EDWARDPJ26/microohmetro-uis/informe/Informe_final_micro-ohmimetro_v2.pdf

### UNIVERSIDAD INDUSTRIAL DE SANTANDER

Escuela de Ingenierías Eléctrica, Electrónica y de Telecomunicaciones

## DISEÑO DE UN MICRO-OHMÍMETRO DE PRECISIÓN

## 1 mΩ – 1 Ω, portátil, con medición Kelvin de 4 hilos

Informe final consolidado – versión 2 (con las correcciones del docente)

Edward Andrés Pacheco Jurado – 2222236 – A1A

Joseph Thomas Albarracín Contreras – 2220415 – A1B

Diseño de Sistemas Electrónicos Docente: Jaime Barrero

Bucaramanga, Santander – 2026

Repositorio de respaldo (esquemáticos, PCB, Gerbers, simulaciones, datos, firmware, imágenes en alta resolución y datasheets): github.com/EDWARDPJ26/microohmetro-uis (versión etique-tada v1.0).

Micro-ohmímetro de precisión – versión 2 | UIS – E3T

### Índice

Resumen | 1
1. Requerimientos y correcciones atendidas | 1
2. Arquitectura general | 2
3. Fuente de corriente pulsada de dos niveles | 3
4. Medición Kelvin y adquisición con el AD7124-4 | 3
5. Energía: USB-C PD, cargador, polaridad y regulación | 4
6. Microcontrolador y firmware | 4
7. Simulaciones (PSpice 22.1) | 4
8. Presupuesto de error | 6
9. Diseño de PCB | 6
10.Materiales, BOM y datasheets | 9
11.Aplicación móvil | 9
12.Conclusiones | 10
13.Trabajo futuro | 10
A. Esquemático completo (hojas de detalle) | 11
B. Repositorio de respaldo | 15

i

### Índice de figuras

1. Esquemático, hoja raíz: diagrama de bloques y flujo de señales (rojo: potencia, verde:
| medición, morado: control) | | 2
2. | Hoja 4: fuente de corriente pulsada (cadena cableada pin a pin) | | 3
3. | Cadena de medición | | 4
4. S2: pulso de dos niveles (IL → IH a 12 ms, apagado a 20 ms). Sin sobrepico; asenta-
| miento de 3,3 ms al 0,01 % | | 5
5. | S4: Montecarlo (300 corridas). Izquierda: σ = 0,057 %. Derecha: σ = 88 % en 10 mΩ. . | 5
6. | Vistas 3D de la PCB (render de KiCad 10) | | 7
7. | Plano mecánico acotado: 64 mm × 116 mm | | 8
8. | Pantallas de medición y gráfica de la aplicación | | 10
9. | Esquemático, página 2: Entrada USB-C y Power Delivery | | 11
10. Esquemático, página 3: Cargador y batería | | 12
11. Esquemático, página 4: Regulación 3,3 V | | 13
12. Esquemático, página 8: Microcontrolador ESP32-C3 | | 14
13. Esquemático, página 9: Mecánicos y puntos de prueba | | 15

### Índice de tablas

1. | Correcciones del docente y cómo se atendieron | | 1
2. | Especificaciones del instrumento | | 2
3. Configuración de canales del AD7124-4 (referencia interna de 2,5 V, post-filtro de 25
| SPS) | | 3
4. | Presupuesto energético sobre SYS | | 4
5. | Resultados DC (S1): idénticos con SYS = 3,5 V y 4,35 V | | 5
6. | S3: efecto del offset del OPA388 y de la FEM termoeléctrica (RDUT = 1 mΩ) | | 5
7. | S4/S5: Montecarlo y sensibilidad (Worst-Case) | | 6
8. | Presupuesto de error estimado (RDUT = 1 mΩ, una medición) | | 6
9. | Especificaciones físicas de la PCB | | 8
10. Materiales de resistencias y capacitores | | 9
11. Componentes principales y enlaces a datasheets | | 9

ii

### Resumen

Se presenta el diseño completo de un micro-ohmímetro portátil para el rango 1 mΩ–1 Ω. La versión 2 incorpora todas las correcciones del docente: corriente de prueba pulsada de 1,04 A, referencia de tensión integrada (sin divisores), medición Kelvin con bornes banana de 4 mm, uso del PGA, buffers y filtros del AD7124-4, medición ratiométrica de dos niveles que cancela offsets y FEM termoeléctricas, cargador conmutado rápido con USB-C Power Delivery, protección contra polaridad inversa, microcontrolador actualizado ESP32-C3 con USB nativo y OTA, batería LiPo integrada en la PCB y análisis de Montecarlo y peor caso. Las simulaciones en PSpice con los modelos oficiales de TI muestran un error sistemático de −0,0054 % (calibrable), inmunidad total a una FEM de ±10 µV y una dispersión por tolerancias igual a la del shunt: σ = 0,057 % con un shunt del 0,1 %. El diseño anterior, con amplificador diferencial discreto, presentaba σ = 88 % en 10 mΩ.

### 1. Requerimientos y correcciones atendidas

Tabla 1: Correcciones del docente y cómo se atendieron.

Corrección | Solución en la versión 2
Protección de polaridad de la batería | 2×AO3401A en paralelo (P-MOS, ≈43 mΩ), sección 5.
Bornes banana Kelvin y conector de batería seguro | 4 bornes de 4 mm (I+, S+, S−, I−); JST XH SMD de 3 pines con NTC.
Vref estable sin divisores | REF3325 (2,5 V, 0,15 %, 30 ppm/ ◦C).
Corriente de 1–2 A, pulsada | 1,042 A / 0,502 A, pulsos de 120 ms cada 1 s.
Offset del OPA391 | OPA388 zero-drift + medición ratiométrica de 2 niveles; simulado con ±VOS.
USB único para carga y progra- mación | USB-C: VBUS al cargador, D+/D− al USB nativo del ESP32-C3.
ESP32 NRND | ESP32-C3-WROOM-02 (RISC-V, BLE 5, USB-Serial/JTAG).
Carga más rápida | BQ25895 conmutado, 2 A (1C), ≈1,5 h.
USB-C PD 240 W y materiales | STUSB4500 (sink, 9 V/2 A, compatible con cargadores EPR); ta- bla 10.
OTA, PGA y filtros del ADC | Particiones OTA dobles; PGA 128/16/2, buffers y post-filtro de 25 SPS.
Montecarlo de tolerancias | 300 corridas + Worst-Case en PSpice, sección 7.
Footprints y 3D; batería en la PCB; placa compacta | Footprints oficiales de KiCad 10; LiPo en la cara inferior, sección 9.
Informe único, imágenes y GitHub | Este documento; figuras vectoriales; repositorio enlazado.

Tabla 2: Especificaciones del instrumento.

Rango | 1 mΩ – 1 Ω (3 rangos automáticos del PGA)
Corriente de prueba | 1,042 A y 0,502 A, pulsada (120 ms / 1 s)
Resolución (1 mΩ, una lectura) | ≈0,011 % (ruido 0,063 µV rms, G = 128)
Error por tolerancias (sin calibrar) | ±0,1 % con shunt de 0,1 %
Alimentación | LiPo 1S 2000 mAh; USB-C PD (5/9 V)
Autonomía (estimada) | ≈10 h midiendo; ≈40 h en reposo
Comunicación | BLE 5 (aplicación Android) y USB
PCB | 4 capas, 64 mm × 116 mm, batería en la cara inferior

### 2. Arquitectura general

La figura 1 es la hoja raíz del esquemático jerárquico (KiCad 10). Cada bloque es una hoja de detalle (anexo A). La medición se basa en:

RDUT = RS

VDUT,H − VDUT,L

VRS,H − VRS,L

(1)

donde H y L son los dos niveles de corriente y VRS es la caída en el shunt RS = 0,12 Ω. La ecuación (1) no depende del valor exacto de la corriente, de la referencia ni de la ganancia del INA181, y la diferencia
entre niveles cancela offsets del ADC y FEM termoeléctricas de los contactos. 1 | 2 | 3 | 4 | 5 | 6 | 7 | 8
1 | 2 | 3 | 4 | 5 | 6 | 7 | 8

AB

Archivo: 1_usb_pd.kicad_sch SYS (alimenta OPA388 C | Archivo: 5_kelvin_shunt.kicad_sch 1. Entrada USB-C y Power Delivery Archivo: 2_cargador.kicad_sch y P-MOS) I_OFF / I_LOW (pulso de 2 niveles) 5. Medicion Kelvin y shunt | Archivo: 6_adc.kicad_sch Archivo: 3_regulacion.kicad_sch 6. ADC AD7124-4 | +3V3 | 7. Microcontrolador ESP32-C3 SPI ⁻> AVDD (analogico del ADC). Archivo: 7_mcu.kicad_sch 8. Mecanicos y puntos de prueba / AVDD
U401 REF3325 -> R401 -> VSET -> R403 -> U402 OPA388 -> R404 -> Q403 P-MOS -> I_PLUS. I = VSET / (20 x RS) = 1,042 A / 0,502 A. | I_PLUS | INA181 cierra el lazo. | Pagina 6 | S+/S-, RS+/RS- | S+/S- -> 1k + 1n + 10n dif -> AIN0/AIN1 (PGA 128/16/2). RS+/RS- -> 100 + 1n -> AIN2/AIN3 (G=16). SPI al ESP32. Pagina 7

D

E

F

AB

C

D

E

Size: A3 | Rev: 2.0
KiCad E.D.A. 10.0.6 | Id: 1/9 | F Date: 2026-11-07

Title: Micro-ohmimetro v2 - Diagrama general

File: microohmetro_v2.kicad_sch

Sheet: /

Universidad Industrial de Santander - E3T

Micro-ohmimetro de precision 1 mOhm - 1 Ohm

E. A. Pacheco J. (2222236) - J. T. Albarracin C. (2220415)

Diseno de Sistemas Electronicos - Prof. Jaime Barrero

Archivo: 8_mecanicos.kicad_sch 4. Fuente de corriente pulsada

Archivo: 4_fuente_corriente.kicad_sch

| 2. Cargador y bateria | 3. Regulacion 3,3 V
VBUS_C -> TVS -> Q101 (abre solo con contrato PD de 9 V) -> VBUS_IN. CC1/CC2 al STUSB4500; D+/D- con ESD al ESP32. Pagina 2 | VBUS_IN | | SYS | SYS -> AP2112K-3.3 -> +3V3 (digital) -> FB401 | USB nativo (programacion y consola), SPI al ADC, I2C al cargador y al PD, control del pulso I_OFF / I_LOW, LED. Pagina 8

INA_OUT

VBUS_IN -> BQ25895 (buck 1,5 MHz) -> L201 ->
SYS. BAT -> Q201||Q202 (polaridad) -> LiPo. TS

I_PLUS -> DUT -> I_MINUS -> RS (0,12 Ohm, 4T) -> R_LIFT -> GND. S+/S- y RS+/RS- van al ADC;

Pagina 5

Pagina 4

I2C + BQ_INT

Agujeros M3, puntos de prueba y bandera de GND.

Pagina 9

con NTC.

Micro-ohmimetro de precision 1 mOhm - 1 Ohm | Diagrama de bloques y flujo de senales (v2)
Rojo: potencia | Verde: senal de medicion | Morado: control digital. | Cada bloque es una hoja (doble clic para abrirla).
| | | USB D+/D- (programacion y consola)

Pagina 3

R_DUT = RS * (V_DUT,H - V_DUT,L) / (V_RS,H - V_RS,L) | (medicion ratiometrica de 2 niveles)
I_H = V_REF / (G_INA * RS) = 2,5 / (20 * 0,12) = 1,042 A | I_L = 0,502 A | Pulso: 120 ms cada 1 s Referencias numeradas por hoja: R4xx = pagina 5 (fuente), C6xx = pagina 7 (ADC), etc.

Figura 1: Esquemático, hoja raíz: diagrama de bloques y flujo de señales (rojo: potencia, verde: medición, morado: control).
Fuente: elaboración propia en KiCad 10; archivo hardware/kicad/microohmetro_v2.kicad_sch. (https://github.com/EDWARDPJ26/microohmetro-uis/blob/v1.0/hardware/kicad/microohmetro_v2.kicad_sch)

### 3. Fuente de corriente pulsada de dos niveles

La REF3325 fija VSET a través de R401 (10 kΩ) y C402 (22 nF, arranque suave). El OPA388 compara VSET con la salida del INA181A1 (G = 20 V/V) y controla el P-MOS NTD25P03L (DPAK):

I =

VSET

GINA RS

=

2,5 V
20 · 0,12 Ω = 1,042 A, IL =

1,205 V
2, 4
= 0,502 A. | (2)

Q402 conecta 9,31 kΩ para el nivel bajo y Q401 anula VSET (corriente apagada por defecto al arrancar). La referencia sigue siendo la REF3325; el valor exacto de IL no influye porque VRS se mide en ambos niveles. La disipación pico del P-MOS es 3,5W, con 0,43W de promedio al 12 % de ciclo útil (≈22 ◦C). El margen de tensión en el peor caso (1 Ω, batería en 3,5 V) es 1,52 V.

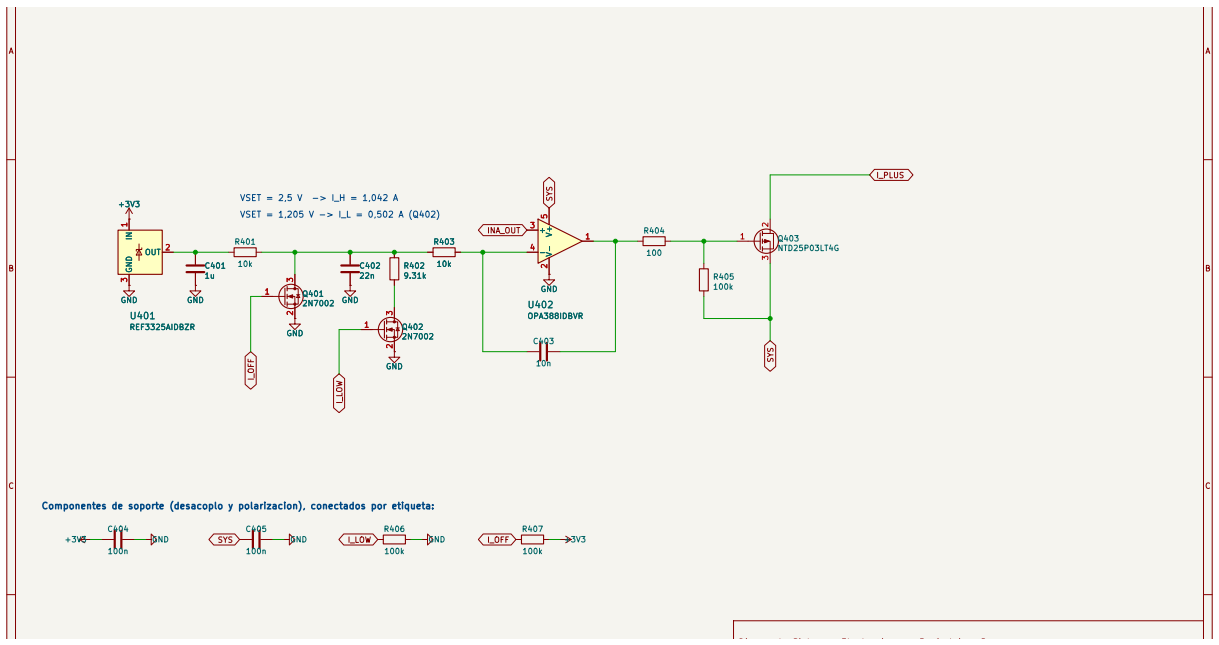
[picture p11: figure]
OPA388IDBVR; GND; 100k GND; 2 3 Q403 NTD25P03LT4G +3V3 C404; GND IN; 1 OUT 2 GND; REF3325AIDBZR; 10k +3V3 GND; 9.31k GND I_LOW I_LOW; I_PLUS; I_OFF; SYS I_OFF SYS; INA_OUT; SYS; VSET = 1,205 V -> I_L = 0,502 A (Q402); OPA388IDBVR V-; 4 GND; GNDQ402 2N7002; 9.31k GND Q401; 2 3 GND U401; REF3325AIDBZR IN; 3 GND; C401 1u GND

Diseno de Sistemas Electronicos - Prof. Jaime Barrero V-

Componentes de soporte (desacoplo y polarizacion), conectados por etiqueta: VSET = 2,5 V -> I_H = 1,042 A

Figura 2: Hoja 4: fuente de corriente pulsada (cadena cableada pin a pin).

### 4. Medición Kelvin y adquisición con el AD7124-4

I+ e I− conducen la corriente; S+ y S− solo miden tensión. El shunt de 4 terminales (WSK2512) entrega VRS al INA181 y al ADC. RLIF T = 0,68 Ω eleva el modo común por encima del mínimo del PGA (VCM ≥ 0,1 V + 0,5 V/G; nota 8 del datasheet). Las entradas llevan 1 kΩ + 1 nF C0G por línea, 10 nF C0G diferencial y clamp BAT54S.

Tabla 3: Configuración de canales del AD7124-4 (referencia interna de 2,5 V, post-filtro de 25 SPS).

Canal | Entradas | PGA | Rango | Uso
CH0 | AIN0/AIN1 (S+/S−) | 128 | ±19,5 mV | R ≤ 15 mΩ
CH1 | AIN0/AIN1 | 16 | ±156 mV | R ≤ 120 mΩ
CH2 | AIN0/AIN1 | 2 | ±1,25 V | R ≤ 1 Ω
CH3 | AIN2/AIN3 (RS) | 16 | ±156 mV | VRS = 60/125 mV

AB

C

Diseno de Sistemas Electronicos - Prof. Jaime Barrero

C501

100n | +3V3 +3V3 | GND

1

2

3

4 R501

0.12 1% 4T 1

J503 S_MINUS (azul) 1

# J501 I_PLUS (rojo) GND

R502
0.68

1

J504 I_MINUS (negro) 1

J502 S_PLUS (amarillo) | 1 GND 2 +

3 -
4 | REF 5 V+

6 U501

INA181A1IDBVR

GND GND

S_PLUS | RS_SP S_MINUS

INA_OUT RS_SN

I_PLUS

Kelvin)

R_LIFT eleva el modo comun >= 0,40 V (requisito del PGA con G > 1).

Componentes de soporte (desacoplo y polarizacion), conectados por etiqueta:

(pinzas

I+ e I- llevan la corriente; S+ y S- solo miden tension (sin corriente).

DUT

externo

U501
INA181A1IDBVR

1 GND 2 +

3 -
4 | REF 5 V+

6 GND GND +3V3 R502

0.68 GND

(a) Hoja 5: bornes Kelvin, shunt e INA181.

AB

C

AB

C

Diseno de Sistemas Electronicos - Prof. Jaime Barrero

C611
100n GND

C603
10n | +3V3 GND

C604

1nC602
1n R603
100 | GND | +3V3 GND
A1 | K
2 COM3 D601

# BAT54S GND +3V3 GND

C605
1n
A1 | K
2 COM3 D602

BAT54S GND

GND

R601
1k C609
1u | C610
1u +3V3 | R605
10k | +3V3 | GND

C606
100n R604
100 | GND

C608
100n GND
GND

GND

GND

REGCAPD 1 IOVDD

2 DGND

3

AIN0/IOUT/VBIAS 4
AIN1/IOUT/VBIAS 5 | DNC 6 DNC 7
AIN2/IOUT/VBIAS/P1 8
AIN3/IOUT/VBIAS/P2 9 | DNC 10 DNC 11 REFIN1(+) 12 REFIN1(-) 13 | DNC 14 DNC 15
AIN4/IOUT/VBIAS 16
AIN5/IOUT/VBIAS 17 | DNC 18 DNC 19
AIN6/IOUT/VBIAS/REFIN2(+) 20
AIN7/IOUT/VBIAS/REFIN2(-) 21 | REFOUT 22 AVSS 23 | REGCAPA 24 PSW 25 AVDD 26

## SYNC 27 DOUT/RDY 28 DIN 29 SCLK 30 CLK 31 CS 32 EP 33

U601

AD7124-4BBCPZ-RL7 C601
1n GND

GND GND

R602

1k | C607

100n RS_SP

SPI_CS

SPI_MISO

RS_SN

SPI_SCLK

S_MINUS

S_PLUS

AVDD

SPI_MOSI AVDD

AVDD

SPI_CS

AVDD

Componentes de soporte (desacoplo y polarizacion), conectados por etiqueta:

GND

C605
1n | GND U601
AD7124-4BBCPZ-RL7 | REGCAPD 1 IOVDD

2 DGND

3

AIN0/IOUT/VBIAS 4
AIN1/IOUT/VBIAS 5 | DNC 6 DNC 7
AIN2/IOUT/VBIAS/P1 8
AIN3/IOUT/VBIAS/P2 9 | DNC 10 DNC 11 REFIN1(+) 12 REFIN1(-) 13 | DNC 14 DNC 15
AIN4/IOUT/VBIAS 16
AIN5/IOUT/VBIAS 17 | DNC 18 DNC 19
AIN6/IOUT/VBIAS/REFIN2(+) 20
AIN7/IOUT/VBIAS/REFIN2(-) 21 | REFOUT 22 AVSS 23 | REGCAPA 24 PSW 25 AVDD 26
SYNC 27 DOUT/RDY 28 DIN 29 SCLK 30 CLK 31 CS 32 EP 33 GND | GND +3V3 | C607
100n | C606 100n GND

C608
100n GND
GND

C601
1n GND

C604

1nC602
1n GND

GND

(b) Hoja 6: AD7124-4 con filtros y protección.

Figura 3: Cadena de medición.

Secuencia por medición (≈240 ms): nivel IL (5 ms de asentamiento + conversión de VDUT y VRS), nivel IH (igual), corriente apagada. El firmware elige automáticamente el PGA y aplica la ecuación (1).

### 5. Energía: USB-C PD, cargador, polaridad y regulación

USB-C + STUSB4500: negocia 9 V/2 A (PDO2) o 5 V/3 A; Q101 conecta VBUS solo con un contrato válido; TVS SMBJ12A. Compatible con cargadores de 240W (EPR), que también ofrecen los perfiles estándar.
BQ25895 (buck de 1,5 MHz): ICHG = 2048 mA por I²C, IIN,max = 355/RILIM = 2,0 A, temporizador desactivado, NTC en TS (RT1 = 5,23 kΩ, RT2 = 30,1 kΩ). Carga completa en ≈1,5 h.
Polaridad inversa: 2×AO3401A en paralelo entre el conector y BAT.
AP2112K-3.3 desde SYS; AVDD del ADC filtrado con ferrita.

Tabla 4: Presupuesto energético sobre SYS.

Bloque | Corriente media | Base
Pulso de 1,042 A al 12 % | 125 mA | Diseño
ESP32-C3 con BLE | 30–45 mA | Estimado (a medir)
AD7124-4 + OPA388 + INA181 + REF | ≈3 mA | Datasheets
Total midiendo | ≈160–175 mA | ≈10 h con 2000 mAh

### 6. Microcontrolador y firmware

ESP32-C3-WROOM-02-N4: USB nativo (programación y consola sin conversor), SPI al ADC (GPIO5/6/7/10), I

2C al BQ25895 y al STUSB4500 (GPIO4/8), control del pulso (I_OFF en GPIO0, I_LOW en GPIO3), LED, RESET y BOOT. Firmware: máquina de estados de medición de dos niveles, rango automático del PGA, calibración interna del ADC por ganancia más calibración de sistema con una resistencia patrón, BLE hacia la aplicación y OTA (dos particiones de app, rollback si el ADC no responde).

### 7. Simulaciones (PSpice 22.1)

Se usaron los modelos oficiales de TI del OPA388 (OPA4388) y del INA181A1. Los cables de fuerza se simularon con 20 mΩ y los de sensado con 100 mΩ. Archivos: simulaciones/. (https://github.com/EDWARDPJ26/microohmetro-uis/blob/v1.0/simulaciones/)

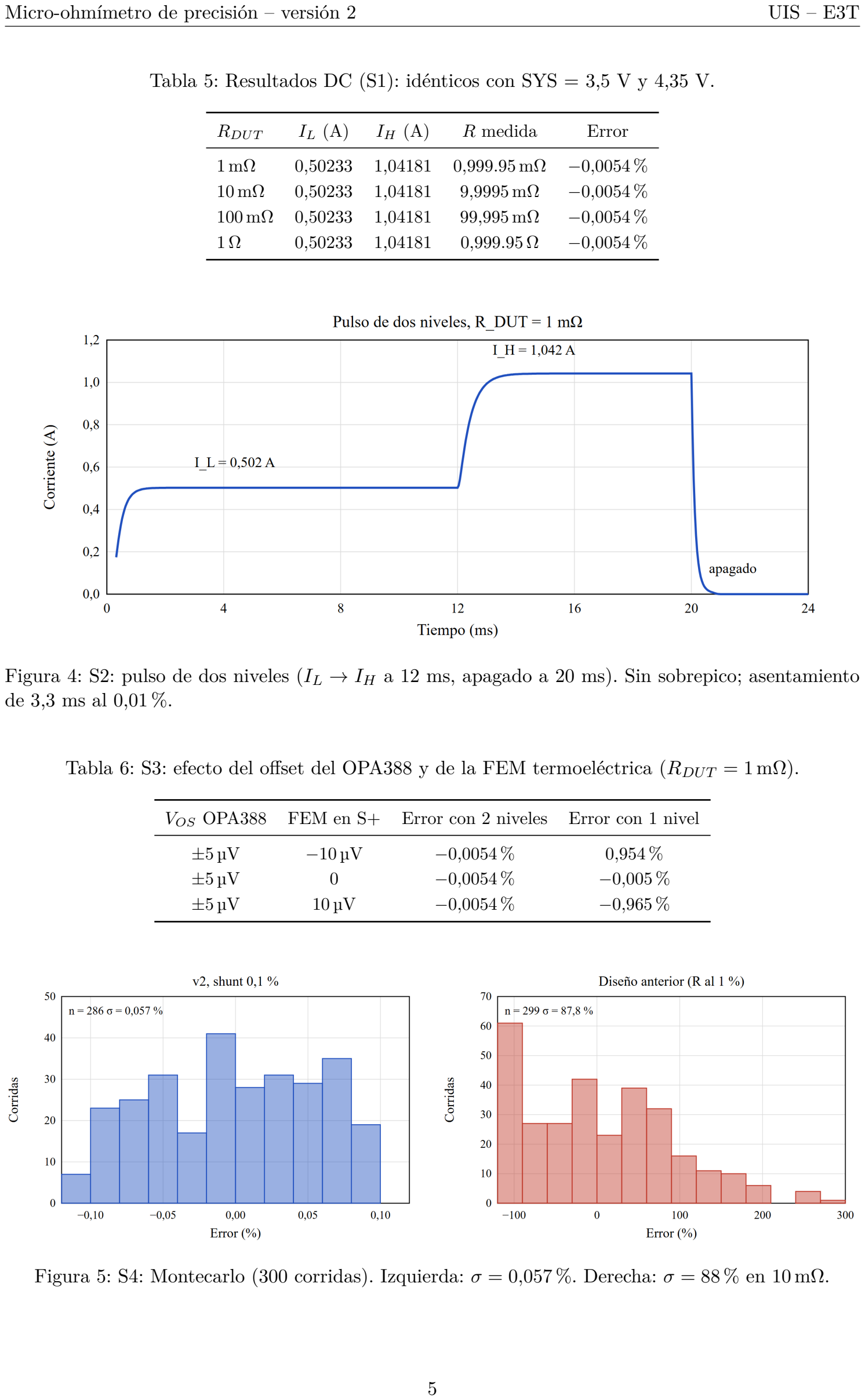
[picture p12: page 8]

Tabla 5: Resultados DC (S1): idénticos con SYS = 3,5 V y 4,35 V.

RDUT | IL (A) | IH (A) | R medida | Error
1 mΩ | 0,50233 | 1,04181 | 0,999.95 mΩ | −0,0054 %
10 mΩ | 0,50233 | 1,04181 | 9,9995 mΩ | −0,0054 %
100 mΩ | 0,50233 | 1,04181 | 99,995 mΩ | −0,0054 %
1 Ω | 0,50233 | 1,04181 | 0,999.95 Ω | −0,0054 %

Figura 4: S2: pulso de dos niveles (IL → IH a 12 ms, apagado a 20 ms). Sin sobrepico; asentamiento de 3,3 ms al 0,01 %.

Tabla 6: S3: efecto del offset del OPA388 y de la FEM termoeléctrica (RDUT = 1 mΩ).

VOS OPA388 | FEM en S+ | Error con 2 niveles | Error con 1 nivel
±5 µV | −10 µV | −0,0054 % | 0,954 %
±5 µV | 0 | −0,0054 % | −0,005 %
±5 µV | 10 µV | −0,0054 % | −0,965 %

Figura 5: S4: Montecarlo (300 corridas). Izquierda: σ = 0,057 %. Derecha: σ = 88 % en 10 mΩ.

Tabla 7: S4/S5: Montecarlo y sensibilidad (Worst-Case).

Caso | Media | σ | Rango
v2, RS 1 %, 1 mΩ | 0,025 % | 0,57 % | ±0,99 %
v2, RS 1 %, 1 Ω | 0,022 % | 0,56 % | ±0,99 %
v2, RS 0,1 %, 1 mΩ | −0,001 % | 0,057 % | ±0,11 %
Diseño anterior, 10 mΩ | 5,7 % | 88 % | −100 . . . +284 %

Sensibilidad: RS −0, 99 %/ %; R_FP +0, 047; R_FN −0, 035; resto ≤ 0, 012. Peor caso total: +1, 02 %.

### 8. Presupuesto de error

Tabla 8: Presupuesto de error estimado (RDUT = 1 mΩ, una medición).

Fuente | Contribución | Tratamiento
Tolerancia de RS (0,1 %) | 0,10 % | Calibración con patrón → 0,01 %
TCR de RS (50 ppm/°C, ∆T = 10 ◦C) | 0,05 % | Pulsado (bajo autocalentamiento)
Ruido del ADC (G = 128) | 0,011 % | Promedio ×16 → 0,003 %
Bias del INA181 (sistemático) | 0,0054 % | Calibración
Offset ADC/OPA y FEM | ≈0 | Cancelado (2 niveles)
RSS sin calibrar / calibrado | 0,11 % / 0,05 %

### 9. Diseño de PCB

PCB de 4 capas (F.Cu señal, In1 GND sólido, In2 señal/GND, B.Cu señal/GND) de 64 mm × 116 mm, espesor de 1,6 mm. Zonas: superior (bornes, fuente, Kelvin y ADC, sin batería debajo), central (USB-C, PD, cargador, LDO y ESP32 con la antena en el borde derecho) y franja inferior (JST y agujeros M3). La LiPo de 2000 mAh (8×50×60 mm) va en la cara inferior. Ruteo: Freerouting más ajustes por script. Pistas: 1 mm en potencia/1 A, 0,4 mm en alimentación, 0,2 mm en señal; vías de cosido GND hacia In1.

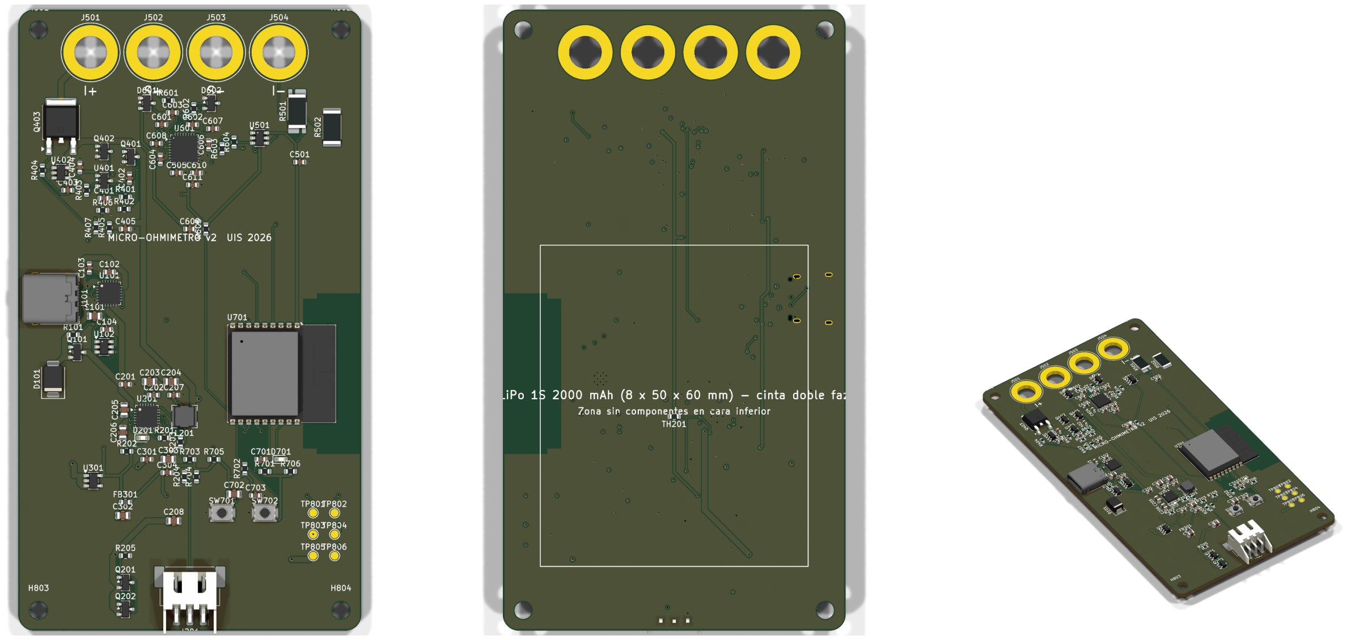
[picture p13: figure]

(a) Superior | (b) Inferior (silueta de la LiPo) | (c) Isométrica

Figura 6: Vistas 3D de la PCB (render de KiCad 10).
Fuente: hardware/kicad/microohmetro_v2.kicad_pcb; (https://github.com/EDWARDPJ26/microohmetro-uis/blob/v1.0/hardware/kicad/microohmetro_v2.kicad_pcb) modelo STEP en
| hardware/fabricacion/microohmetro_v2.step. (https://github.com/EDWARDPJ26/microohmetro-uis/blob/v1.0/hardware/fabricacion/microohmetro_v2.step)


Figura 7: Plano mecánico acotado: 64 mm × 116 mm.

Tabla 9: Especificaciones físicas de la PCB.

Dimensiones | 64 mm × 116 mm (esquinas R = 3 mm), 4 agujeros M3
Capas / espesor / cobre | 4 / 1,6 mm / 1 oz
Pista / holgura mínima | 0,15 mm / 0,15 mm
Vía estándar / mínima | 0,6/0,3 mm; vías térmicas de 0,2 mm
Acabado sugerido | ENIG (pads finos LFCSP/QFN)
Montaje | SMD (excepto bornes banana), cara superior

Estado: el DRC no reporta cortocircuitos ni violaciones de holgura;

### 10. Materiales, BOM y datasheets

Tabla 10: Materiales de resistencias y capacitores.

RS (0,12 Ω) | Shunt de 4 terminales en metal strip 2512, 1 W, TCR ≤ 50 ppm/°C, 0,1 % recomendado
Ganancia/referencia/filtro | Thin film 0,1 %, ≤ 25 ppm/°C
Resto de resistencias | Thick film 0603, 1 %
Ruta de señal | MLCC C0G/NP0 (sin efecto piezoeléctrico ni de DC bias)
Desacoplo y bulk | MLCC X7R con tensión nominal ≥ 2× la de trabajo

Tabla 11: Componentes principales y enlaces a datasheets.

Ref. | Componente | Datasheet
U601 | AD7124-4BBCPZ-RL7 | analog.com (https://www.analog.com/media/en/technical-documentation/data-sheets/ad7124-4.pdf)
U401 | REF3325AIDBZR | ti.com (https://www.ti.com/lit/ds/symlink/ref3325.pdf)
U402 | OPA388IDBVR | ti.com (https://www.ti.com/lit/ds/symlink/opa388.pdf)
U501 | INA181A1IDBVR | ti.com (https://www.ti.com/lit/ds/symlink/ina181.pdf)
Q403 | NTD25P03LT4G | onsemi.com (https://www.onsemi.com/pdf/datasheet/ntd25p03l-d.pdf)
R501 | WSK2512 (0,12 Ω) | vishay.com (https://www.vishay.com/docs/30108/wsk2512.pdf)
U201 | BQ25895RTWR | ti.com (https://www.ti.com/lit/ds/symlink/bq25895.pdf)
U101 | STUSB4500QTR | st.com (https://www.st.com/resource/en/datasheet/stusb4500.pdf)
U301 | AP2112K-3.3 | diodes.com (https://www.diodes.com/assets/Datasheets/AP2112.pdf)
U701 | ESP32-C3-WROOM-02-N4 | espressif.com (https://www.espressif.com/sites/default/files/documentation/esp32-c3-wroom-02_datasheet_en.pdf)
U102 | USBLC6-2SC6 | st.com (https://www.st.com/resource/en/datasheet/usblc6-2.pdf)
Q101, Q201/202 | AO3401A | aosmd.com (https://www.aosmd.com/res/datasheets/AO3401A.pdf)

La BOM completa (103 componentes, con MPN, footprint y especificación) está en docs/bom_kicad.csv. (https://github.com/EDWARDPJ26/microohmetro-uis/blob/v1.0/docs/bom_kicad.csv)

### 11. Aplicación móvil

La aplicación Android (Flutter) se conecta por BLE, muestra la resistencia en mΩ, el estado de la batería y de la carga, la gráfica temporal y el historial, e incluye un simulador. En la versión 2 los rangos de la aplicación corresponden a los tres rangos automáticos del PGA.


Figura 8: Pantallas de medición y gráfica de la aplicación.

### 12. Conclusiones

1. La corriente pulsada de 1,04 A multiplica por 10 la señal (1 mV en 1 mΩ) y mantiene la disipación media del P-MOS en 0,43W.
2. La medición ratiométrica de dos niveles elimina la dependencia de la referencia, de la ganancia del INA y del valor de la corriente, y cancela offsets y FEM termoeléctricas (S3: ±0,96 % → 0 %).
3. Usar el PGA del AD7124 en lugar del amplificador diferencial discreto reduce la dispersión de 88 % a 0,057 % (σ, Montecarlo).
4. El único componente crítico por tolerancia es el shunt: se recomienda uno de 0,1 % o una calibración única contra un patrón.
5. El sistema de energía (PD 9 V, carga de 2 A, polaridad inversa) permite cargar en ≈1,5 h y medir ≈10 h.

### 13. Trabajo futuro

Completar las conexiones pendientes de la PCB y el DRC; fabricar y caracterizar con resistencias patrón (1 mΩ–1 Ω); medir el consumo real del ESP32-C3; validar la estabilidad térmica del shunt y del P-MOS; cerrar el protocolo BLE con la aplicación.

A. | Esquemático completo (hojas de detalle) 1 | 2 | 3 | 4 | 5 | 6
100k | GND

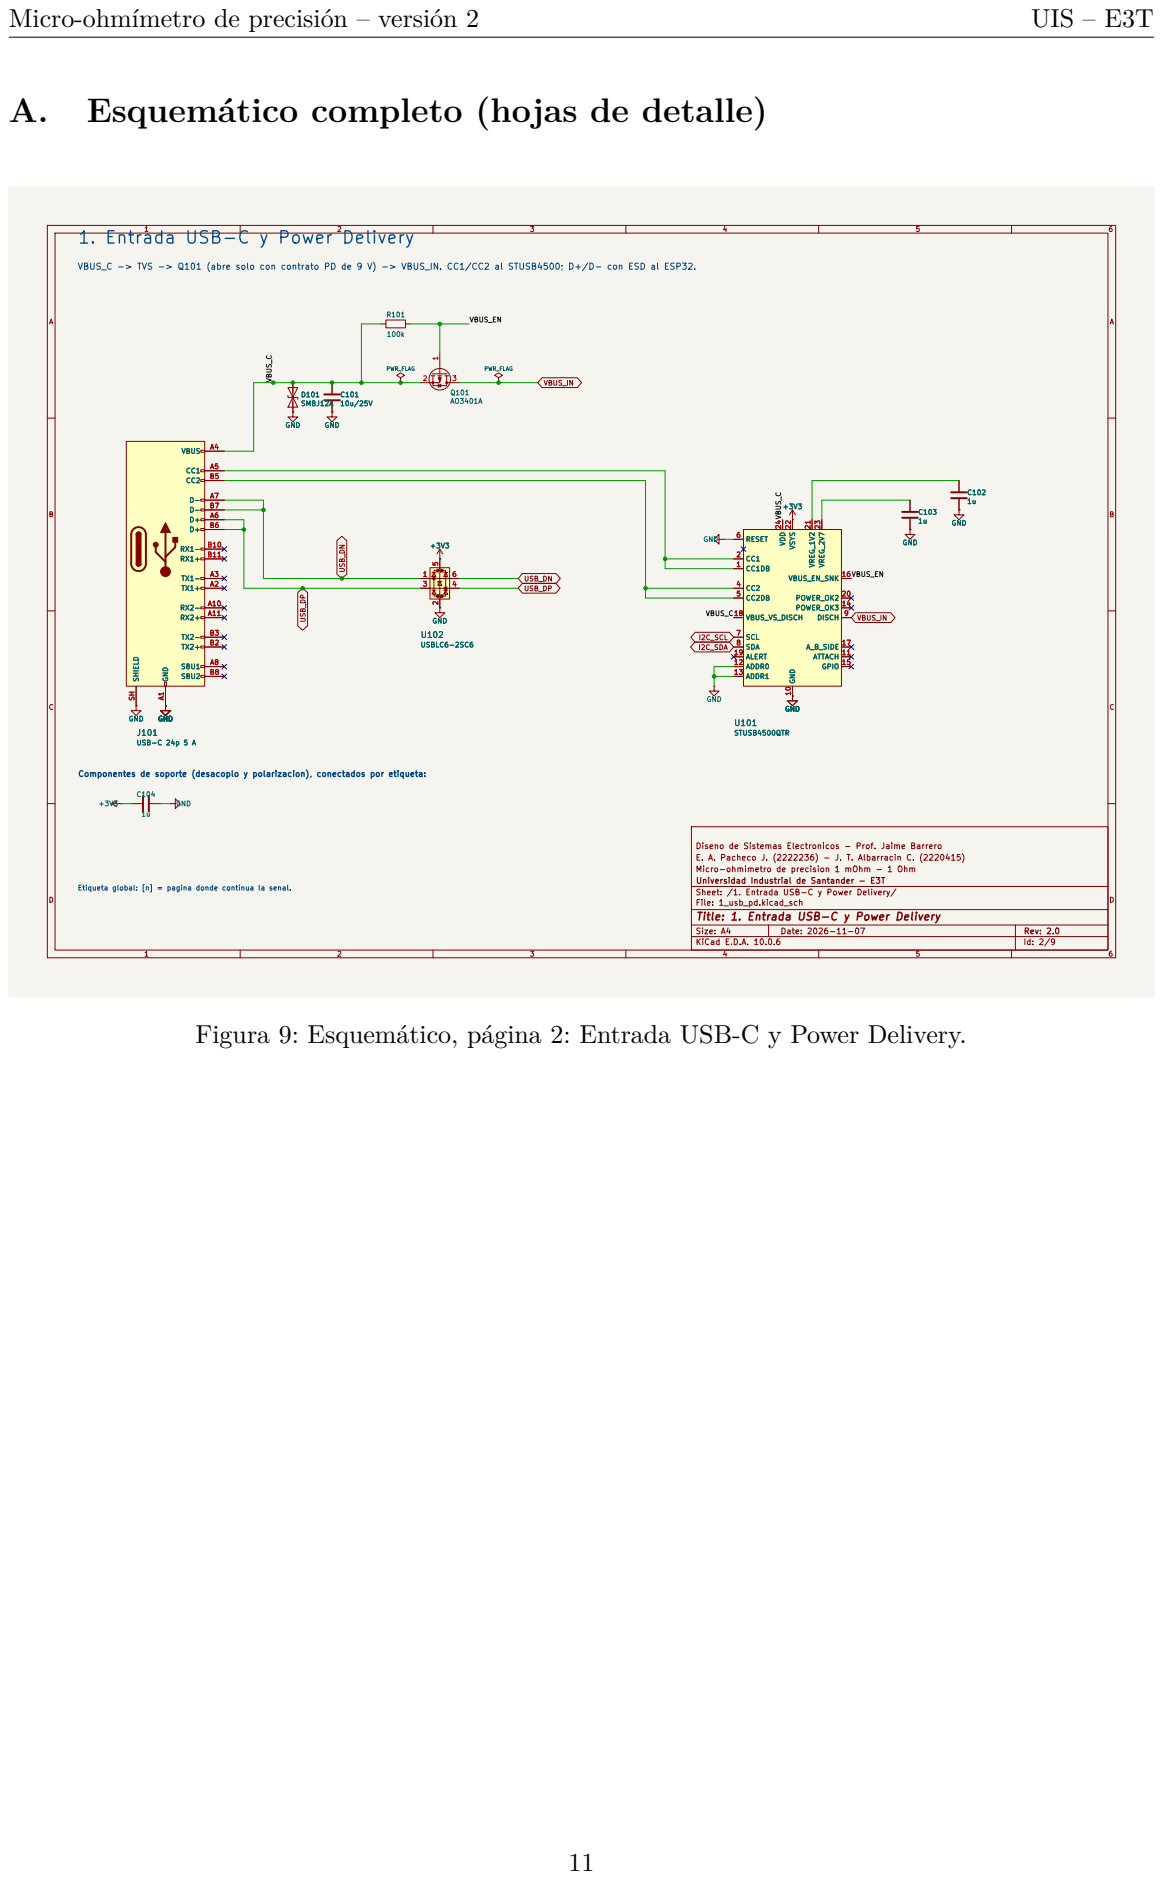
[picture p14: page 14]

1. Entrada USB-C y Power Delivery

VBUS_EN VBUS_C -> TVS -> Q101 (abre solo con contrato PD de 9 V) -> VBUS_IN. CC1/CC2 al STUSB4500; D+/D- con ESD al ESP32.

Etiqueta global: [n] = pagina donde continua la senal. Componentes de soporte (desacoplo y polarizacion), conectados por etiqueta: GND

Diseno de Sistemas Electronicos - Prof. Jaime Barrero
E. A. Pacheco J. (2222236) - J. T. Albarracin C. (2220415)
Micro-ohmimetro de precision 1 mOhm - 1 Ohm
Universidad Industrial de Santander - E3T
Sheet: /1. Entrada USB-C y Power Delivery/
File: 1_usb_pd.kicad_sch
Title: 1. Entrada USB-C y Power Delivery
KiCad E.D.A. 10.0.6

Figura 9: Esquemático, página 2: Entrada USB-C y Power Delivery.

5.23k R202

# SW 19 BTST 21 REGN 22 PMID 23 DSEL 24 U201

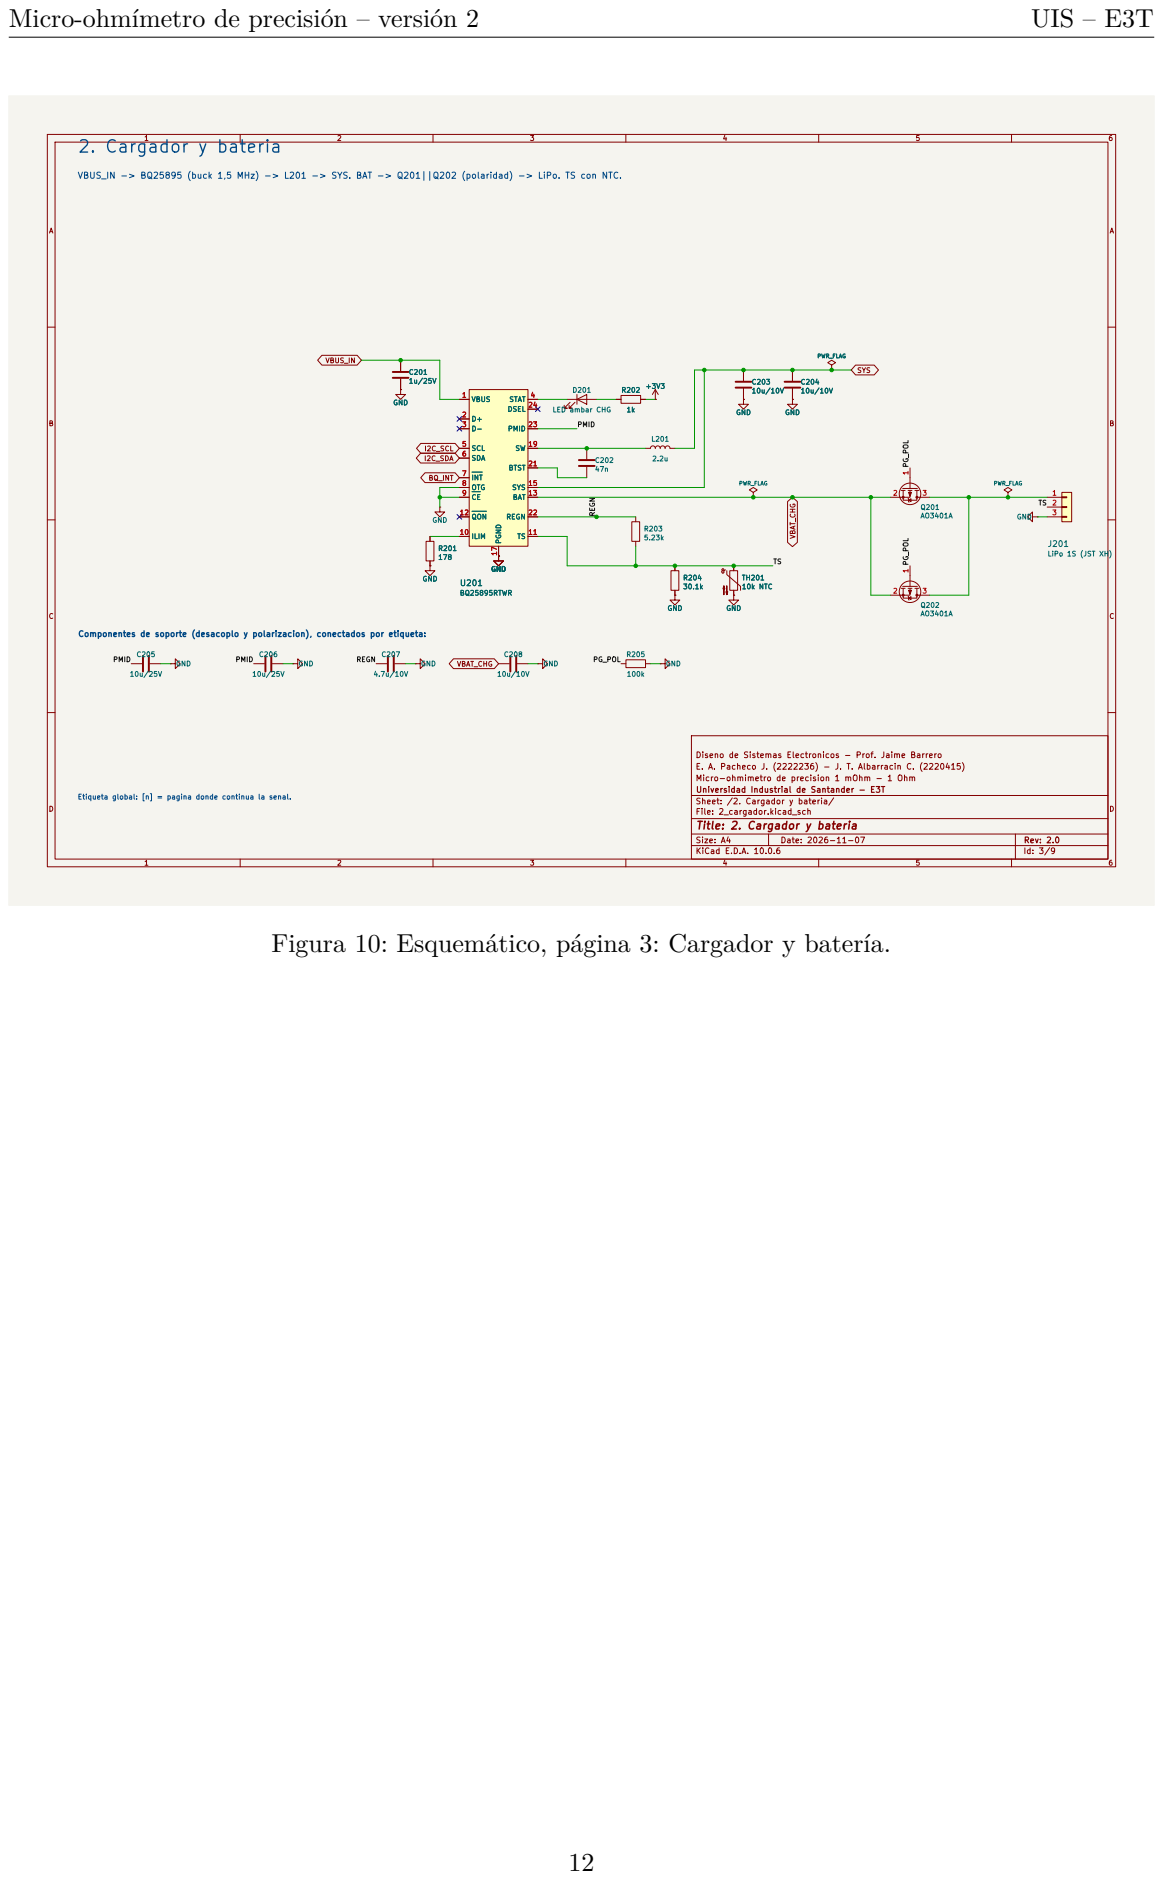
[picture p15: page 15]

Etiqueta global: [n] = pagina donde continua la senal. VBUS_IN -> BQ25895 (buck 1,5 MHz) -> L201 -> SYS. BAT -> Q201||Q202 (polaridad) -> LiPo. TS con NTC.

SW 19 BTST 21 REGN 22 PMID 23 DSEL 24 C201
1u/25V GND

LiPo 1S (JST XH) GND

Componentes de soporte (desacoplo y polarizacion), conectados por etiqueta: R201

Diseno de Sistemas Electronicos - Prof. Jaime Barrero
E. A. Pacheco J. (2222236) - J. T. Albarracin C. (2220415)
Micro-ohmimetro de precision 1 mOhm - 1 Ohm
Universidad Industrial de Santander - E3T
Sheet: /2. Cargador y bateria/
File: 2_cargador.kicad_sch
Title: 2. Cargador y bateria
KiCad E.D.A. 10.0.6

Figura 10: Esquemático, página 3: Cargador y batería.

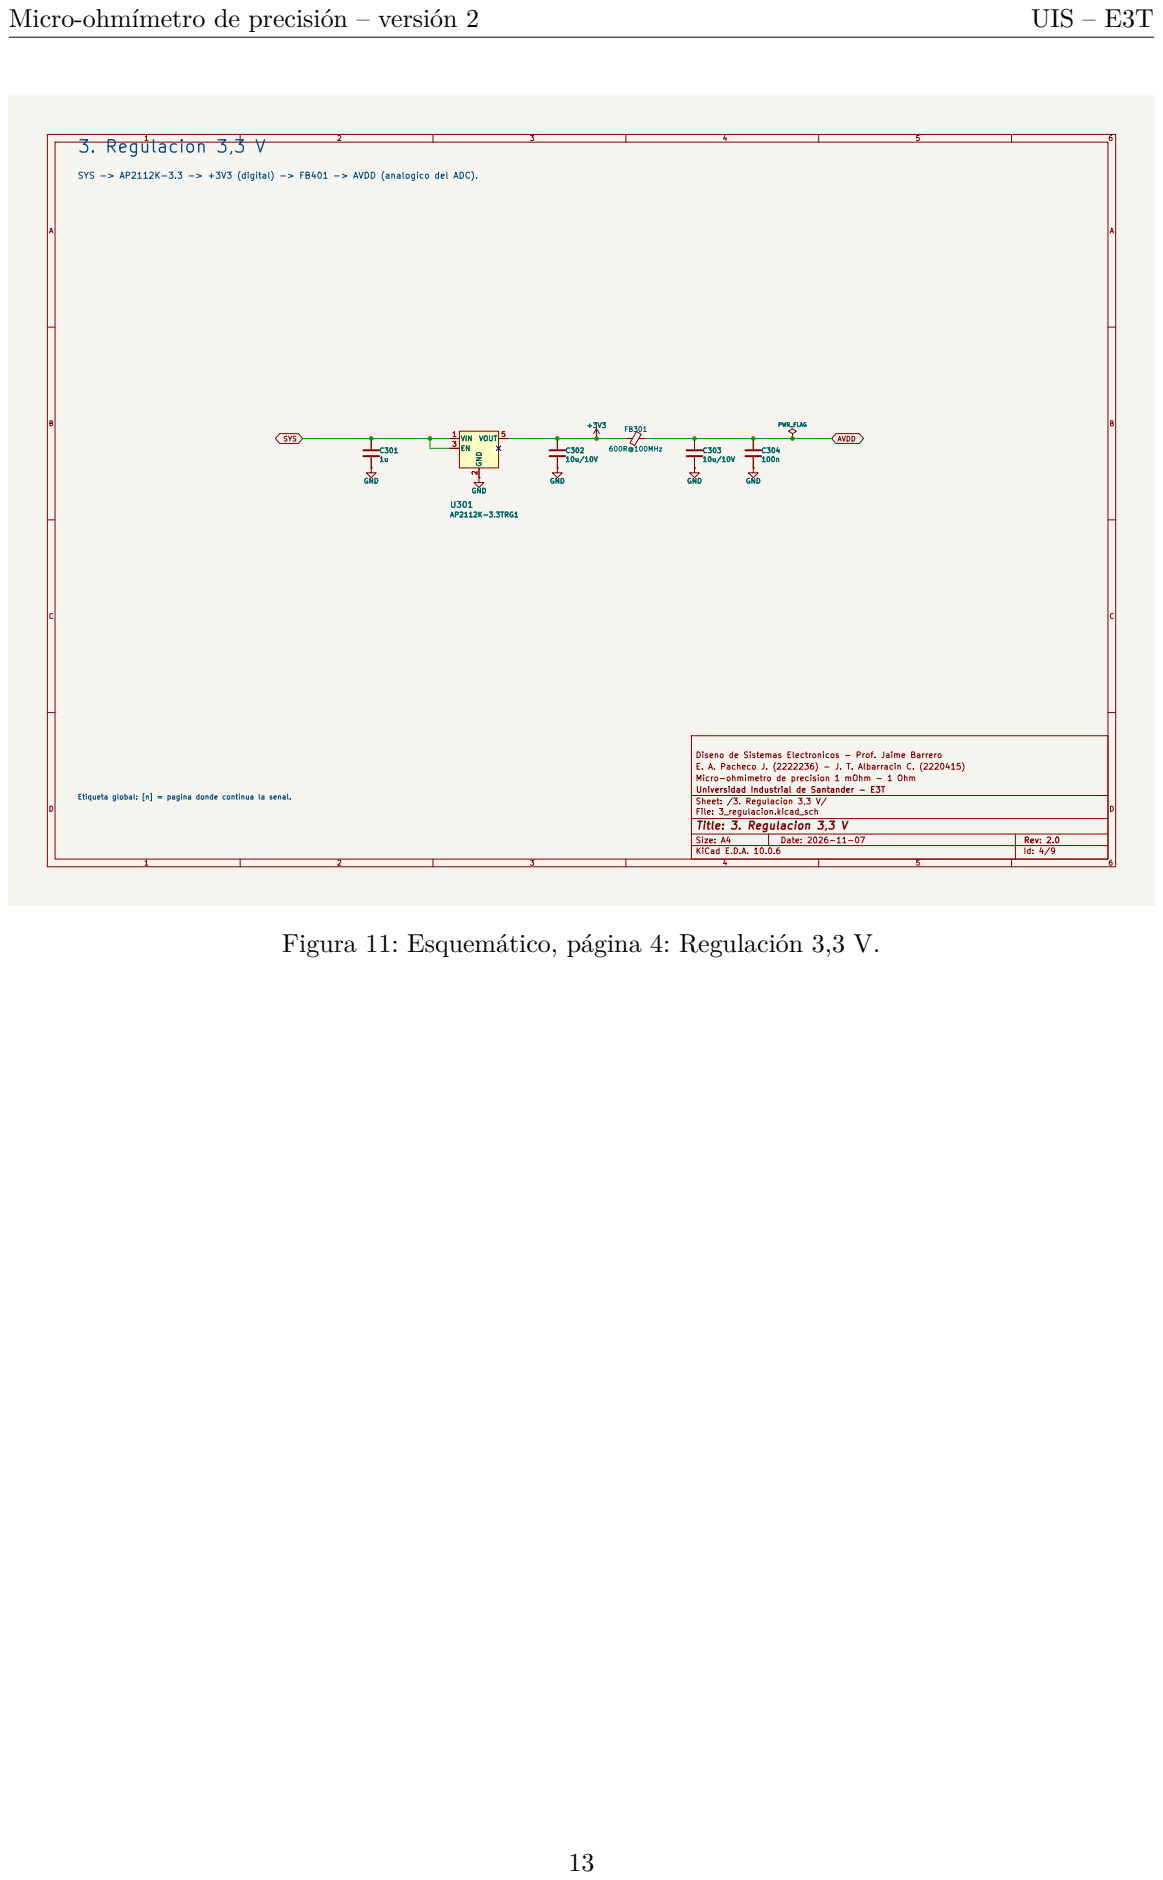
[picture p16: page 16]
Micro-ohmímetro de precisión – versión 2; UIS – E3T 1; D Date: 2026-11-07; Size: A4; Rev: 2.0; GND; 600R@100MHz +3V3 C301; 1u GND; PWR_FLAG C302; 10u/10V GND; VIN 1; VOUT 5 U301; AP2112K-3.3TRG1 GND; SYS; AVDD SYS -> AP2112K-3.3 -> +3V3 (digital) -> FB401 -> AVDD (analogico del ADC).; 3. Regulacion 3,3 V; Etiqueta global: [n] = pagina donde continua la senal.; GND +3V3 C301; 10u/10V GND U301; AP2112K-3.3TRG1; VOUT 5 GND

Diseno de Sistemas Electronicos - Prof. Jaime Barrero
E. A. Pacheco J. (2222236) - J. T. Albarracin C. (2220415)
Micro-ohmimetro de precision 1 mOhm - 1 Ohm
Universidad Industrial de Santander - E3T
Sheet: /3. Regulacion 3,3 V/
File: 3_regulacion.kicad_sch
Title: 3. Regulacion 3,3 V
KiCad E.D.A. 10.0.6

Figura 11: Esquemático, página 4: Regulación 3,3 V.

1u R703

# IO3 15 IO2 16 IO1 17 IO0 18 GND

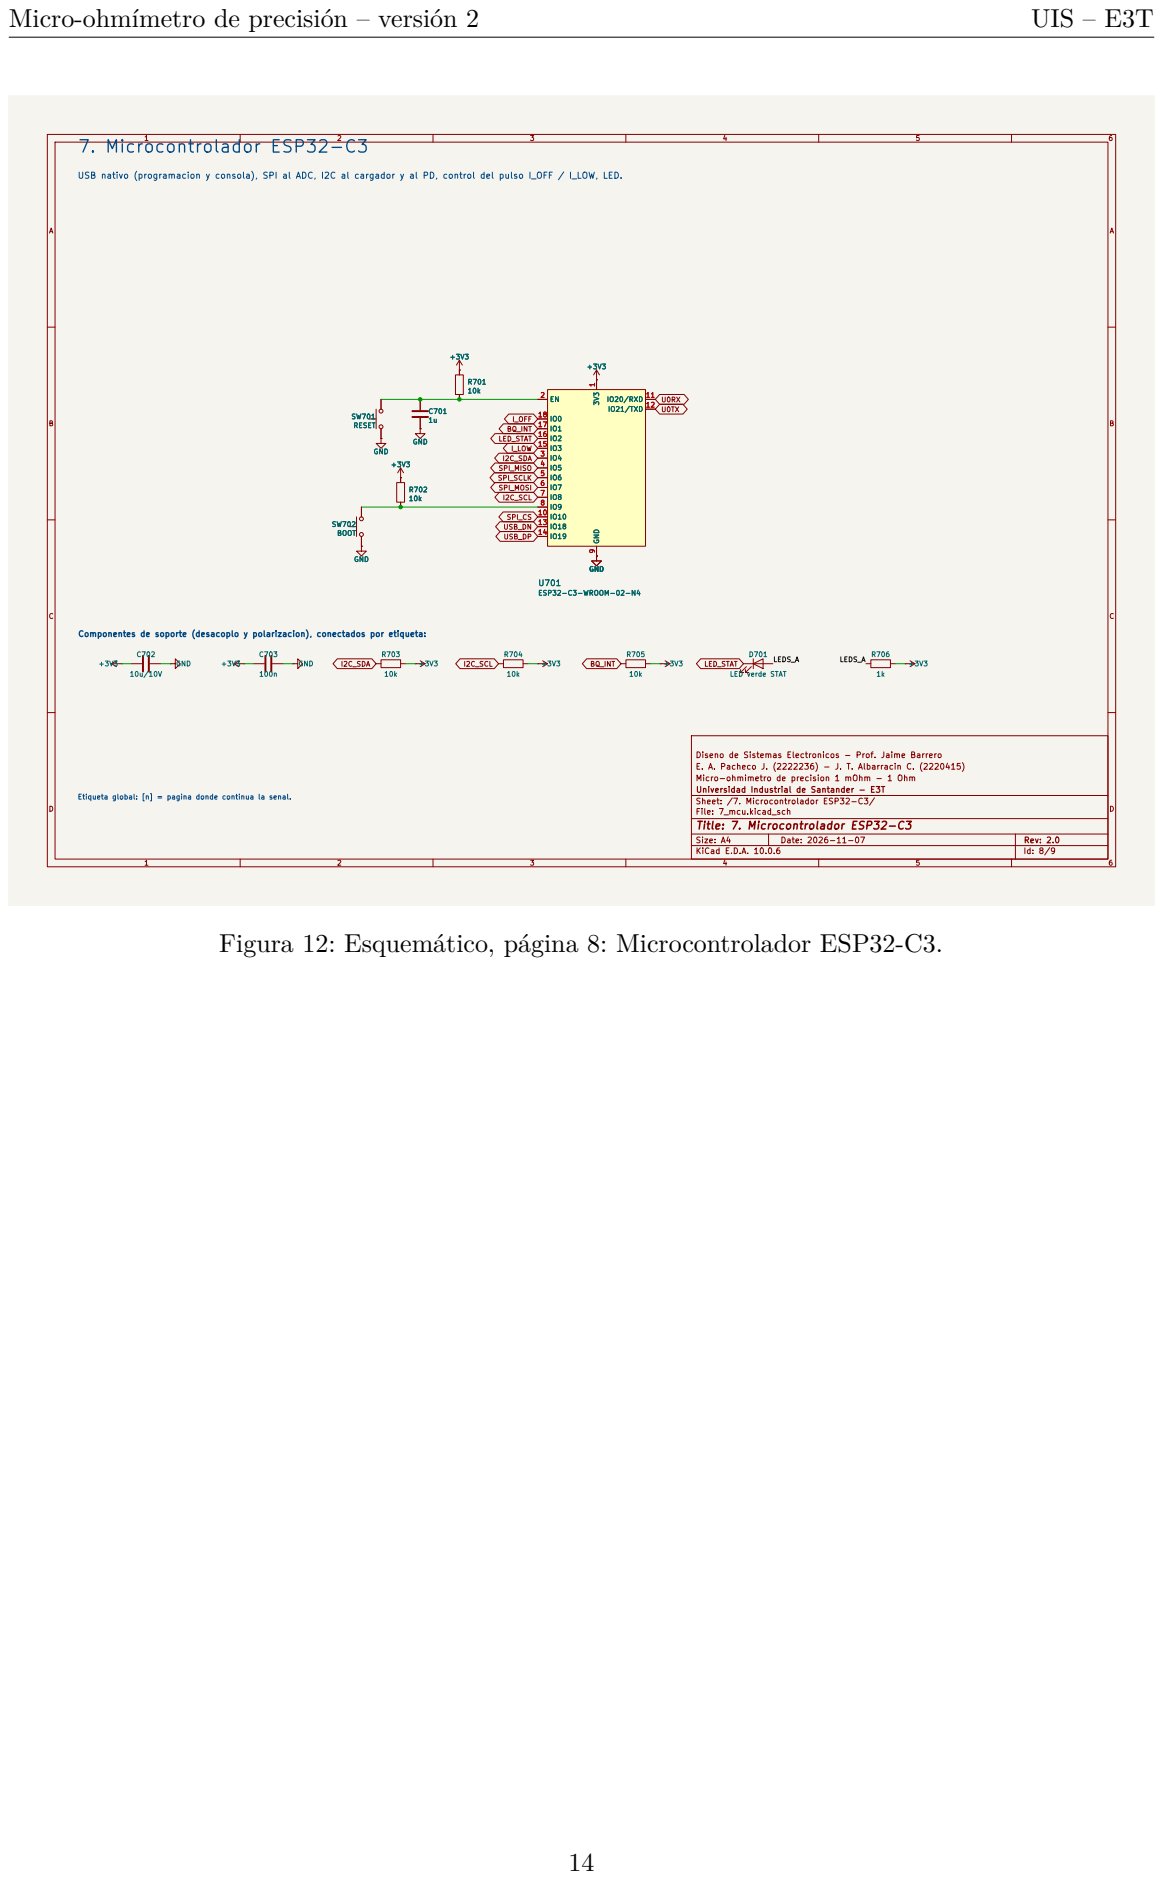
[picture p17: page 17]

Componentes de soporte (desacoplo y polarizacion), conectados por etiqueta:

Diseno de Sistemas Electronicos - Prof. Jaime Barrero
E. A. Pacheco J. (2222236) - J. T. Albarracin C. (2220415)
Micro-ohmimetro de precision 1 mOhm - 1 Ohm
Universidad Industrial de Santander - E3T
Sheet: /7. Microcontrolador ESP32-C3/
File: 7_mcu.kicad_sch
Title: 7. Microcontrolador ESP32-C3
KiCad E.D.A. 10.0.6

Figura 12: Esquemático, página 8: Microcontrolador ESP32-C3.

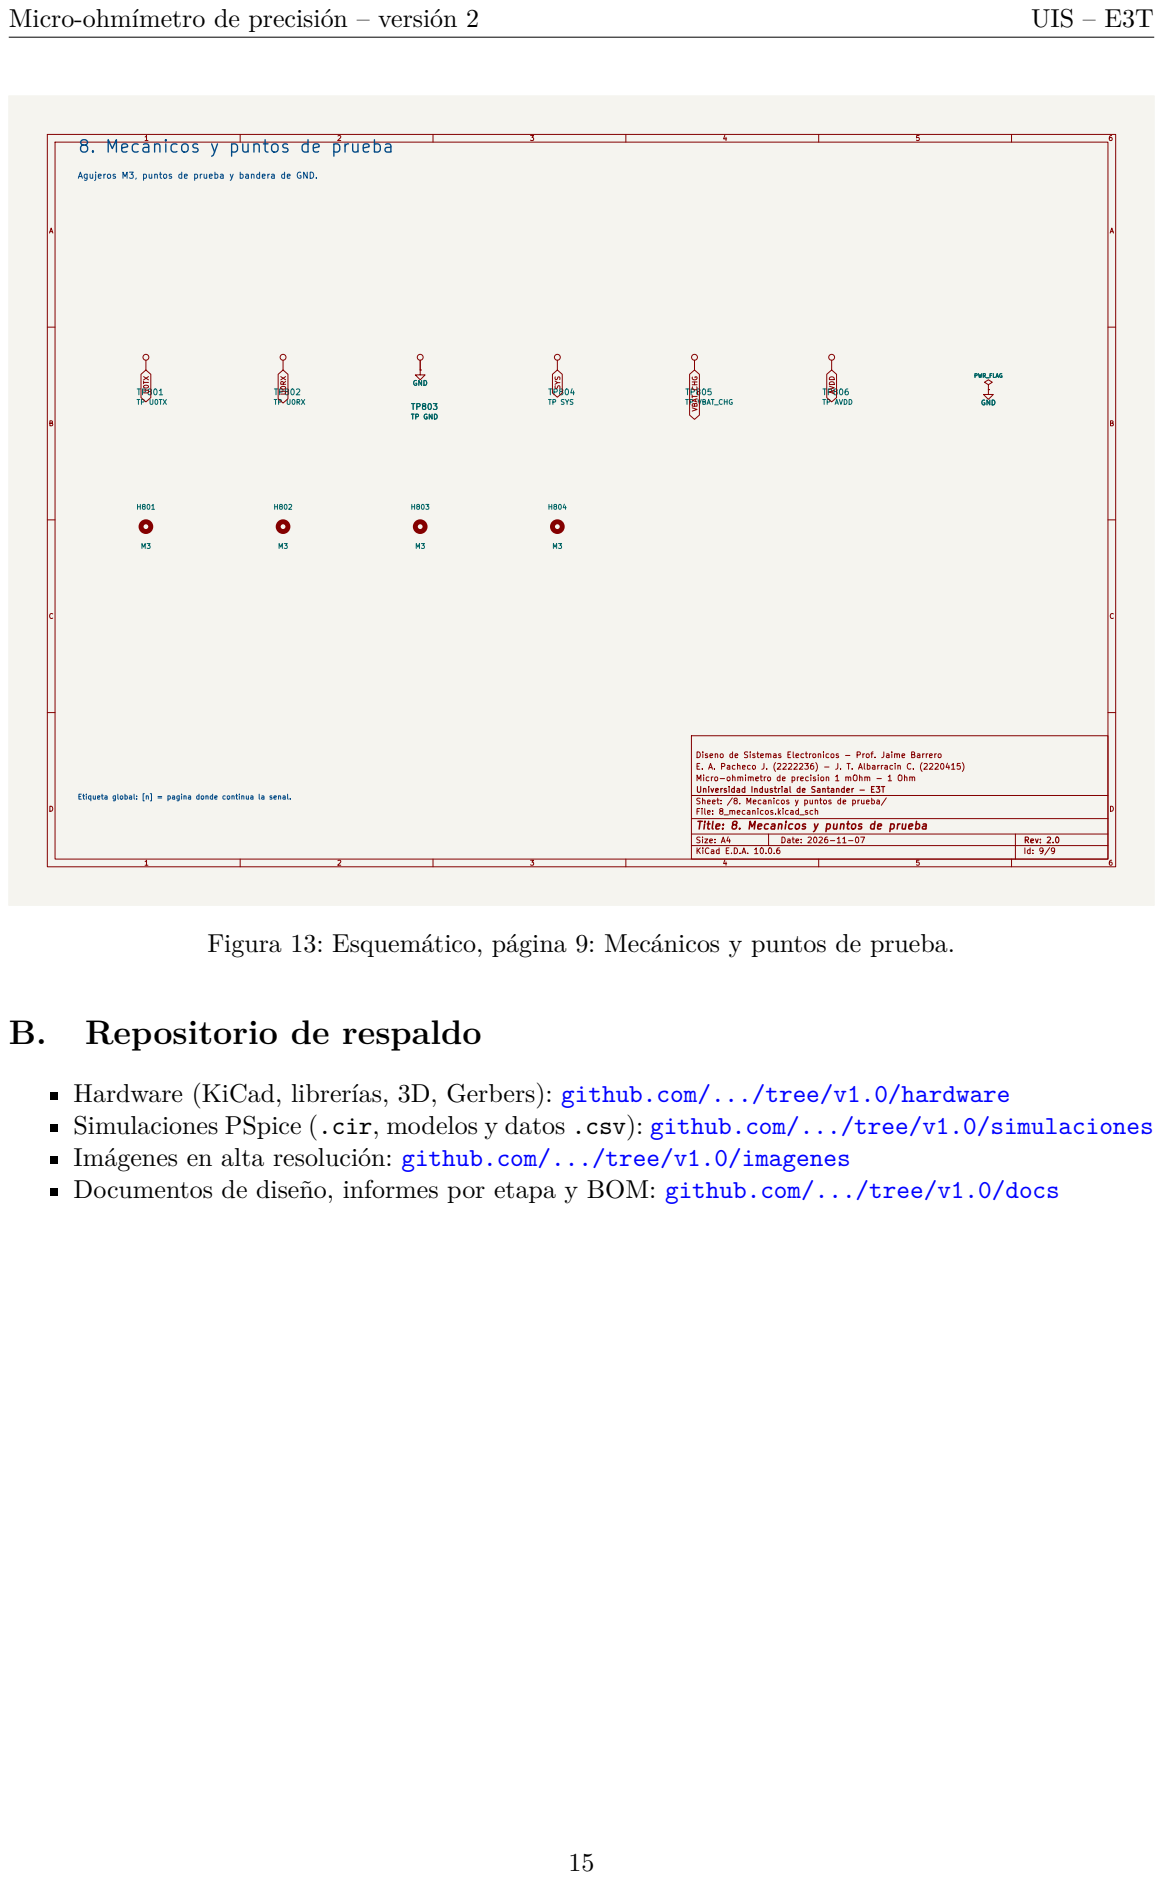
[picture p18: page 18]
Micro-ohmímetro de precisión – versión 2; UIS – E3T 1; D Date: 2026-11-07; Size: A4; Rev: 2.0; TP803 TP GND; GND; TP SYS H803 M3; TP805 TP VBAT_CHG; TP806 TP AVDD; PWR_FLAG H801 M3; SYS; VBAT_CHG U0TX; AVDD; Etiqueta global: [n] = pagina donde continua la senal.; TP GND; PWR_FLAG

8. Mecanicos y puntos de prueba

Agujeros M3, puntos de prueba y bandera de GND.

Diseno de Sistemas Electronicos - Prof. Jaime Barrero
E. A. Pacheco J. (2222236) - J. T. Albarracin C. (2220415)
Micro-ohmimetro de precision 1 mOhm - 1 Ohm
Universidad Industrial de Santander - E3T
Sheet: /8. Mecanicos y puntos de prueba/
File: 8_mecanicos.kicad_sch
Title: 8. Mecanicos y puntos de prueba
KiCad E.D.A. 10.0.6

Figura 13: Esquemático, página 9: Mecánicos y puntos de prueba.

B. Repositorio de respaldo

Hardware (KiCad, librerías, 3D, Gerbers): github.com/.../tree/v1.0/hardware (https://github.com/EDWARDPJ26/microohmetro-uis/tree/v1.0/hardware)
Simulaciones PSpice (.cir, modelos y datos .csv): github.com/.../tree/v1.0/simulaciones (https://github.com/EDWARDPJ26/microohmetro-uis/tree/v1.0/simulaciones)
Imágenes en alta resolución: github.com/.../tree/v1.0/imagenes (https://github.com/EDWARDPJ26/microohmetro-uis/tree/v1.0/imagenes)
Documentos de diseño, informes por etapa y BOM: github.com/.../tree/v1.0/docs (https://github.com/EDWARDPJ26/microohmetro-uis/tree/v1.0/docs)
