EDWARDPJ26/microohmetro-uis/docs/informes_etapas/Etapa1_fuente_corriente.pdf

# Etapa 1 - Generación de corriente de excitación -Proyecto Diseño Micro-ohmetro

Edward Andrés Pacheco Jurado
2222236
A1A

Joseph Thomas Albarracin Contreras 2220415
A1B

Resumen—En este informe se presenta el diseño y la validación mediante simulación de la primera etapa de un micro-ohmímetro: la fuente de corriente de prueba. El objetivo es generar una corriente aproximadamente constante de 100 mA para la excitación de resistencias entre 1 mΩ y 1 Ω, utilizando una alimentación de 3,3 V. La implementación final emplea un amplificador operacional OPA391, un transistor MOSFET 2N7002, una resistencia de sensado de 1 Ω y una referencia de 100 mV. Se compararon las alternativas MCP6001, OPA391 y OPA392, considerando principalmente el voltaje de offset, el consumo y la compatibilidad con la alimentación. La fuente fue evaluada mediante análisis DC y un barrido paramétrico de la resistencia bajo prueba en OrCAD/PSpice. La implementación con OPA391 obtuvo una corriente de aproximadamente 99,978 mA, correspondiente a un error de 0,022 % respecto al valor nominal.
Index Terms—Micro-ohmímetro, fuente de corriente, OPA391, 2N7002, medición Kelvin, OrCAD PSpice.
I. GENERACIÓN DE LA CORRIENTE DE PRUEBA

I-A. Introducción

La medición de resistencias de muy bajo valor requiere generar una corriente de prueba conocida y suficientemente estable, de manera que la pequeña caída de tensión producida sobre la resistencia bajo prueba pueda ser posteriormente adquirida y procesada. En el presente proyecto, el rango de medición establecido comprende resistencias entre 1 mΩ y 1 Ω, por lo que la estabilidad de la corriente de excitación constituye un aspecto fundamental para la precisión global del instrumento.
La primera etapa del micro-ohmímetro tiene como objetivo implementar una fuente de corriente de prueba de aproximadamente 100 mA, alimentada con una tensión de 3.3 V. Esta corriente será utilizada posteriormente para generar una caída de tensión sobre la resistencia bajo prueba de acuerdo con
VDUT = IT EST RDUT . | (1)

Para una corriente de 100 mA, la tensión desarrollada sobre el elemento bajo prueba varía desde aproximadamente 100 µV para 1 mΩ hasta 100 mV para 1 Ω. Por esta razón, cualquier error presente en la corriente de prueba se propaga directamente hacia la medición de resistencia.
La etapa se desarrolló y validó mediante simulación en OrCAD/PSpice 22.1.0. El proceso incluyó la definición de los requerimientos, la selección de la arquitectura, la comparación de diferentes amplificadores operacionales, el análisis del

Cuadro I
REQUERIMIENTOS ELÉCTRICOS DE LA FUENTE DE CORRIENTE DE PRUEBA.
Parámetro | Especificación
Rango de RDUT | 1 mΩ–1 Ω
Corriente de prueba | ≈ 100 mA
Alimentación analógica | 3.3 V
Tensión de referencia | 100 mV
Resistencia de sensado | 1 Ω
Tipo de medición | Kelvin / cuatro hilos
Herramienta de simulación | OrCAD/PSpice 22.1.0

efecto del voltaje de offset y la validación mediante un barrido de la resistencia bajo prueba.

I-B. Requerimientos y criterios de diseño

I-B1. Requerimientos eléctricos: Los principales requerimientos establecidos para la fuente de corriente se resumen en la Tabla I.
La selección de una corriente de prueba cercana a 100 mA permite aumentar la magnitud de la señal producida por resistencias pequeñas sin recurrir a corrientes excesivamente elevadas que incrementarían el consumo y la disipación del sistema. Como referencia técnica, Analog Devices describe arquitecturas de medición de baja resistencia basadas en una corriente conocida y medición Kelvin, y señala corrientes de prueba del orden de 100–200 mA en instrumentos especializados [1].
I-B2. Criterios de diseño: Además del cumplimiento de la corriente nominal, la selección de los componentes se realizó considerando los siguientes criterios:
bajo error de la corriente de prueba;
bajo voltaje de offset del amplificador operacional; compatibilidad con alimentación de 3.3 V;
bajo consumo energético;
disponibilidad de modelo para simulación SPICE; posibilidad de implementación mediante componentes SMD;
comportamiento estable del lazo de realimentación; simplicidad del circuito y cantidad reducida de componentes;
disponibilidad comercial de los componentes.
De esta manera, la selección del amplificador operacional no se realizó únicamente considerando el costo o el consumo, sino buscando un compromiso entre precisión, comportamiento eléctrico y facilidad de implementación.

I-C. Fundamento y arquitectura de la fuente de corriente

I-C1. Arquitectura de medición: La arquitectura general del instrumento utiliza una fuente de corriente para excitar la resistencia bajo prueba y una medición independiente de la tensión desarrollada sobre ella. Para resistencias de bajo valor, la utilización de una conexión Kelvin o de cuatro terminales permite separar las conexiones encargadas de transportar la corriente de las utilizadas para medir la tensión, reduciendo la influencia de las resistencias de los conductores y contactos [1].
En términos funcionales, la primera etapa puede representarse como:
Fuente de corriente | → | RDUT | → | Medición diferencial | .
(2)
La corriente generada constituye, por tanto, la condición de excitación para las etapas posteriores del instrumento.
I-C2. Principio de funcionamiento: La fuente implementada corresponde a una configuración tipo sumidero controlada mediante realimentación. El amplificador operacional compara la tensión de referencia VREF con la tensión desarrollada sobre la resistencia de sensado RS y controla la compuerta del MOSFET para mantener ambas tensiones aproximadamente iguales.
En régimen estacionario:
VSENSE ≈ VREF . | (3)

La corriente de prueba queda entonces determinada principalmente por la resistencia de sensado:

IT EST ≈

VREF
RS
. | (4)

Utilizando:

VREF = 100 mV | (5)

y

RS = 1 Ω, | (6)

se obtiene:

IT EST ≈

100 mV
1 Ω | = 100 mA. | (7)

La corriente de prueba no depende directamente del valor de RDUT mientras el transistor y el amplificador operacional permanezcan dentro de sus márgenes de operación. Esta característica permite utilizar la variación de tensión sobre el DUT como variable proporcional a su resistencia.

Cuadro II
CAÍDA DE TENSIÓN TEÓRICA SOBRE RDUT PARA IT EST = 100 mA.
RDUT | VDUT
1 mΩ | 100 µV
10 mΩ | 1 mV
100 mΩ | 10 mV
500 mΩ | 50 mV
750 mΩ | 75 mV
1 Ω | 100 mV

I-C3. Magnitud de la señal generada: A partir de la ecuación 1, las tensiones esperadas sobre el elemento bajo prueba para una corriente ideal de 100 mA son las mostradas en la Tabla II.
Estos valores muestran que la fuente debe mantener una corriente suficientemente estable, especialmente en la parte inferior del rango, donde la tensión diferencial disponible se encuentra en el orden de los microvoltios.

I-D. Antecedente y definición de la arquitectura adoptada

I-D1. Arquitecturas empleadas en medición de baja resistencia: La arquitectura utilizada en esta etapa no se definió a partir de una modificación directa de un diseño académico previamente presentado. La utilización de una fuente de corriente controlada mediante realimentación, junto con una resistencia de sensado y una medición Kelvin, corresponde a una estrategia ampliamente utilizada en instrumentos de medición de baja resistencia [1].
Por tanto, la selección de una fuente de aproximadamente 100 mA responde inicialmente a los requerimientos propios del instrumento y a criterios técnicos asociados con la medición de bajas resistencias.
I-D2. Trabajo previo utilizado como baseline: Como referencia de desempeño se tomó un trabajo desarrollado previamente dentro del proyecto, en el cual se implementó una fuente de corriente utilizando un amplificador operacional MCP6001, un MOSFET 2N7002, una resistencia de sensado de 1 Ω y una referencia de 100 mV [2].
En dicho trabajo se obtuvo mediante simulación una corriente aproximada de 99.48 mA para el rango de 1 mΩ a 1 Ω, correspondiente a un error de aproximadamente 0.52 % respecto a la corriente nominal de 100 mA [2].
Este resultado constituye un punto de comparación cuantitativo para la nueva implementación. Sin embargo, el trabajo previo no se tomó como un circuito a modificar directamente, sino como un antecedente que permite evaluar el comportamiento de una arquitectura técnicamente establecida bajo condiciones similares.
I-D3. Diferencia metodológica frente al trabajo de referencia: El proceso seguido en el presente diseño partió de los requerimientos del instrumento y posteriormente evaluó las características necesarias para los componentes de la fuente de corriente. A partir de estos criterios se consideraron diferentes alternativas de amplificador operacional, entre ellas el MCP6001 utilizado en el antecedente, el OPA391 y el OPA392.

La utilización del trabajo anterior como baseline permite disponer de un resultado cuantitativo de referencia sin asumir que su implementación constituye la solución que debe ser replicada. De esta manera, la comparación posterior permite determinar si las decisiones de diseño adoptadas en la presente implementación producen una mejora verificable mediante simulación.

I-E. Selección del amplificador operacional

I-E1. Alternativas consideradas: Para el amplificador operacional encargado de controlar el MOSFET se consideraron tres alternativas principales:
MCP6001;
OPA391;
OPA392.
El MCP6001 se incluyó como referencia debido a su utilización en el trabajo previo, mientras que los dispositivos OPA391 y OPA392 fueron considerados debido a sus características de bajo offset y su compatibilidad con el rango de alimentación utilizado.
I-E2. Análisis del efecto del voltaje de offset: El voltaje de offset constituye un parámetro especialmente relevante en esta arquitectura debido a que la tensión de referencia es de solamente 100 mV.
En una primera aproximación, el efecto del offset puede representarse como una perturbación de la tensión que el lazo intenta establecer sobre la resistencia de sensado:
VSENSE ≈ VREF ± VOS. | (8)

Por tanto, la corriente puede expresarse aproximadamente como:

IT EST ≈

VREF ± VOS
RS
. | (9)

La contribución relativa del offset puede estimarse mediante:

εV OS ≈

|VOS|

VREF

× 100. | (10)

I-E3. Evaluación del MCP6001: Para el MCP6001, el voltaje de offset máximo especificado es de aproximadamente ±4.5 mV [3]. Aplicando la ecuación 10:

εV OS,MCP 6001 =

4.5 mV
100 mV

× 100 = 4.5 %. (11)

La variación equivalente de corriente sería:

∆IMCP 6001 =

4.5 mV
1 Ω | = 4.5 mA. | (12)

Este cálculo representa una estimación de la sensibilidad máxima de la arquitectura frente al offset y no debe interpretarse como el error total de la fuente.

Cuadro III
COMPARACIÓN DE AMPLIFICADORES OPERACIONALES PARA LA FUENTE DE CORRIENTE.
Parámetro | MCP6001 | OPA391 | OPA392
|VOS|m´ax | 4.5 mV | 45 µV | 10 µV
Error por offset | 4.5 % | 0.045 % | 0.01 %
∆IV OS | ±4.5 mA | ±45 µA | ±10 µA
IQ típica | ≈ 100 µA | ≈ 24 µA | ≈ 1.22 mA
GBW | ≈ 1 MHz | ≈ 1 MHz | ≈ 13 MHz

I-E4. Evaluación del OPA391: El OPA391 presenta un voltaje de offset máximo de aproximadamente ±45 µV [4]. En consecuencia:

εV OS,OP A391 =

45 µV
100 mV

× 100 = 0.045 %. (13)

La variación equivalente de corriente es:

∆IOP A391 =

45 µV
1 Ω = 45 µA. | (14)

El OPA391 presenta además un rango de alimentación compatible con 3.3 V, entrada y salida rail-to-rail, un consumo típico del orden de decenas de microamperios y aproximadamente 1 MHz de ancho de banda [4].
I-E5. Evaluación del OPA392: El OPA392 fue considerado como una alternativa de menor offset. Su voltaje de offset máximo es del orden de 10 µV [5]. Por tanto:

εV OS,OP A392 =

10 µV
100 mV

× 100 = 0.01 %. (15)

La variación equivalente de corriente sería:

∆IOP A392 =

10 µV
1 Ω = 10 µA. | (16)

Aunque el OPA392 presenta un menor offset, su corriente de reposo es considerablemente superior a la del OPA391. Por esta razón, el menor offset no constituye por sí solo un criterio suficiente para realizar la selección.
I-E6. Comparación de las alternativas:
I-E7. Selección del OPA391: A partir de la comparación realizada, se seleccionó el OPA391 como amplificador operacional de control de la fuente de corriente. Aunque el OPA392 presenta un menor voltaje de offset, el OPA391 proporciona un compromiso adecuado entre reducción de la sensibilidad al offset, bajo consumo, compatibilidad con la alimentación de 3.3 V y características dinámicas apropiadas para la aplicación [4], [5].
La selección del OPA391 se realizó considerando conjuntamente el offset, el consumo, la alimentación y las características dinámicas relevantes para esta etapa.

I-F. Diseño e implementación del circuito

I-F1. Configuración implementada: La fuente de corriente implementada en OrCAD/PSpice está compuesta por el amplificador operacional OPA391, el MOSFET 2N7002, una resistencia de sensado de 1 Ω, una referencia de 100 mV y los elementos auxiliares asociados al control y desacoplo.

Cuadro IV
COMPONENTES PRINCIPALES DE LA FUENTE DE CORRIENTE.
Referencia | Valor / modelo | Función
VDD | 3.3 V | Alimentación
VREF | 100 mV | Referencia del lazo
U1 | OPA391 | Control del lazo
U2 | 2N7002 | Elemento de regulación
RS | 1 Ω | Sensado de corriente
R1 | 100 Ω | Elemento auxiliar de control
C1 | 100 nF | Desacoplo
C2 | 1 µF | Desacoplo / filtrado
C3 | 100 pF | Elemento auxiliar del lazo
RDUT | Paramétrico | Resistencia bajo prueba

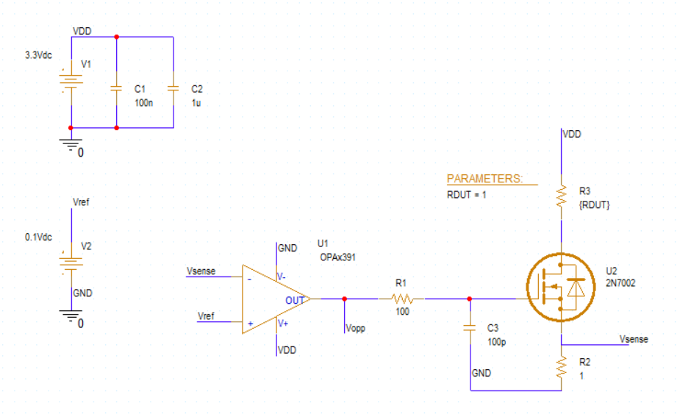
[picture p19: figure]

Figura 1. Esquemático implementado para la fuente de corriente de prueba utilizando OPA391 y 2N7002.

I-F2. Cálculo de la corriente de prueba: La corriente nominal se establece mediante la relación entre la referencia y la resistencia de sensado:

IT EST =

VREF
RS
. | (17)

Sustituyendo los valores seleccionados:

IT EST =

0.1 V
1 Ω = 0.1 A = 100 mA. | (18)

La resistencia de sensado disipa aproximadamente:

PRS = I

2
T EST RS | (19)

PRS = (0.1)²
(1) = 10 mW. | (20)

Este valor permite mantener una disipación reducida en la resistencia de sensado bajo las condiciones nominales de operación.
I-F3. Selección del MOSFET: El transistor utilizado como elemento de control es el 2N7002, un MOSFET de canal N disponible en encapsulado SOT-23. Su selección se relaciona con su disponibilidad, facilidad de implementación y disponibilidad comercial y compatibilidad con la implementación seleccionada [6].
La corriente de prueba no se determina a partir del voltaje de umbral del MOSFET. En esta arquitectura, la corriente es establecida por el lazo de realimentación, mientras que el MOSFET actúa como elemento de regulación.

I-G. Metodología de simulación

I-G1. Herramienta de simulación: El circuito fue implementado y analizado mediante OrCAD/PSpice 22.1.0. La simulación se realizó considerando una alimentación analógica de 3.3 V y una referencia fija de 100 mV.
I-G2. Punto de operación DC: Inicialmente se realizó un análisis de punto de operación DC con el objetivo de verificar el funcionamiento del lazo de realimentación y determinar los valores de corriente y tensión de sensado en régimen estacionario.
Las variables principales observadas fueron:
corriente a través de la resistencia de sensado;
tensión VSENSE;
salida del amplificador operacional;
tensión en el nodo de control del MOSFET.
I-G3. Barrido de la resistencia bajo prueba: Posteriormente se realizó un barrido paramétrico de RDUT para verificar que la corriente de prueba permaneciera aproximadamente constante frente a cambios significativos de la carga.
Los valores principales evaluados fueron:

RDUT = {1 mΩ, 10 mΩ, 100 mΩ, 500 mΩ, 750 mΩ, 1 Ω}. (21)
Durante el barrido se observaron principalmente I(RS) y V (VSENSE).
I-G4. Criterio de aceptación: La etapa se consideró eléctricamente válida cuando se verificaron simultáneamente las siguientes condiciones:
corriente cercana a 100 mA;
variación reducida de la corriente frente a RDUT ; tensión de sensado cercana a 100 mV;
ausencia de saturación del lazo dentro del rango evaluado.

I-H. Resultados de simulación

I-H1. Punto de operación: La simulación del circuito con OPA391 produjo una corriente de aproximadamente:

IT EST = 99.978 mA. | (22)

La tensión sobre la resistencia de sensado fue:

VSENSE = 99.978 mV. | (23)

Estos valores son consistentes con la relación esperada:

VSENSE ≈ IT EST RS. | (24)

I-H2. Barrido de RDUT : El barrido realizado entre 1 mΩ y 1 Ω mostró que la corriente permanece prácticamente constante frente a las variaciones de la resistencia bajo prueba. La corriente obtenida en los diferentes puntos del barrido presentó variaciones del orden de unos pocos microamperios, manteniéndose alrededor de 99.978 mA.

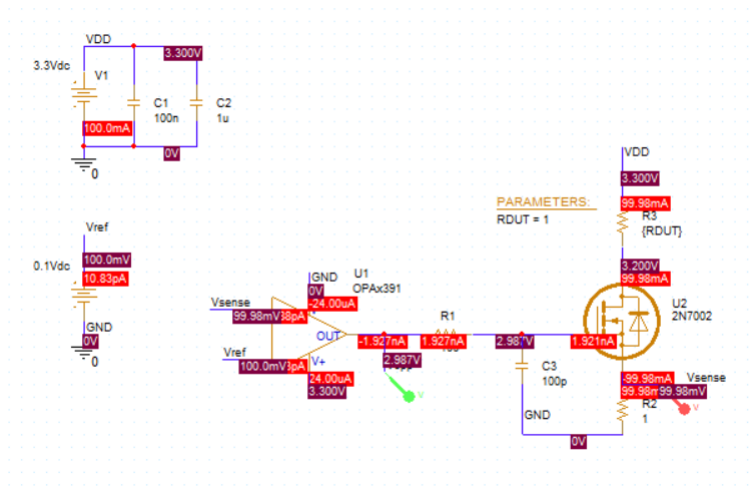
[picture p20: figure]

Figura 2. Punto de operación DC de la fuente de corriente.

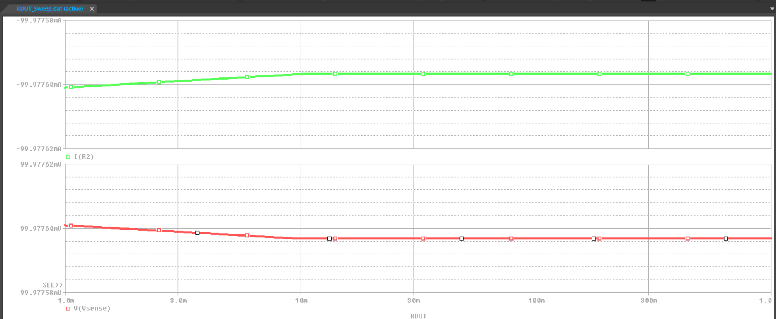
[picture p21: figure]

Figura 3. Barrido de RDUT y comportamiento de la corriente de prueba.

Cuadro V
RESULTADOS PRINCIPALES DE LA SIMULACIÓN DE LA FUENTE DE CORRIENTE.
Magnitud | Ideal | Simulado | Error
IT EST | 100 mA | 99.978 mA | 0.022 %
VSENSE | 100 mV | 99.978 mV | 0.022 %

I-H3. Cálculo del error: Tomando 100 mA como corriente ideal, el error obtenido en la simulación es:

εI =

|Iideal − Isim|

Iideal

| × 100. | (25)

Sustituyendo:

εI =

|100 − 99.978|
100 | × 100 | (26)
εI ≈ 0.022 % | . | (27)

De manera equivalente, para la tensión de sensado:

εVSENSE =

|100 − 99.978|
100

× 100 ≈ 0.022 %. (28)

I-H4. Resumen de resultados:

I-I. Comparación con el baseline

I-I1. Comparación numérica: El trabajo utilizado como referencia obtuvo una corriente de aproximadamente 99.48 mA, mientras que la implementación actual basada en OPA391 alcanzó aproximadamente 99.978 mA.

Cuadro VI
COMPARACIÓN ENTRE EL baseline Y LA IMPLEMENTACIÓN ACTUAL.
Parámetro | Baseline | Diseño actual
Amplificador operacional | MCP6001 | OPA391
VDD | 3.3 V | 3.3 V
VREF | 100 mV | 100 mV
RS | 1 Ω | 1 Ω
IT EST | 99.48 mA | 99.978 mA
Error | 0.52 % | 0.022 %

I-I2. Reducción observada del error simulado: La diferencia entre los errores obtenidos es:

∆ε = 0.52 % − 0.022 % = 0.498 puntos porcentuales. (29)

Si la reducción se expresa de forma relativa respecto al error del baseline:

Reducción relativa =

0.52 − 0.022
0.52
| × 100 | (30)
Reducción relativa ≈ 95.8 % | . | (31)

Bajo las condiciones específicas de las simulaciones comparadas, la magnitud del error observado presenta una reducción relativa de aproximadamente 95.8 %.
I-I3. Interpretación: La comparación muestra una reducción del error simulado en la implementación que utiliza el OPA391. Sin embargo, esta diferencia no se atribuye exclusivamente al voltaje de offset del amplificador operacional. El resultado de la simulación corresponde al comportamiento conjunto del amplificador, el MOSFET, la resistencia de sensado, la realimentación y los modelos utilizados.
El análisis realizado sobre el voltaje de offset se utiliza para cuantificar la sensibilidad potencial de la arquitectura frente a este parámetro y para justificar la selección del OPA391. La comparación de 99.48 mA frente a 99.978 mA, por su parte, representa una comparación global entre las dos implementaciones simuladas.

I-J. Discusión técnica y limitaciones
Los resultados obtenidos permiten validar eléctricamente el funcionamiento de la fuente de corriente bajo las condiciones establecidas para la simulación. La corriente permanece cercana al valor nominal de 100 mA y presenta una variación reducida frente al rango de resistencia bajo prueba.
No obstante, el resultado obtenido mediante simulación no representa por sí solo la exactitud final del instrumento. Para una implementación física deberán considerarse factores adicionales, entre ellos:
tolerancia de la resistencia de sensado;
coeficiente de temperatura de RS;
deriva térmica del amplificador operacional; comportamiento térmico del MOSFET; tolerancias de los demás componentes; ruido eléctrico;
efectos termoeléctricos;

resistencias parásitas de la PCB;
implementación física de las conexiones Kelvin; variaciones de alimentación y referencia.
Estos factores serán considerados posteriormente dentro del presupuesto de error completo del micro-ohmímetro.

I-K. Cierre y aceptación de la etapa
La primera etapa del micro-ohmímetro permitió diseñar y validar mediante simulación una fuente de corriente de prueba de aproximadamente 100 mA para el rango de resistencia comprendido entre 1 mΩ y 1 Ω.
La arquitectura utilizada se fundamentó en técnicas establecidas para la medición de bajas resistencias y no fue definida como una modificación directa del trabajo utilizado como referencia. El trabajo previo fue empleado como baseline de desempeño, permitiendo establecer una comparación cuantitativa bajo condiciones similares.
El proceso de selección del amplificador operacional consideró MCP6001, OPA391 y OPA392. El análisis del voltaje de offset mostró que, para una referencia de solamente 100 mV, este parámetro puede representar una contribución significativa al error de la corriente. A partir del análisis conjunto de offset, consumo, alimentación y características dinámicas, se seleccionó el OPA391.
La simulación de la implementación final produjo una corriente de
IT EST = 99.978 mA, | (32)

correspondiente a un error aproximado de

εI = 0.022 %. | (33)

Adicionalmente, la comparación con el baseline mostró una reducción del error simulado desde aproximadamente 0.52 % hasta 0.022 %. Este resultado muestra una reducción del error simulado de la implementación bajo las condiciones de simulación establecidas, sin atribuir dicha mejora exclusivamente a un único parámetro del amplificador operacional.
En consecuencia, la etapa se considera eléctricamente validada mediante simulación DC. La corriente obtenida constituye la condición de excitación para la siguiente etapa del instrumento, en la cual se realizará la medición diferencial de la caída de tensión generada sobre RDUT .
La validación experimental, el análisis térmico, las tolerancias de los componentes, los efectos de la PCB, el ruido y el presupuesto de error completo serán abordados en las etapas posteriores del diseño.

REFERENCIAS

[1] Analog Devices, “Measuring very small resistances, a milliohmmeter,” Analog Devices University, accedido: octubre de 2026. [Online]. Available: https://wiki.analog.com/university/courses/tutorials/alm-milli-ohm-meter (https://wiki.analog.com/university/courses/tutorials/alm-milli-ohm-meter)
[2] M. D. A. Barreto and J. M. T. Melo, “Diseño y simulación del módulo generador de corriente de prueba para un micro-ohmímetro,” Universidad Industrial de Santander, Informe técnico, trabajo previo utilizado como baseline del módulo de generación de corriente.
[3] Microchip Technology Inc., MCP6001/1R/1U/2/4: 1 MHz, Low-Power Op Amp, Microchip Technology Inc., data sheet. [Online]. Available: https://ww1.microchip.com/downloads/en/DeviceDoc/MCP6001-1R-1U-2-4-1-MHz-Low-Power-Op-Amp-DS20001733L.pdf (https://ww1.microchip.com/downloads/en/DeviceDoc/MCP6001-1R-1U-2-4-1-MHz-Low-Power-Op-Amp-DS20001733L.pdf)
[4] Texas Instruments, OPAx391 Precision, Ultra-Low IQ, Low Offset Voltage, e-trim Operational Amplifiers, Texas Instruments, 2024, data sheet, Rev. E. [Online]. Available: https://www.ti.com/lit/ds/symlink/opa391.pdf (https://www.ti.com/lit/ds/symlink/opa391.pdf)
[5] ——, OPAx392 Precision, Low-Offset-Voltage, Low-Noise, Low-Input-Bias-Current, Rail-to-Rail I/O, e-trim Operational Amplifiers, Texas Instruments, data sheet. [Online]. Available: https://www.ti.com/lit/ds/symlink/opa392.pdf (https://www.ti.com/lit/ds/symlink/opa392.pdf)
[6] Nexperia, 2N7002 60 V, 300 mA N-channel Trench MOSFET, Nexperia, product data sheet. [Online]. Available: https://assets.nexperia.com/documents/data-sheet/2N7002.pdf (https://assets.nexperia.com/documents/data-sheet/2N7002.pdf)
