EDWARDPJ26/microohmetro-uis/docs/informes_etapas/Etapa2_medicion_diferencial.pdf

# Etapa 2 – Medición diferencial de la caída de tensión del DUT para el micro-ohmímetro

Edward Andrés Pacheco Jurado
2222236
A1A

Joseph Thomas Albarracin Contreras 2220415
A1B

Resumen—En este informe se presenta el diseño y la validación mediante simulación de la segunda etapa de un micro-ohmímetro, correspondiente a la medición diferencial y amplificación de la caída de tensión producida sobre la resistencia bajo prueba. La etapa recibe una corriente de prueba de aproximadamente 99,98 mA, proveniente de la fuente de corriente previamente desarrollada, y opera con una alimentación de 3,3 V. La implementación utiliza un amplificador operacional OPA391, una referencia intermedia de aproximadamente 1,655 V y una red resistiva que establece una ganancia nominal de 16 V/V. Mediante simulaciones DC y un barrido logarítmico de RDUT entre 1 mΩ y 1 Ω, se obtuvo un rango de salida entre 1,656 62 V y 3,254 62 V. A partir de dos puntos del barrido se obtuvo una ganancia de aproximadamente 16,000 27 V/V, con un error relativo cercano al 0,0017 % respecto al valor nominal. Los resultados validan el comportamiento eléctrico de la etapa bajo las condiciones de simulación realizadas y establecen V OUT_AMP como la señal de salida hacia el acondicionamiento posterior.
Index | Terms—Micro-ohmímetro, | medición | diferencial,
OPA391, medición Kelvin, OrCAD PSpice, baja resistencia.
I. MEDICIÓN DIFERENCIAL DE LA RESISTENCIA BAJO
| PRUEBA
I-A. Introducción
La medición de resistencias de bajo valor requiere convertir una pequeña caída de tensión en una señal que pueda ser procesada posteriormente por el sistema de adquisición. En el presente proyecto, el rango objetivo comprende resistencias entre 1 mΩ y 1 Ω, mientras que la fuente de corriente de la primera etapa entrega aproximadamente 100 mA.
La caída de tensión sobre el dispositivo bajo prueba está determinada por
VDUT = IT EST RDUT . | (1)

En las pruebas realizadas se observa una corriente de aproximadamente 99,98 mA en los diferentes valores de RDUT evaluados. Para los cálculos de referencia se utiliza el valor previamente extraído de la simulación de la fuente,

IT EST = 99,978 mA. | (2)

Con esta corriente, la tensión diferencial esperada varía aproximadamente desde 99,978 µV para 1 mΩ hasta 99,978 mV para 1 Ω. Debido a esta amplitud reducida, especialmente en el extremo inferior del rango, se requiere una medición diferencial y una etapa de amplificación que mantenga la relación entre la resistencia y la tensión obtenida.

La Etapa 1 se considera previamente validada, por lo que en esta etapa no se modifica la arquitectura de generación de corriente. Las pruebas de simulación muestran la continuidad de la corriente de aproximadamente 99,98 mA para los valores de 1 mΩ, 100 mΩ y 1 Ω, como se observa en las Figuras 1, 2 y 3.

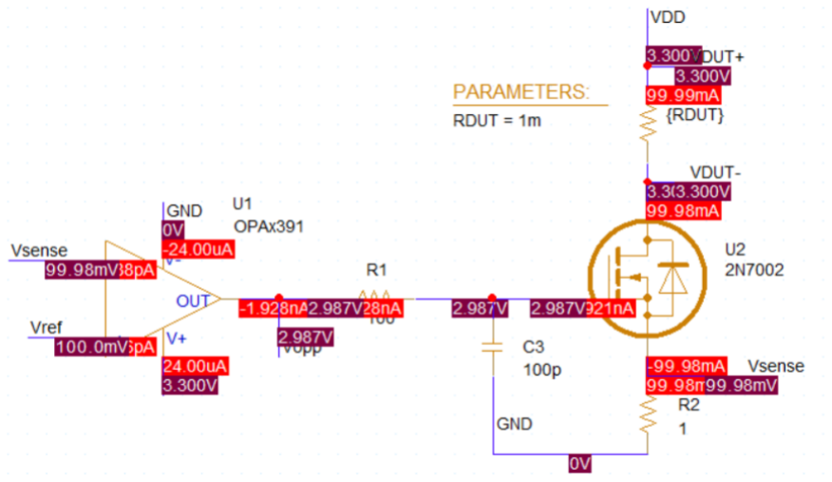
[picture p22: figure]

Figura 1. Prueba de la fuente de corriente para RDUT = 1 mΩ, con una corriente de aproximadamente 99,98 mA.

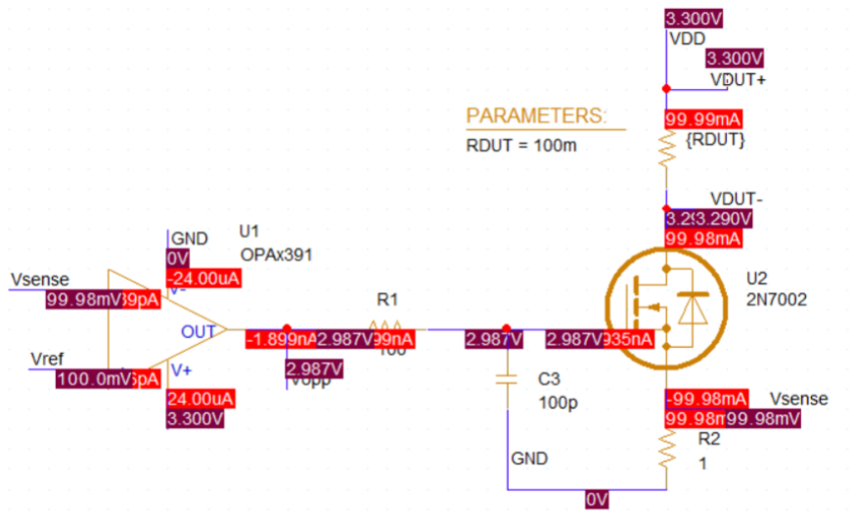
[picture p23: figure]

Figura 2. Prueba de la fuente de corriente para RDUT = 100 mΩ, con una corriente de aproximadamente 99,98 mA.

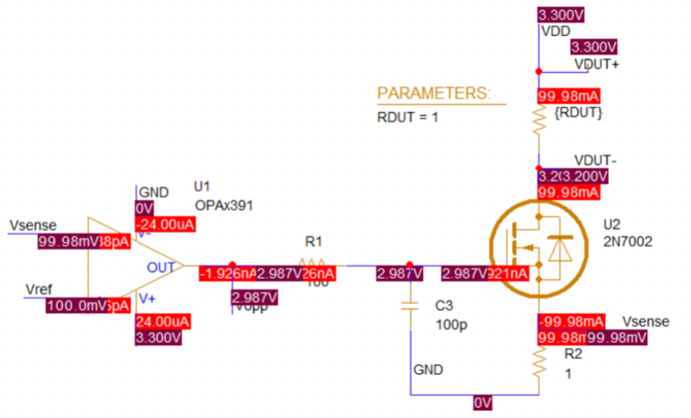
[picture p24: figure]

Figura 3. Prueba de la fuente de corriente para RDUT = 1 Ω, con una corriente de aproximadamente 99,98 mA.

I-B. Requerimientos y criterios de diseño
Los principales requerimientos adoptados para la segunda etapa se resumen en la Tabla I.

Cuadro I
REQUERIMIENTOS ELÉCTRICOS DE LA ETAPA DE MEDICIÓN DIFERENCIAL.
Parámetro | Requerimiento
Rango de RDUT | 1 mΩ–1 Ω
Corriente de prueba | ≈ 100 mA
Alimentación | 3,3 V
Medición | Diferencial, conexión Kelvin
Ganancia nominal | 16 V/V
Referencia | VREF _MID ≈ 1,65 V
Salida | V OUT_AMP
Simulación | OrCAD/PSpice 22.1.0

El diseño busca mantener la salida dentro del intervalo de alimentación de 0 V a 3,3 V, evitando saturación en las condiciones de operación simuladas. Asimismo, se mantiene una arquitectura sencilla, de modo que cada componente incorporado tenga una función definida.

I-C. Fundamento de la medición diferencial
La conexión al DUT se plantea mediante el método Kelvin de cuatro hilos. Dos conductores corresponden al camino de corriente y dos conductores independientes realizan la medición de tensión. De esta forma, la tensión adquirida por la etapa diferencial corresponde principalmente a la caída de tensión sobre el elemento bajo prueba, reduciendo la influencia de las resistencias asociadas al cableado y a los contactos del camino de corriente.
Las señales de medida se definen como VDUT + y VDUT −, de manera que
∆VDUT = VDUT + − VDUT −. | (3)

La resistencia bajo prueba puede recuperarse posteriormente mediante

RDUT =

∆VDUT

IT EST

. | (4)

Por tanto, la etapa diferencial constituye el vínculo entre la magnitud física de interés, RDUT , y la señal eléctrica que será entregada al sistema de adquisición.

I-D. Arquitectura adoptada

La arquitectura final utiliza un amplificador operacional OPA391 alimentado con 3,3 V. La salida se desplaza alrededor de una referencia intermedia VREF _M ID, obtenida mediante un divisor resistivo.
La relación funcional de la etapa es

V OUT_AMP = VREF _M ID +G (VDUT + − VDUT −), (5)

con una ganancia nominal de

G =

R8
R9

=

160 kΩ
10 kΩ = 16 V/V. | (6)

Por tanto,

V OUT_AMP = VREF _M ID +16 (VDUT + − VDUT −). (7)

La referencia intermedia permite desplazar el nivel de continua de la señal para trabajar con alimentación unipolar. Así, la señal diferencial se superpone a un nivel cercano a la mitad de la alimentación.

I-E. Diseño e implementación del circuito

Los valores reportados en esta sección corresponden a los valores que aparecen efectivamente en las capturas de simulación suministradas para el diseño final.
La referencia intermedia se genera mediante
R4 = R5 = 1 kΩ. | (8)

El nodo se desacopla mediante

C4 = 1 µF, | C5 = 100 nF. | (9)

La red diferencial utiliza

R6 = R8 = 160 kΩ | (10)

y

R7 = R9 = 10 kΩ. | (11)

Finalmente, la salida utiliza

R10 = 100 Ω, | C6 = 100 nF. | (12)

La Tabla II resume los valores observados en el circuito simulado.

Cuadro II
COMPONENTES DE LA ETAPA DIFERENCIAL SEGÚN EL CIRCUITO SIMULADO.
Componente | Valor
U3 | OPA391
R4 | 1 kΩ
R5 | 1 kΩ
C4 | 1 µF
C5 | 100 nF
R6 | 160 kΩ
R7 | 10 kΩ
R8 | 160 kΩ
R9 | 10 kΩ
R10 | 100 Ω
C6 | 100 nF

La Fig. 4 muestra la etapa diferencial durante la simulación para RDUT = 1 mΩ, mientras que la Fig. 5 presenta la condición de 100 mΩ y la Fig. 6 la condición de 1 Ω.

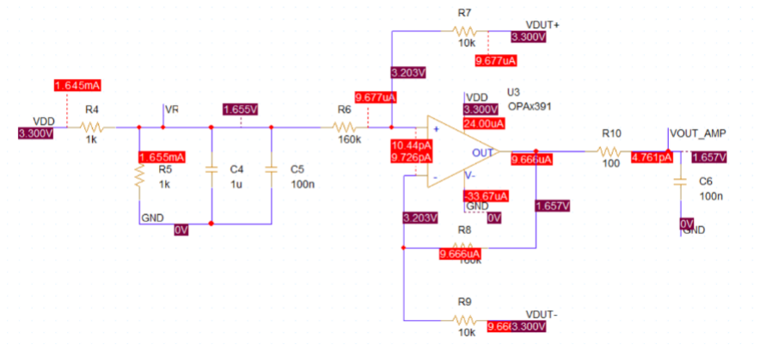
[picture p25: figure]

Figura 4. Etapa diferencial simulada para RDUT = 1 mΩ. Se observa VREF _MID ≈ 1,655 V y V OUT_AMP ≈ 1,657 V.

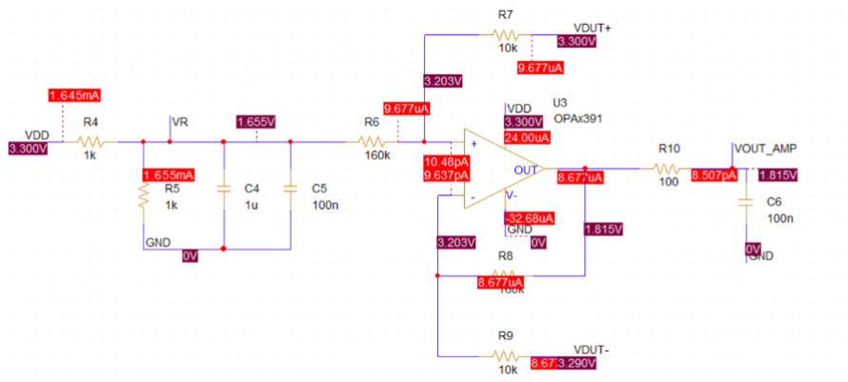
[picture p26: figure]

Figura 5. | Etapa diferencial simulada para RDUT | = 100 mΩ, con
V OUT_AMP ≈ 1,815 V.

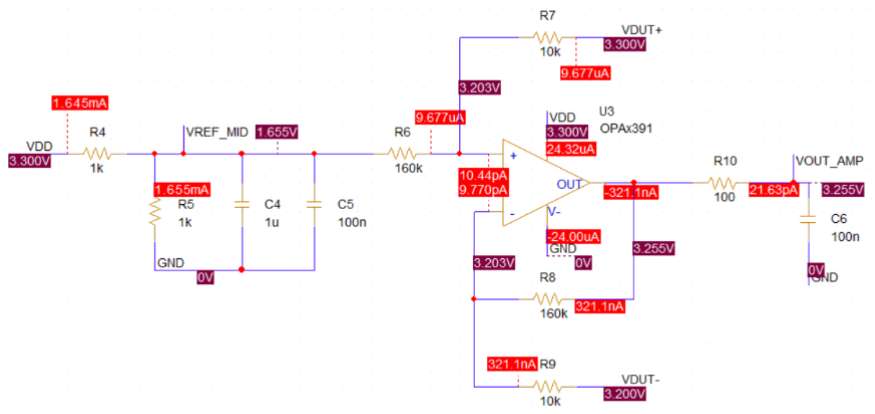
[picture p27: figure]

Figura 6. | Etapa diferencial simulada para RDUT | = | 1 Ω, con
V OUT_AMP ≈ 3,255 V.

I-F. Referencia intermedia VREF _M ID
Con los valores utilizados en la simulación,
| R4 = R5 = 1 kΩ, | | (13)

el divisor resistivo idealmente establece

VREF _M ID = V DD R5
R4 + R5

= 3,3 V1
2

= 1,65 V. (14)

En el circuito simulado se observa aproximadamente

VREF _M ID ≈ 1,655 V. | (15)

La diferencia respecto al valor ideal del divisor se debe a que el nodo de referencia no está completamente aislado de la red conectada a la entrada del amplificador. Por esta razón, en este informe se utiliza 1,655 V como el valor observado en simulación para las comparaciones numéricas.
El divisor resistivo proporciona una solución sencilla para generar el desplazamiento DC requerido. Los capacitores C4 y C5 actúan como elementos de desacoplo del nodo de referencia. Una limitación de esta implementación es que VREF _M ID depende de la alimentación y de la carga que observe el nodo, por lo que su precisión no es equivalente a la de una referencia dedicada.

I-G. Metodología de simulación
Las verificaciones se realizaron en OrCAD/PSpice 22.1.0 mediante análisis de punto de operación y un barrido DC de la variable global RDUT .
El barrido utilizado fue logarítmico, desde
RDUT = 1 mΩ | (16)

hasta

RDUT = 1 Ω, | (17)

con 10 puntos por década. La variable principal observada fue V OUT_AMP.
Las herramientas de evaluación de PSpice se utilizaron para obtener los valores mínimo, máximo y los valores de

V OUT_AMP correspondientes a resistencias específicas mediante la función Y atX. Las Figuras 7–9 muestran directamente estas pruebas.

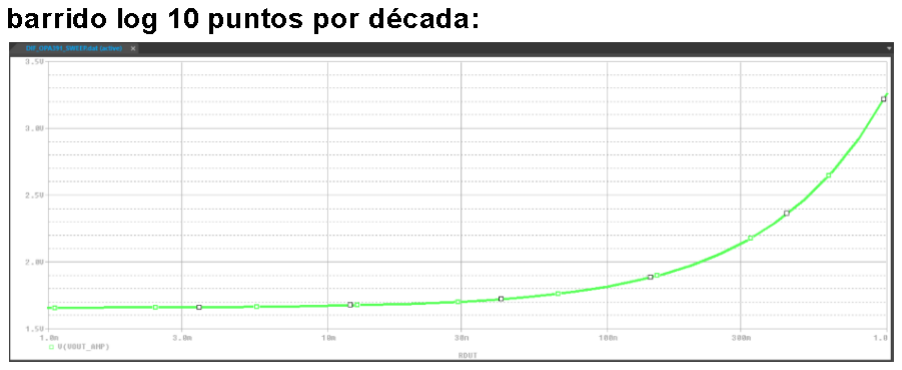
[picture p28: figure]

Figura 7. Barrido logarítmico de RDUT entre 1 mΩ y 1 Ω, con 10 puntos por década.

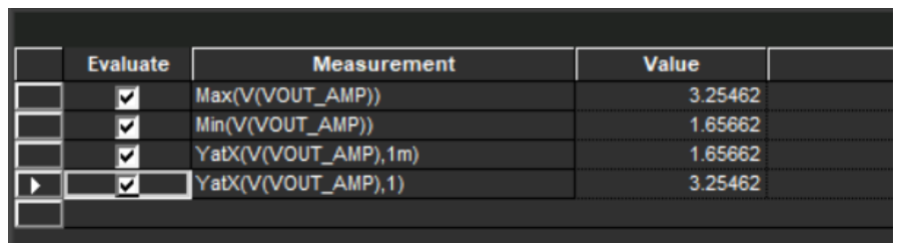
[picture p29: figure]

Figura 8. Mediciones de máximo, mínimo y valores puntuales de V OUT_AMP obtenidas con la herramienta de evaluación de PSpice.

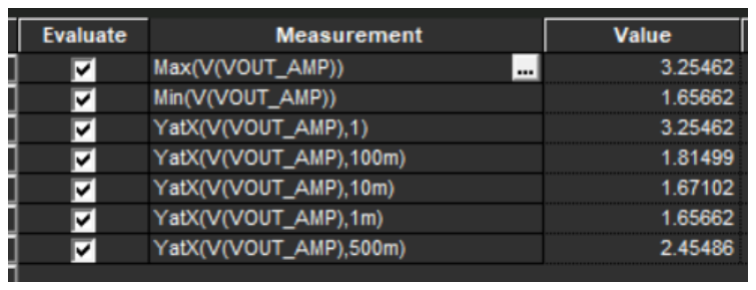
[picture p30: figure]

Figura 9. Valores puntuales de V OUT_AMP obtenidos mediante Y atX para diferentes valores de RDUT .

I-H. Resultados de simulación
Los valores extraídos directamente del barrido se presentan en la Tabla III.

Cuadro III
RESULTADOS SIMULADOS DE LA ETAPA DIFERENCIAL.
RDUT | V OUT_AMP simulado
1 mΩ | 1,656 62 V
10 mΩ | 1,671 02 V
100 mΩ | 1,814 99 V
500 mΩ | 2,454 86 V
1 Ω | 3,254 62 V

El valor mínimo medido por PSpice fue

V OUT_AMP, m´ın = 1,656 62 V, | (18)

mientras que el máximo fue

V OUT_AMP, m´ax = 3,254 62 V. | (19)

Por tanto,

∆V OUT = 3, 25462 − 1, 65662 = 1,598 V. (20)

El resultado del barrido muestra una respuesta creciente de V OUT_AMP a medida que aumenta RDUT . Esta tendencia es consistente con la relación entre la corriente de prueba, la resistencia bajo prueba y la amplificación diferencial.

I-I. Comparación entre teoría y simulación
Para realizar la comparación se utiliza

V OUT_AMP = VREF _M ID + 16IT EST RDUT . (21)

Tomando

IT EST = 99,978 mA

y

VREF _M ID = 1,655 V,

se obtienen los valores teóricos de la Tabla IV.
Los valores calculados presentan una diferencia muy pequeña respecto a los resultados extraídos de PSpice. Esta comparación valida la correspondencia entre la ecuación de transferencia adoptada y el comportamiento del modelo simulado.
El valor de 750 mΩ forma parte del rango de diseño y su valor teórico puede calcularse mediante (21), obteniéndose aproximadamente
V OUT_AMP(750 mΩ) ≈ 2,854 74 V. | (22)

Este punto no se presenta como resultado simulado porque no aparece entre los valores Y atX extraídos de la simulación final suministrada.

I-J. Verificación de la ganancia
La ganancia nominal se obtiene directamente de la relación de resistencias:

Gnom =

160 kΩ
10 kΩ = 16 V/V. | (23)

Para verificarla a partir de la simulación se utilizan los puntos de 100 mΩ y 500 mΩ. La variación de salida es

∆V OUT = 2, 45486 − 1, 81499 = 0,639 87 V. (24)

La variación correspondiente de tensión sobre el DUT es

∆VDUT = IT EST (0, 5−0, 1) = 0, 099978(0, 4) = 0,039 991 2 V.
| (25)
Por tanto,

Cuadro IV
COMPARACIÓN ENTRE VALORES TEÓRICOS Y RESULTADOS SIMULADOS.
RDUT | VDUT | 16VDUT | V OUT_AMP teórica | V OUT_AMP simulada | Error relativo
1 mΩ | 99,978 µV | 1,599 65 mV | 1,656 60 V | 1,656 62 V | 0,001 23 %
10 mΩ | 999,78 µV | 15,9965 mV | 1,671 00 V | 1,671 02 V | 0,001 20 %
100 mΩ | 9,9978 mV | 159,965 mV | 1,814 97 V | 1,814 99 V | 0,001 10 %
500 mΩ | 49,989 mV | 799,824 mV | 2,454 82 V | 2,454 86 V | 0,001 63 %
1 Ω | 99,978 mV | 1,599 65 V | 3,254 65 V | 3,254 62 V | 0,000 92 %

Gsim =

∆V OUT

∆VDUT

=

0, 63987
0, 0399912

≈ 16,000 27 V/V. (26)

El error relativo respecto a la ganancia nominal es

εG =

16, 00027 − 16
16

× 100 ≈ 0,0017 %. (27)

El resultado confirma, dentro de la simulación, la relación de ganancia establecida mediante las resistencias R6–R9.

I-K. Validación del rango de salida
El valor máximo obtenido fue
V OUT_AMP = 3,254 62 V | (28)
para RDUT | = 1 Ω. Considerando una alimentación de
3,3 V, el margen respecto al riel positivo es

Vmargen = 3, 3 − 3, 25462 = 45,38 mV. (29)

Por lo tanto, en las condiciones simuladas no se observa saturación, aunque la salida se encuentra próxima al límite superior de alimentación. Este comportamiento debe ser considerado en la implementación física, ya que tolerancias, variaciones de alimentación, temperatura, offset y otros efectos no ideales pueden reducir dicho margen.
En el extremo inferior, para RDUT = 1 mΩ, se obtuvo
V OUT_AMP = 1,656 62 V. | (30)

El desplazamiento proporcionado por VREF _M ID mantiene la salida alejada del riel de tierra para este caso.

I-L. Discusión técnica y limitaciones
Las simulaciones realizadas muestran que la etapa diferencial presenta el comportamiento esperado: la salida V OUT_AMP aumenta conforme aumenta la resistencia bajo prueba y mantiene un nivel de continua alrededor de

VREF _M ID.
La verificación mediante dos puntos del barrido produjo una ganancia de 16,000 27 V/V, muy próxima a la ganancia nominal de 16 V/V. La comparación punto a punto también presenta diferencias pequeñas entre los valores calculados y los obtenidos mediante PSpice.
Estos resultados corresponden exclusivamente al modelo simulado. La precisión física del micro-ohmímetro completo dependerá adicionalmente de las tolerancias y desbalance de la red resistiva, el offset del amplificador operacional, la deriva térmica, el ruido, las resistencias parásitas de las pistas y conexiones, los efectos termoeléctricos, la estabilidad de VREF _M ID y las características reales del montaje.
Una limitación importante observada en la simulación es el margen de solamente 45,38 mV entre la salida máxima y la alimentación de 3,3 V. Aunque no existe saturación en la simulación suministrada, esta condición debe considerarse durante la integración física.
Otra consideración corresponde a VREF _M ID. El valor de 1,655 V observado en el circuito simulado no coincide exactamente con el valor ideal de 1,65 V del divisor. Esto muestra la influencia de la carga conectada al nodo de referencia. En consecuencia, el divisor resistivo debe entenderse como una referencia de trabajo para esta etapa y no como una referencia de precisión independiente.

I-M. Interfaz hacia la siguiente etapa

La señal de salida de esta etapa se denomina V OUT_AMP. Esta señal constituye la interfaz hacia el acondicionamiento posterior, donde se realizará el filtrado y buffer antes de la entrada del ADC.
La Etapa 2 termina en la generación de V OUT_AMP. Por tanto, los elementos correspondientes al filtro y al ADC no forman parte del diseño de esta etapa y solamente se consideran como contexto de integración.

I-N. Cierre y aceptación de la etapa

Con base en las pruebas realizadas en OrCAD/PSpice 22.1.0, la Etapa 2 queda validada bajo las condiciones de simulación analizadas. El circuito implementado con OPA391, una referencia intermedia cercana a 1,655 V y una ganancia nominal de 16 V/V permite amplificar la tensión diferencial generada sobre el DUT y obtener una señal de salida compatible con la siguiente etapa.
El barrido entre 1 mΩ y 1 Ω produjo valores de V OUT_AMP entre 1,656 62 V y 3,254 62 V. La ganancia obtenida mediante el análisis de dos puntos fue de aproximadamente 16,000 27 V/V, con un error relativo de aproximadamente 0,0017 % frente al valor nominal.
En consecuencia, V OUT_AMP queda establecido como la salida de la Etapa 2 y como señal de entrada para el acondicionamiento posterior. Esta aceptación corresponde únicamente a la validación eléctrica mediante simulación y no implica la validación experimental del micro-ohmímetro completo.

REFERENCIAS

[1] E. A. Pacheco Jurado y J. T. Albarracin Contreras, “Etapa 1 – Generación de corriente de excitación – Proyecto Diseño Micro-ohmetro,” informe técnico del proyecto de diseño, UIS.
[2] Analog Devices, “Measuring Very Small Resistances, A Milliohmmeter,” Analog Devices University.
[3] Texas Instruments, “OPA391 Precision, Ultra-Low IQ, Low Offset Voltage Operational Amplifier,” documentación técnica del fabricante.
