EDWARDPJ26/microohmetro-uis/docs/bom_kicad.csv

Reference | Value | Footprint | MPN | Description | QUANTITY
C101,C205,C206 | 10u/25V | Capacitor_SMD:C_0805_2012Metric |  | X7R | 3
C102-C104,C301,C401,C609,C610,C701 | 1u | Capacitor_SMD:C_0603_1608Metric |  | X7R | 8
C201 | 1u/25V | Capacitor_SMD:C_0603_1608Metric |  | X7R | 1
C202 | 47n | Capacitor_SMD:C_0603_1608Metric |  | X7R | 1
C203,C204,C208,C302,C303,C702 | 10u/10V | Capacitor_SMD:C_0805_2012Metric |  | X7R | 6
C207 | 4.7u/10V | Capacitor_SMD:C_0603_1608Metric |  | X7R | 1
C304,C404,C405,C501,C606-C608,C611,C703 | 100n | Capacitor_SMD:C_0603_1608Metric |  | X7R | 9
C402 | 22n | Capacitor_SMD:C_0603_1608Metric |  | C0G (arranque suave) | 1
C403,C603 | 10n | Capacitor_SMD:C_0603_1608Metric |  | C0G (integrador),C0G diferencial | 2
C601,C602,C604,C605 | 1n | Capacitor_SMD:C_0603_1608Metric |  | C0G | 4
D101 | SMBJ12A | Diode_SMD:D_SMB | SMBJ12A | TVS 12 V | 1
D201 | LED ambar CHG | LED_SMD:LED_0603_1608Metric |  | Indicador de carga | 1
D601,D602 | BAT54S | Package_TO_SOT_SMD:SOT-23 | BAT54S | Clamp AIN0,Clamp AIN1 | 2
D701 | LED verde STAT | LED_SMD:LED_0603_1608Metric |  |  | 1
FB301 | 600R@100MHz | Inductor_SMD:L_0603_1608Metric | BLM18KG601SN1D | Ferrita de aislamiento analogico | 1
H801-H804 | M3 | MountingHole:MountingHole_3.2mm_M3 |  | Agujero de montaje M3 | 4
J101 | USB-C 24p 5 A | Connector_USB:USB_C_Receptacle_Amphenol_12401610E4-2A | Amphenol 12401610E4#2A | Receptaculo USB-C 24 pines (compatible EPR) | 1
J201 | LiPo 1S (JST XH) | Connector_JST:JST_XH_S3B-XH-SM4-TB_1x03-1MP_P2.50mm_Horizontal | S3B-XH-SM4-TB | 1 = BAT+, 2 = NTC, 3 = BAT- | 1
J501 | I_PLUS (rojo) | Connector:Banana_Cliff_FCR7350R_S16N-PC_Horizontal | Cliff FCR7350R | Borne banana 4 mm rojo | 1
J502 | S_PLUS (amarillo) | Connector:Banana_Cliff_FCR7350Y_S16N-PC_Horizontal | Cliff FCR7350Y | Borne banana 4 mm amarillo | 1
J503 | S_MINUS (azul) | Connector:Banana_Cliff_FCR7350L_S16N-PC_Horizontal | Cliff FCR7350L | Borne banana 4 mm azul | 1
J504 | I_MINUS (negro) | Connector:Banana_Cliff_FCR7350B_S16N-PC_Horizontal | Cliff FCR7350B | Borne banana 4 mm negro | 1
L201 | 2.2u | Inductor_SMD:L_Bourns-SRN4018 | SRN4018-2R2M | 2,2 uH, Isat >= 3,5 A | 1
Q101,Q201,Q202 | AO3401A | Package_TO_SOT_SMD:SOT-23 | AO3401A | Interruptor de VBUS (VBUS_EN_SNK),Polaridad inversa,Polaridad inversa (paralelo) | 3
Q401,Q402 | 2N7002 | Package_TO_SOT_SMD:SOT-23 | 2N7002 | Q_LOW: selecciona I_L,Q_OFF: corriente apagada por defecto | 2
Q403 | NTD25P03LT4G | Package_TO_SOT_SMD:TO-252-2 | NTD25P03LT4G | P-MOS de paso (pulsos 3,5 W / 120 ms) | 1
R101,R205,R405-R407 | 100k | Resistor_SMD:R_0603_1608Metric |  | Corriente apagada al arrancar,Pull-up de gate,Thick film 1 % | 5
R201 | 178 | Resistor_SMD:R_0603_1608Metric |  | IINMAX = 355/178 = 2,0 A | 1
R202,R601,R602,R706 | 1k | Resistor_SMD:R_0603_1608Metric |  | Thick film 1 %,Thin film 0,1 % 25 ppm/C | 4
R203 | 5.23k | Resistor_SMD:R_0603_1608Metric |  | RT1 (datasheet) | 1
R204 | 30.1k | Resistor_SMD:R_0603_1608Metric |  | RT2 (datasheet) | 1
R401,R403,R605,R701-R705 | 10k | Resistor_SMD:R_0603_1608Metric |  | Thick film 1 %,Thin film 0,1 % (R_VSET),Thin film 0,1 % (integrador) | 8
R402 | 9.31k | Resistor_SMD:R_0603_1608Metric |  | Nivel I_L | 1
R404,R603,R604 | 100 | Resistor_SMD:R_0603_1608Metric |  | Thick film 1 %,Thin film 0,1 % | 3
R501 | 0.12 1% 4T | Resistor_SMD:R_Shunt_Vishay_WSK2512_6332Metric_T1.19mm | WSK2512R1200FEA | Shunt Kelvin 0,12 Ohm 1 % | 1
R502 | 0.68 | Resistor_SMD:R_2512_6332Metric |  | R_LIFT 1 % 1 W | 1
SW701 | RESET | Button_Switch_SMD:SW_Push_SPST_NO_Alps_SKRK |  |  | 1
SW702 | BOOT | Button_Switch_SMD:SW_Push_SPST_NO_Alps_SKRK |  |  | 1
TH201 | 10k NTC | Resistor_SMD:R_0603_1608Metric | NCP18XH103F03RB | DNP si la LiPo trae NTC | 1
TP801 | TP U0TX | TestPoint:TestPoint_Pad_D1.5mm |  | Punto de prueba | 1
TP802 | TP U0RX | TestPoint:TestPoint_Pad_D1.5mm |  | Punto de prueba | 1
TP803 | TP GND | TestPoint:TestPoint_Pad_D1.5mm |  | Punto de prueba | 1
TP804 | TP SYS | TestPoint:TestPoint_Pad_D1.5mm |  | Punto de prueba | 1
TP805 | TP VBAT_CHG | TestPoint:TestPoint_Pad_D1.5mm |  | Punto de prueba | 1
TP806 | TP AVDD | TestPoint:TestPoint_Pad_D1.5mm |  | Punto de prueba | 1
U101 | STUSB4500QTR | Package_DFN_QFN:QFN-24-1EP_4x4mm_P0.5mm_EP2.7x2.7mm | STUSB4500QTR | Controlador USB PD sink (PDO2 = 9 V / 2 A) | 1
U102 | USBLC6-2SC6 | Package_TO_SOT_SMD:SOT-23-6 | USBLC6-2SC6 | ESD en D+/D- | 1
U201 | BQ25895RTWR | Package_DFN_QFN:Texas_RTW_WQFN-24-1EP_4x4mm_P0.5mm_EP2.7x2.7mm_ThermalVias | BQ25895RTWR | Cargador buck 1S I2C, 2 A, power-path | 1
U301 | AP2112K-3.3TRG1 | Package_TO_SOT_SMD:SOT-23-5 | AP2112K-3.3TRG1 | LDO 600 mA | 1
U401 | REF3325AIDBZR | Package_TO_SOT_SMD:SOT-23 | REF3325AIDBZR | Referencia 2,5 V +-0,15 %, 30 ppm/C | 1
U402 | OPA388IDBVR | Package_TO_SOT_SMD:SOT-23-5 | OPA388IDBVR | Lazo zero-drift | 1
U501 | INA181A1IDBVR | Package_TO_SOT_SMD:SOT-23-6 | INA181A1IDBVR | Sensado 20 V/V | 1
U601 | AD7124-4BBCPZ-RL7 | Package_CSP:LFCSP-32-1EP_5x5mm_P0.5mm_EP3.6x3.6mm | AD7124-4BBCPZ-RL7 | ADC sigma-delta 24 bit, PGA 1-128 | 1
U701 | ESP32-C3-WROOM-02-N4 | RF_Module:ESP32-C3-WROOM-02 | ESP32-C3-WROOM-02-N4 | MCU RISC-V, BLE 5, USB nativo | 1
