EDWARDPJ26/microohmetro-uis/hardware/fabricacion/microohmetro_v2.step

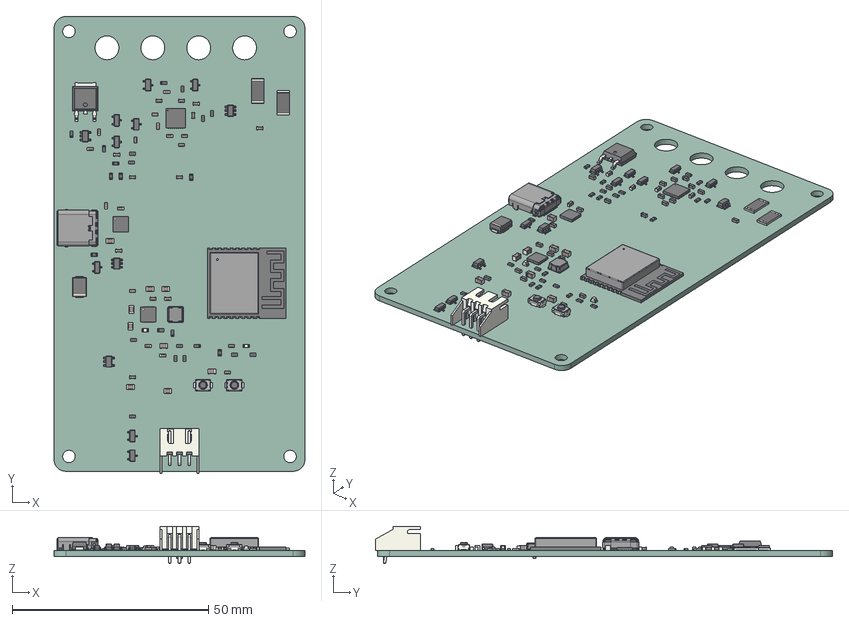
[picture p48: CAD file, 2026-11-08]
hardware/fabricacion/microohmetro_v2.step
64.0 x 116.6 x 9.50 mm
QFN-24-1EP_4x4mm_P0.5mm_EP2.7x2.7mm
C_0603_1608Metric x 27
C_0805_2012Metric x 9
SOT-23 x 8
Texas_RTW_WQFN-24-1EP_4x4mm_P0.5mm_EP2.7x2.7mm
R_0603_1608Metric x 25
SOT-23-5 x 2
LED_0603_1608Metric x 2
R_2512_6332Metric x 2
SW_Push_SPST_NO_Alps_SKRK x 2
SOT-23-6 x 2
D_SMB
USB_C_Receptacle_Amphenol_12401610E4-2A
L_0603_1608Metric
JST_S3B_XH_A
ESP32-C3-WROOM-02
2728c7a2-7f7d-11ed-bbe7-acde48001122_part
2728ca22-7f7d-11ed-bbe7-acde48001122_part
2728cb12-7f7d-11ed-bbe7-acde48001122_part
2728cba8-7f7d-11ed-bbe7-acde48001122_part
L_Bourns-SRN4018
932d09b3-9c39-11ed-93f0-dde97e994e83_part
932d09b4-9c39-11ed-93f0-dde97e994e83_part
932d09b5-9c39-11ed-93f0-dde97e994e83_part
microohmetro_v2_PCB
