EDWARDPJ26/microohmetro-uis/informe/figuras/esquematico_v2.pdf

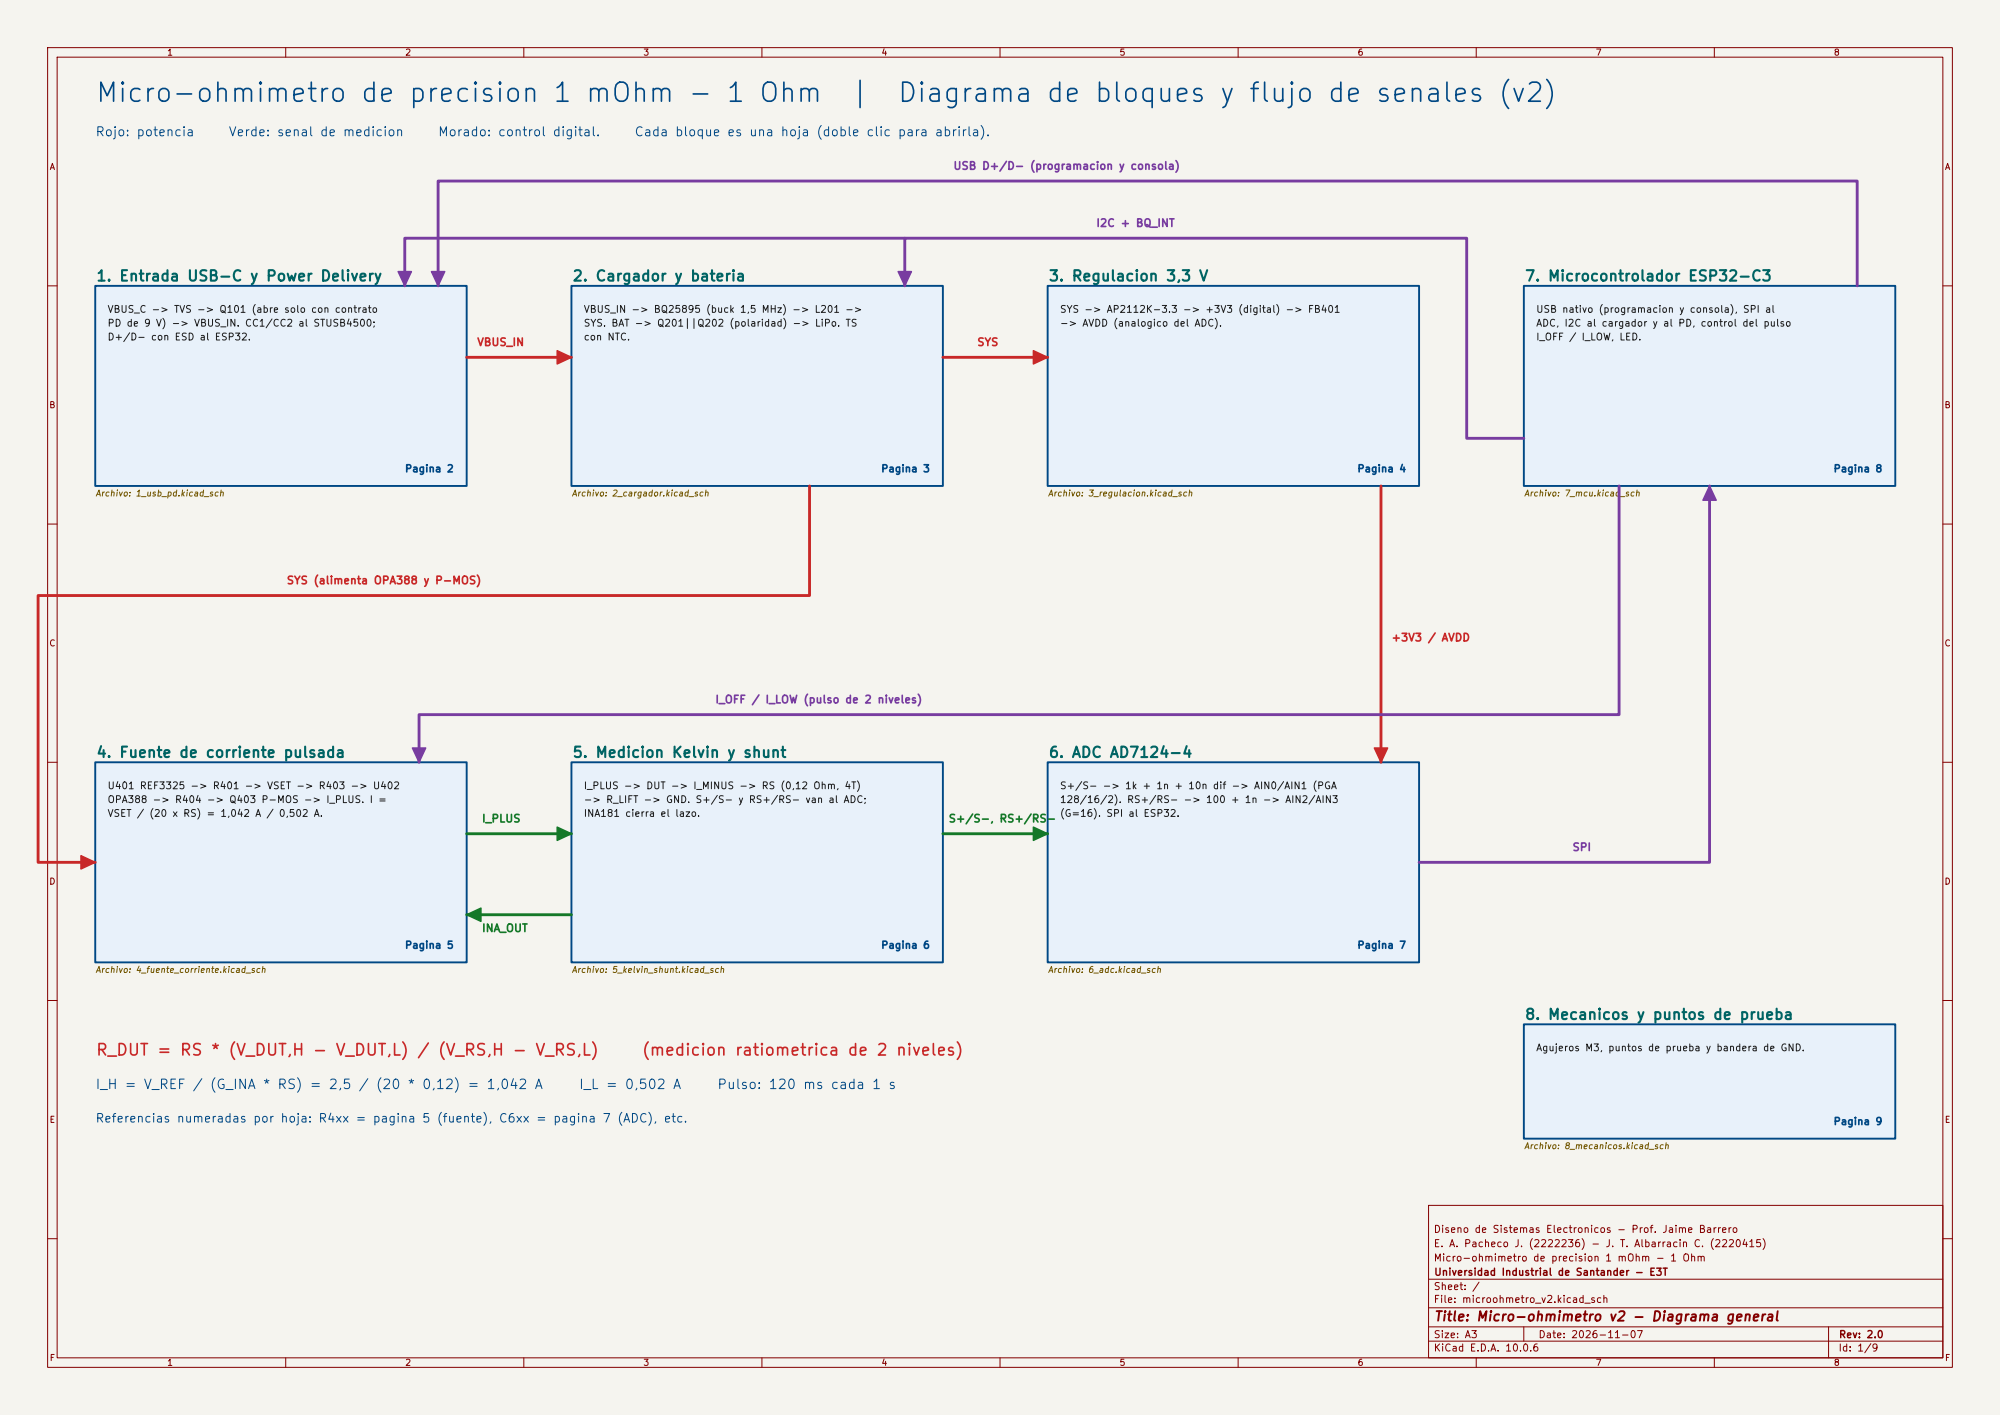
[picture p49: page 1]

Micro-ohmimetro de precision 1 mOhm - 1 Ohm | Diagrama de bloques y flujo de senales (v2)

Archivo: 1_usb_pd.kicad_sch SYS (alimenta OPA388 | Archivo: 5_kelvin_shunt.kicad_sch 1. Entrada USB-C y Power Delivery Archivo: 2_cargador.kicad_sch y P-MOS) I_OFF / I_LOW (pulso de 2 niveles) 5. Medicion Kelvin y shunt | Archivo: 3_regulacion.kicad_sch 6. ADC AD7124-4 | +3V3 / AVDD | SPI -> AVDD (analogico del ADC).

2. Cargador y bateria | 3. Regulacion 3,3 V

VBUS_C -> TVS -> Q101 (abre solo con contrato PD de 9 V) -> VBUS_IN. CC1/CC2 al STUSB4500; D+/D- con ESD al ESP32. Pagina 2 | VBUS_IN | | SYS | SYS -> AP2112K-3.3 -> +3V3 (digital) -> FB401 | USB nativo (programacion y consola), SPI al ADC, I2C al cargador y al PD, control del pulso I_OFF / I_LOW, LED. Pagina 8

VBUS_IN -> BQ25895 (buck 1,5 MHz) -> L201 ->
SYS. BAT -> Q201||Q202 (polaridad) -> LiPo. TS
con NTC.

Archivo: 7_mcu.kicad_sch 8. Mecanicos y puntos de prueba

Archivo: 8_mecanicos.kicad_sch 4. Fuente de corriente pulsada

U401 REF3325 -> R401 -> VSET -> R403 -> U402 OPA388 -> R404 -> Q403 P-MOS -> I_PLUS. I = VSET / (20 x RS) = 1,042 A / 0,502 A. | I_PLUS | INA181 cierra el lazo. | Pagina 6 | S+/S-, RS+/RS- | S+/S- -> 1k + 1n + 10n dif -> AIN0/AIN1 (PGA 128/16/2). RS+/RS- -> 100 + 1n -> AIN2/AIN3 (G=16). SPI al ESP32. Pagina 7

Agujeros M3, puntos de prueba y bandera de GND.

Diseno de Sistemas Electronicos - Prof. Jaime Barrero
E. A. Pacheco J. (2222236) - J. T. Albarracin C. (2220415)
Micro-ohmimetro de precision 1 mOhm - 1 Ohm
Universidad Industrial de Santander - E3T
Sheet: /
File: microohmetro_v2.kicad_sch
Title: Micro-ohmimetro v2 - Diagrama general

Size: A3 | Rev: 2.0 | F Date: 2026-11-07
KiCad E.D.A. 10.0.6 | Id: 1/9

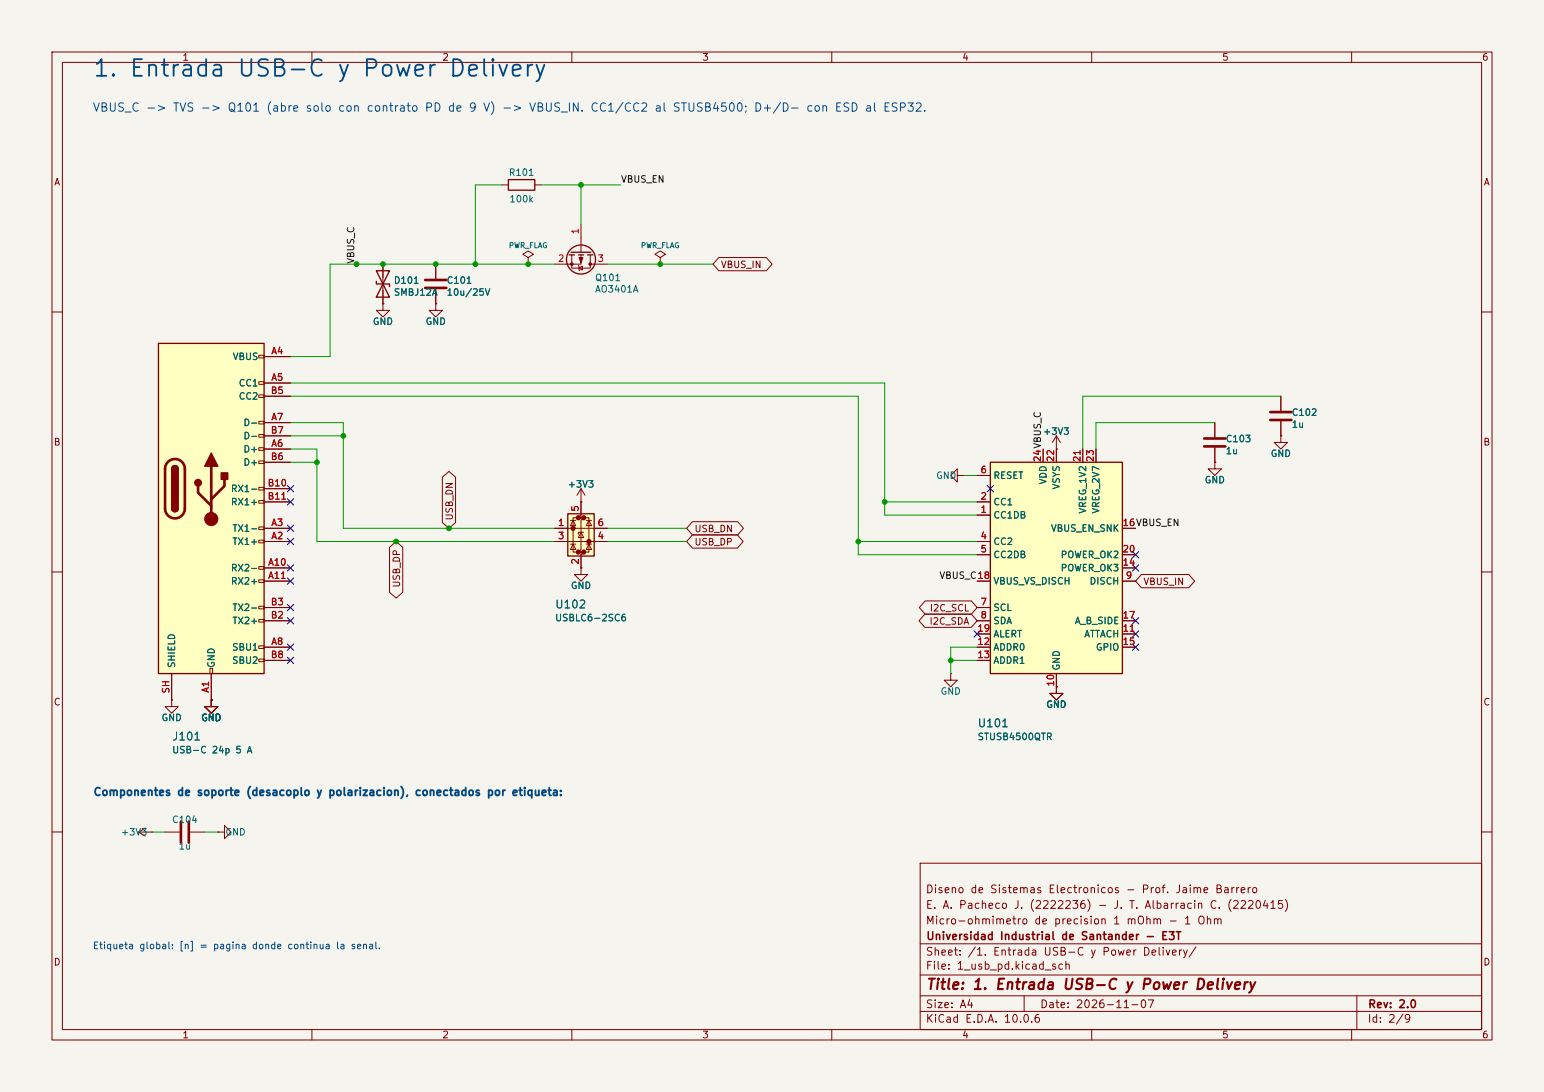
[picture p50: page 2]

1. Entrada USB-C y Power Delivery

VBUS_EN VBUS_C -> TVS -> Q101 (abre solo con contrato PD de 9 V) -> VBUS_IN. CC1/CC2 al STUSB4500; D+/D- con ESD al ESP32.

Etiqueta global: [n] = pagina donde continua la senal. Componentes de soporte (desacoplo y polarizacion), conectados por etiqueta:

Diseno de Sistemas Electronicos - Prof. Jaime Barrero
E. A. Pacheco J. (2222236) - J. T. Albarracin C. (2220415)
Micro-ohmimetro de precision 1 mOhm - 1 Ohm
Universidad Industrial de Santander - E3T
Sheet: /1. Entrada USB-C y Power Delivery/
File: 1_usb_pd.kicad_sch
Title: 1. Entrada USB-C y Power Delivery

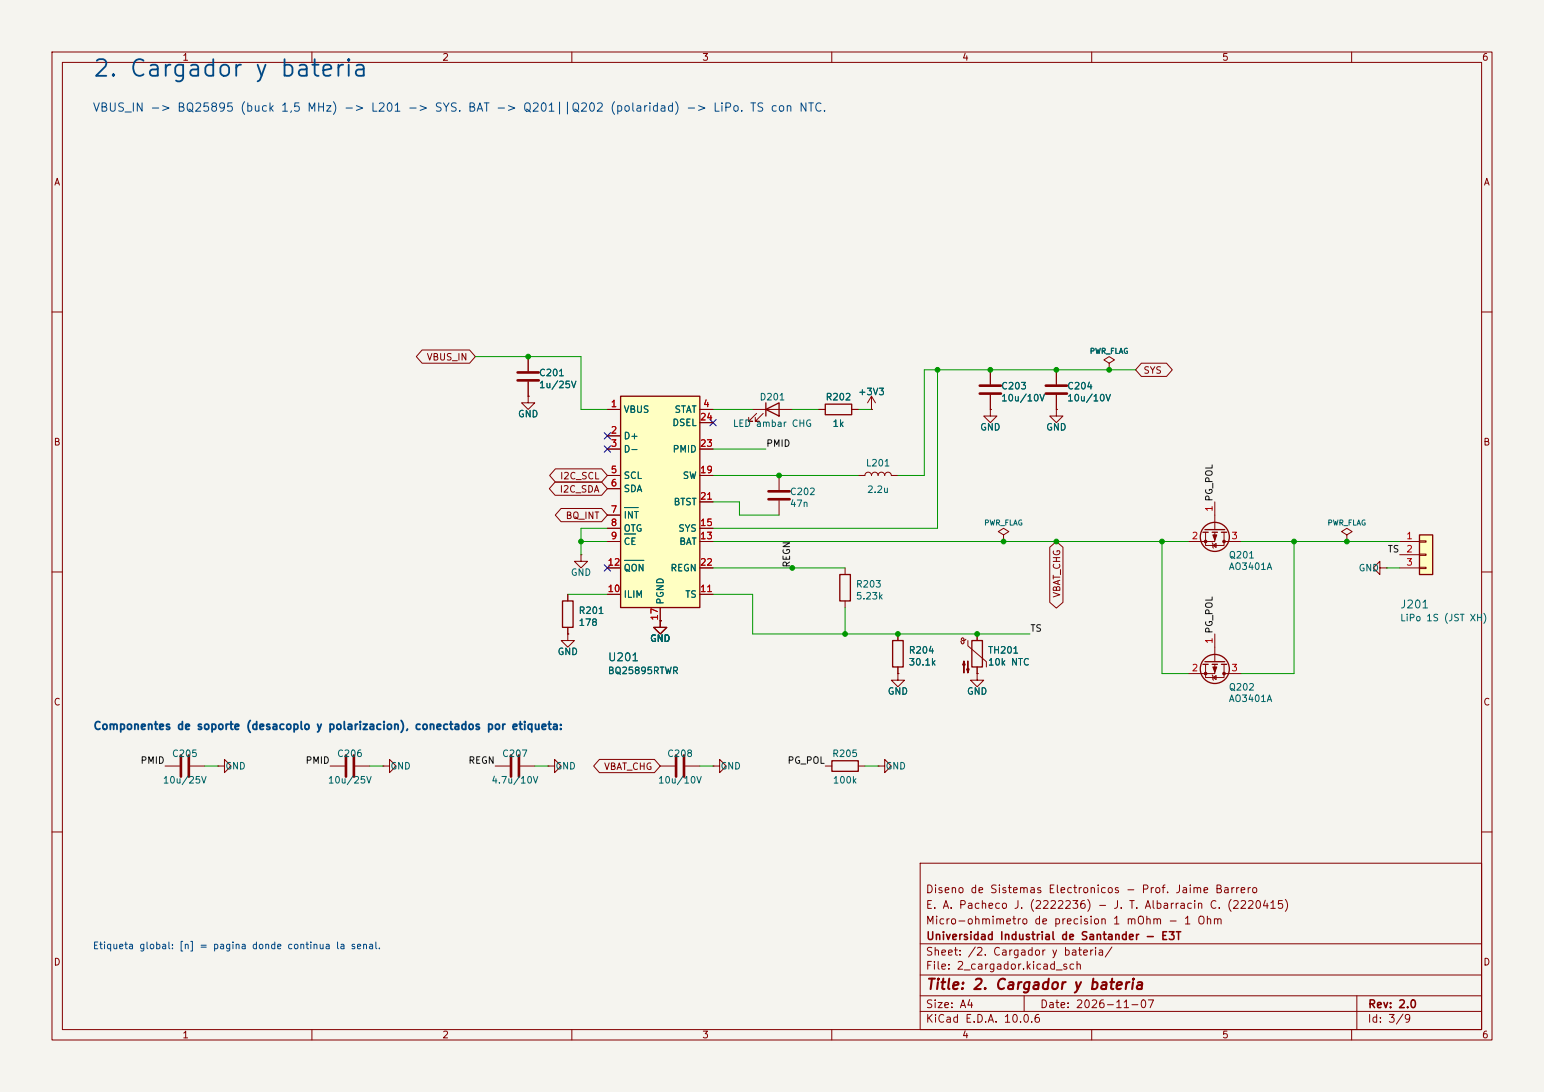
[picture p51: page 3]

VBUS_IN -> BQ25895 (buck 1,5 MHz) -> L201 -> SYS. BAT -> Q201||Q202 (polaridad) -> LiPo. TS con NTC.

SW 19 BTST 21 REGN 22 PMID 23 DSEL 24 C201
1u/25V GND

LiPo 1S (JST XH) GND

Diseno de Sistemas Electronicos - Prof. Jaime Barrero
E. A. Pacheco J. (2222236) - J. T. Albarracin C. (2220415)
Micro-ohmimetro de precision 1 mOhm - 1 Ohm
Universidad Industrial de Santander - E3T
Sheet: /2. Cargador y bateria/
File: 2_cargador.kicad_sch
Title: 2. Cargador y bateria

Etiqueta global: [n] = pagina donde continua la senal.

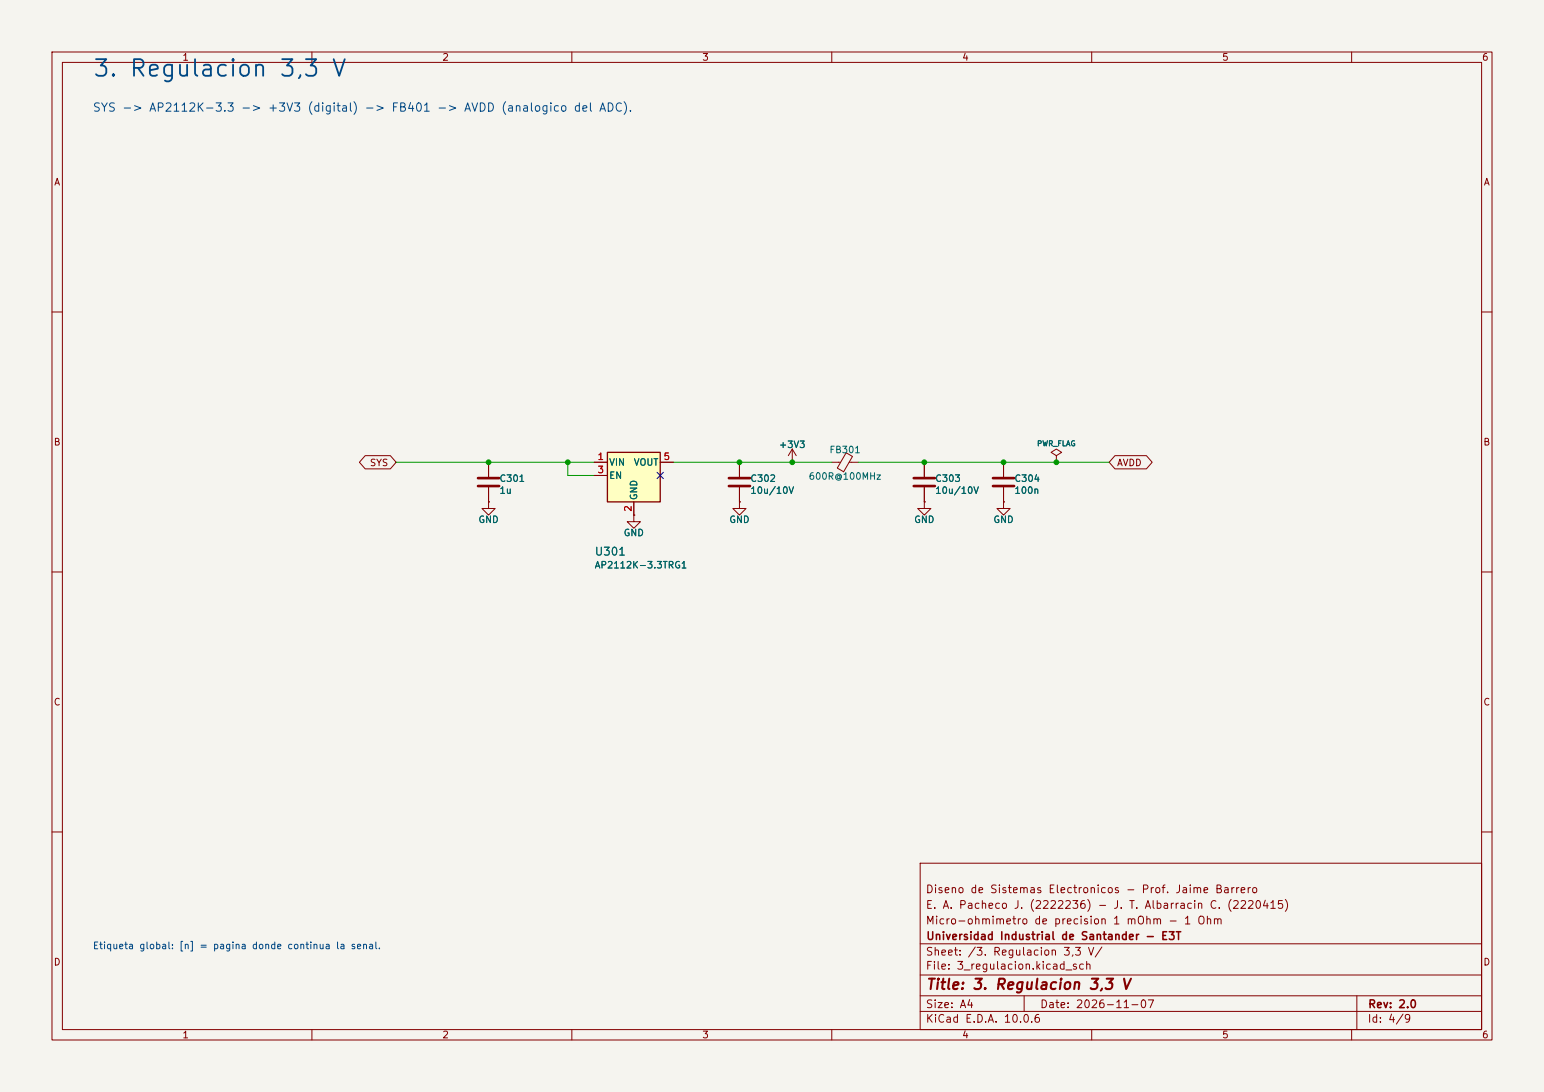
[picture p52: page 4]

Diseno de Sistemas Electronicos - Prof. Jaime Barrero
E. A. Pacheco J. (2222236) - J. T. Albarracin C. (2220415)
Micro-ohmimetro de precision 1 mOhm - 1 Ohm
Universidad Industrial de Santander - E3T
Sheet: /3. Regulacion 3,3 V/
File: 3_regulacion.kicad_sch
Title: 3. Regulacion 3,3 V

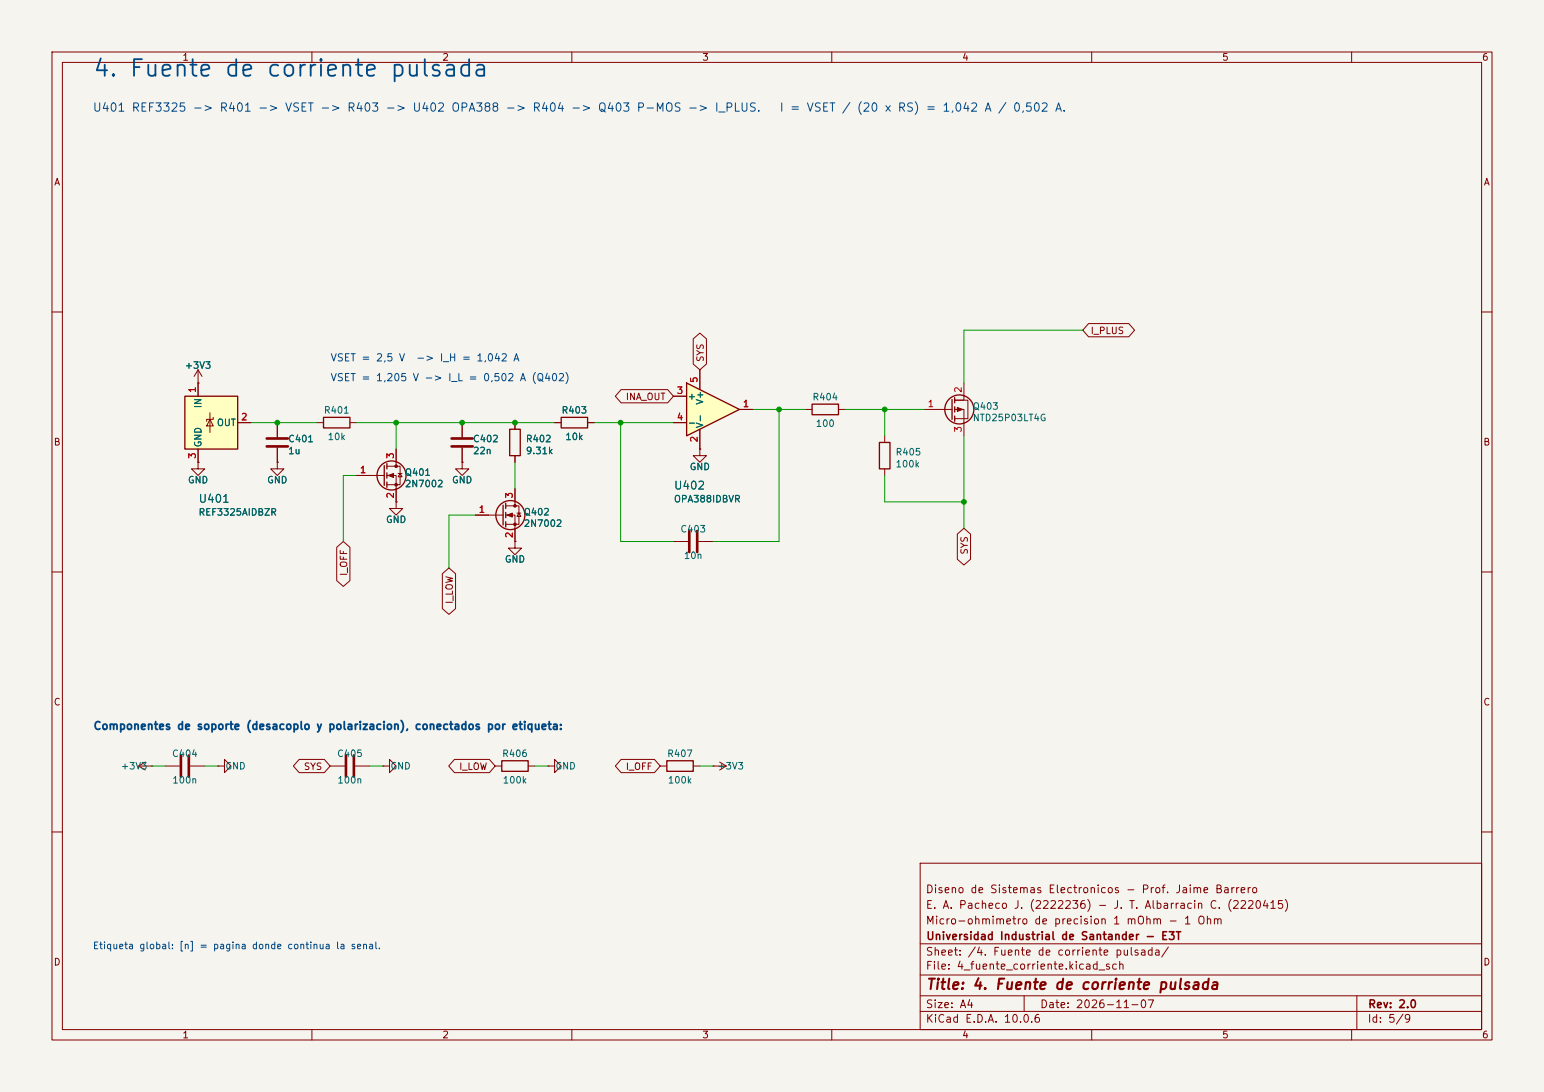
[picture p53: page 5]

4. Fuente de corriente pulsada

E. A. Pacheco J. (2222236) - J. T. Albarracin C. (2220415)
Micro-ohmimetro de precision 1 mOhm - 1 Ohm
Universidad Industrial de Santander - E3T
Sheet: /4. Fuente de corriente pulsada/
File: 4_fuente_corriente.kicad_sch
Title: 4. Fuente de corriente pulsada

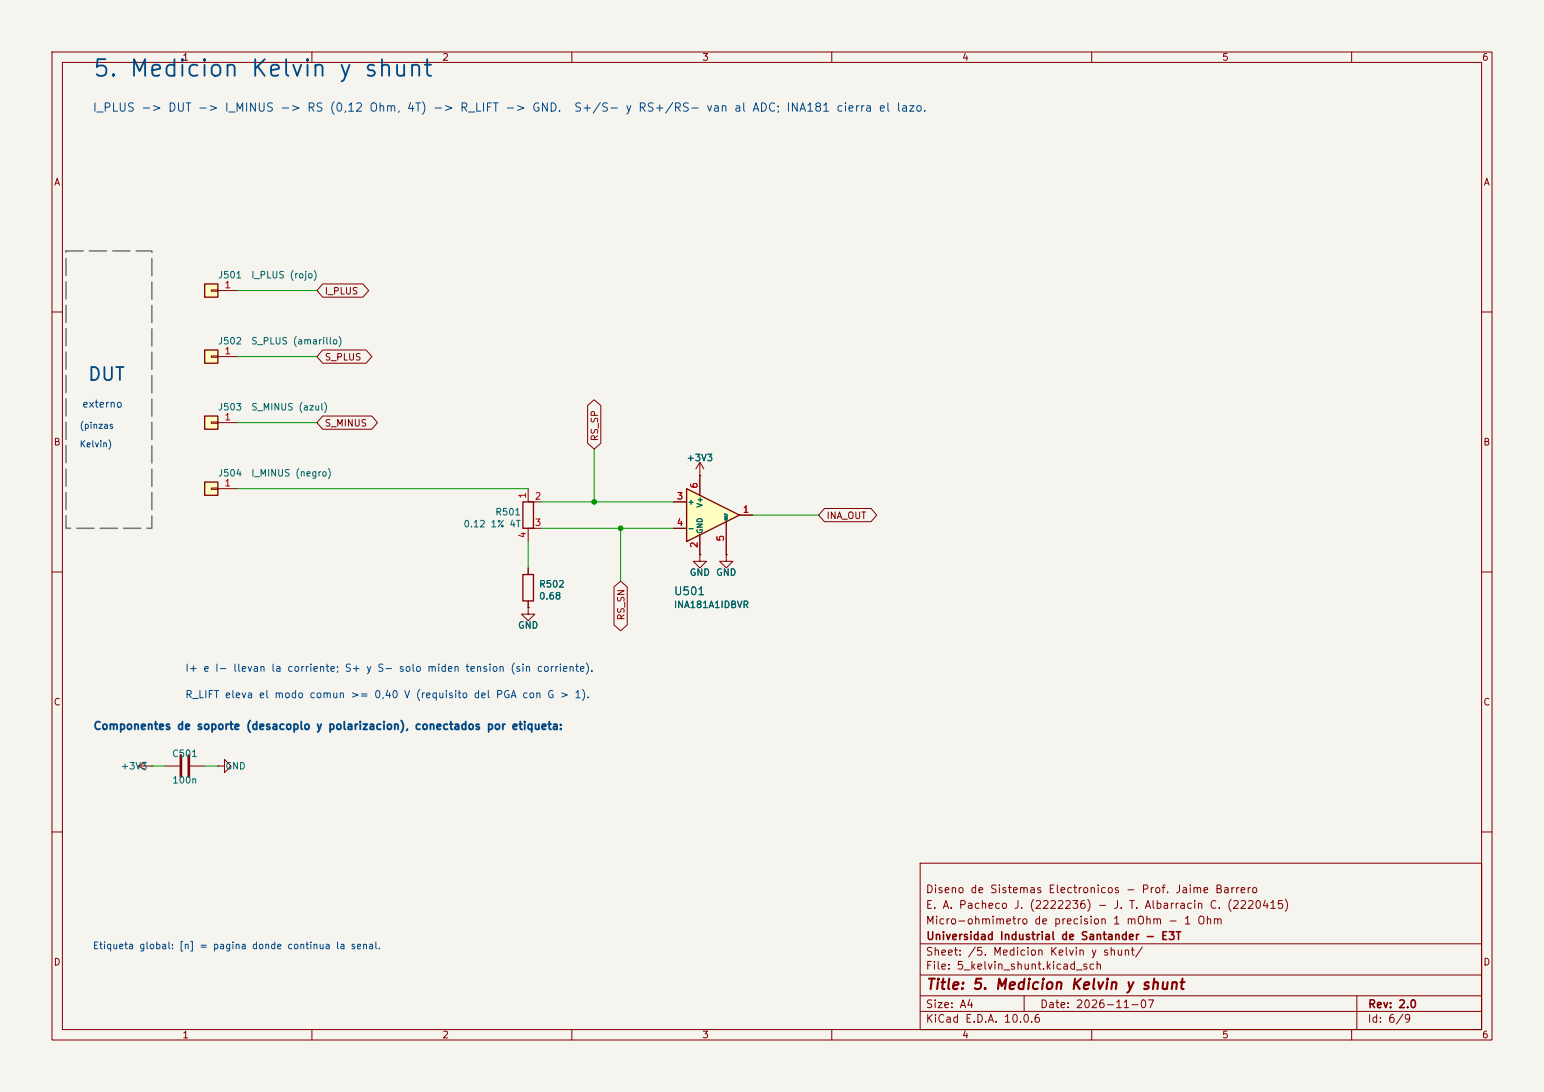
[picture p54: page 6]

I+ e I- llevan la corriente; S+ y S- solo miden tension (sin corriente).

R_LIFT eleva el modo comun >= 0,40 V (requisito del PGA con G > 1).

Componentes de soporte (desacoplo y polarizacion), conectados por etiqueta:

Diseno de Sistemas Electronicos - Prof. Jaime Barrero
E. A. Pacheco J. (2222236) - J. T. Albarracin C. (2220415)
Micro-ohmimetro de precision 1 mOhm - 1 Ohm
Universidad Industrial de Santander - E3T
Sheet: /5. Medicion Kelvin y shunt/
File: 5_kelvin_shunt.kicad_sch
Title: 5. Medicion Kelvin y shunt

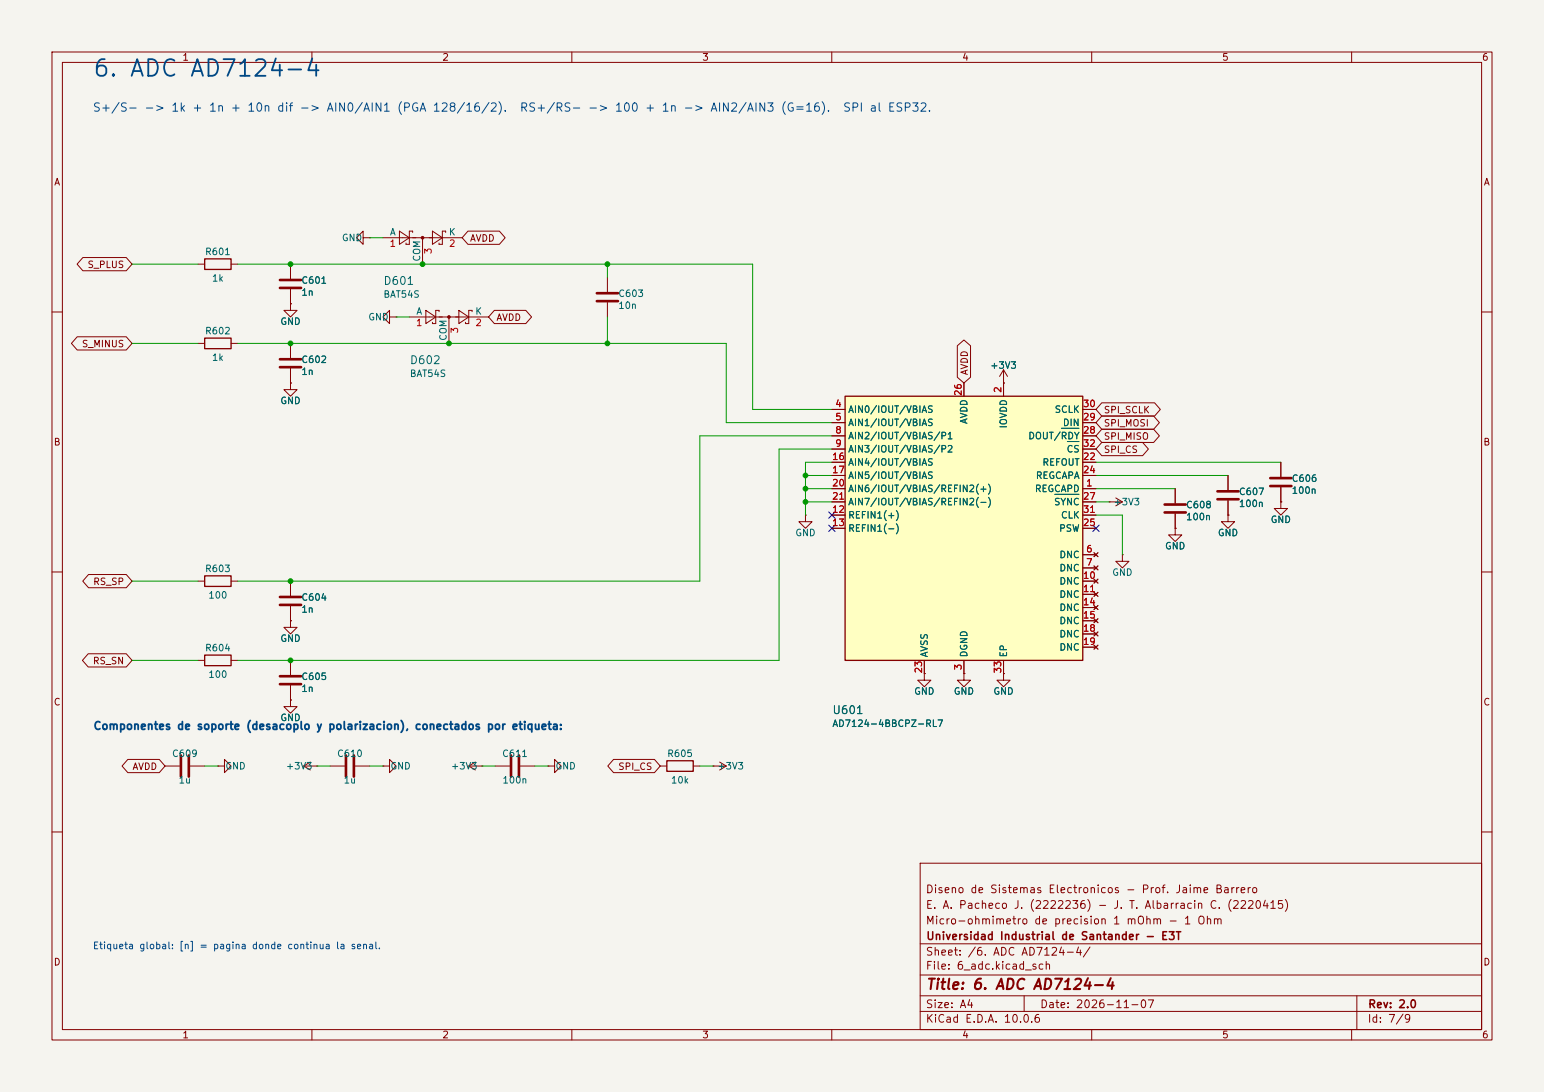
[picture p55: page 7]

SPI_MOSI AVDD
SYNC 27 DOUT/RDY 28 DIN 29 SCLK 30 CLK 31 CS 32 EP 33

Componentes de soporte (desacoplo y polarizacion), conectados por etiqueta:

Etiqueta global: [n] = pagina donde continua la senal. GND

Diseno de Sistemas Electronicos - Prof. Jaime Barrero
E. A. Pacheco J. (2222236) - J. T. Albarracin C. (2220415)
Micro-ohmimetro de precision 1 mOhm - 1 Ohm
Universidad Industrial de Santander - E3T
Sheet: /6. ADC AD7124-4/
File: 6_adc.kicad_sch
Title: 6. ADC AD7124-4

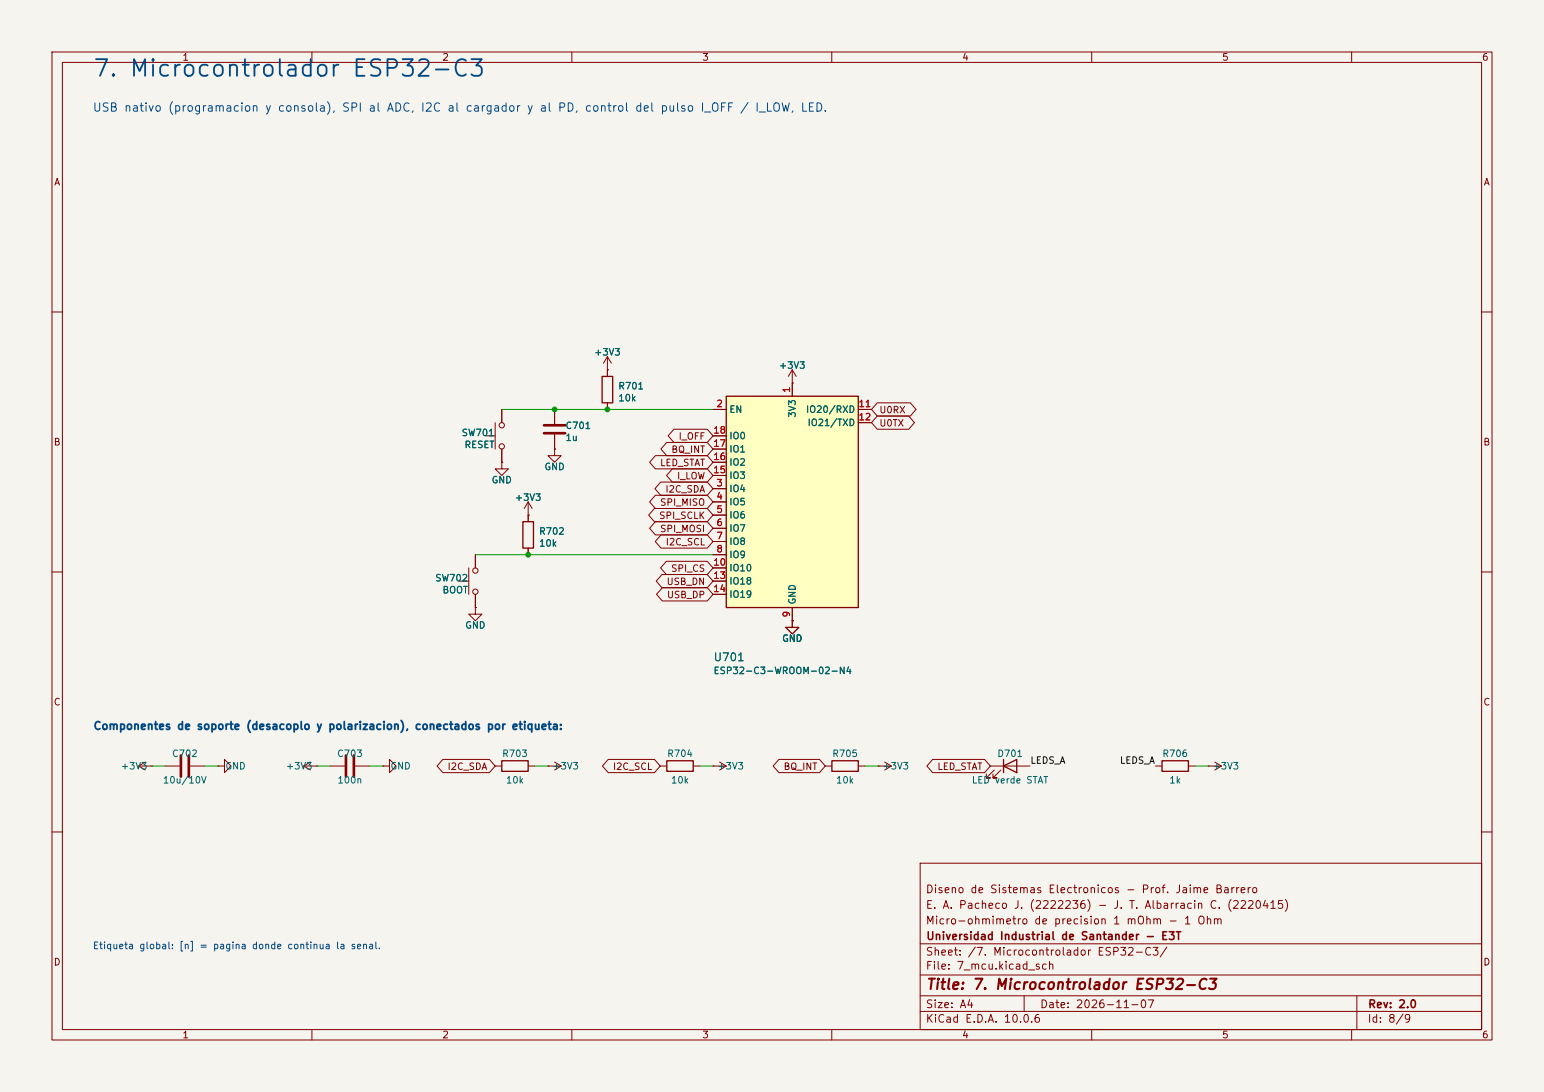
[picture p56: page 8]
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

Componentes de soporte (desacoplo y polarizacion), conectados por etiqueta:

Diseno de Sistemas Electronicos - Prof. Jaime Barrero
E. A. Pacheco J. (2222236) - J. T. Albarracin C. (2220415)
Micro-ohmimetro de precision 1 mOhm - 1 Ohm
Universidad Industrial de Santander - E3T
Sheet: /7. Microcontrolador ESP32-C3/
File: 7_mcu.kicad_sch
Title: 7. Microcontrolador ESP32-C3

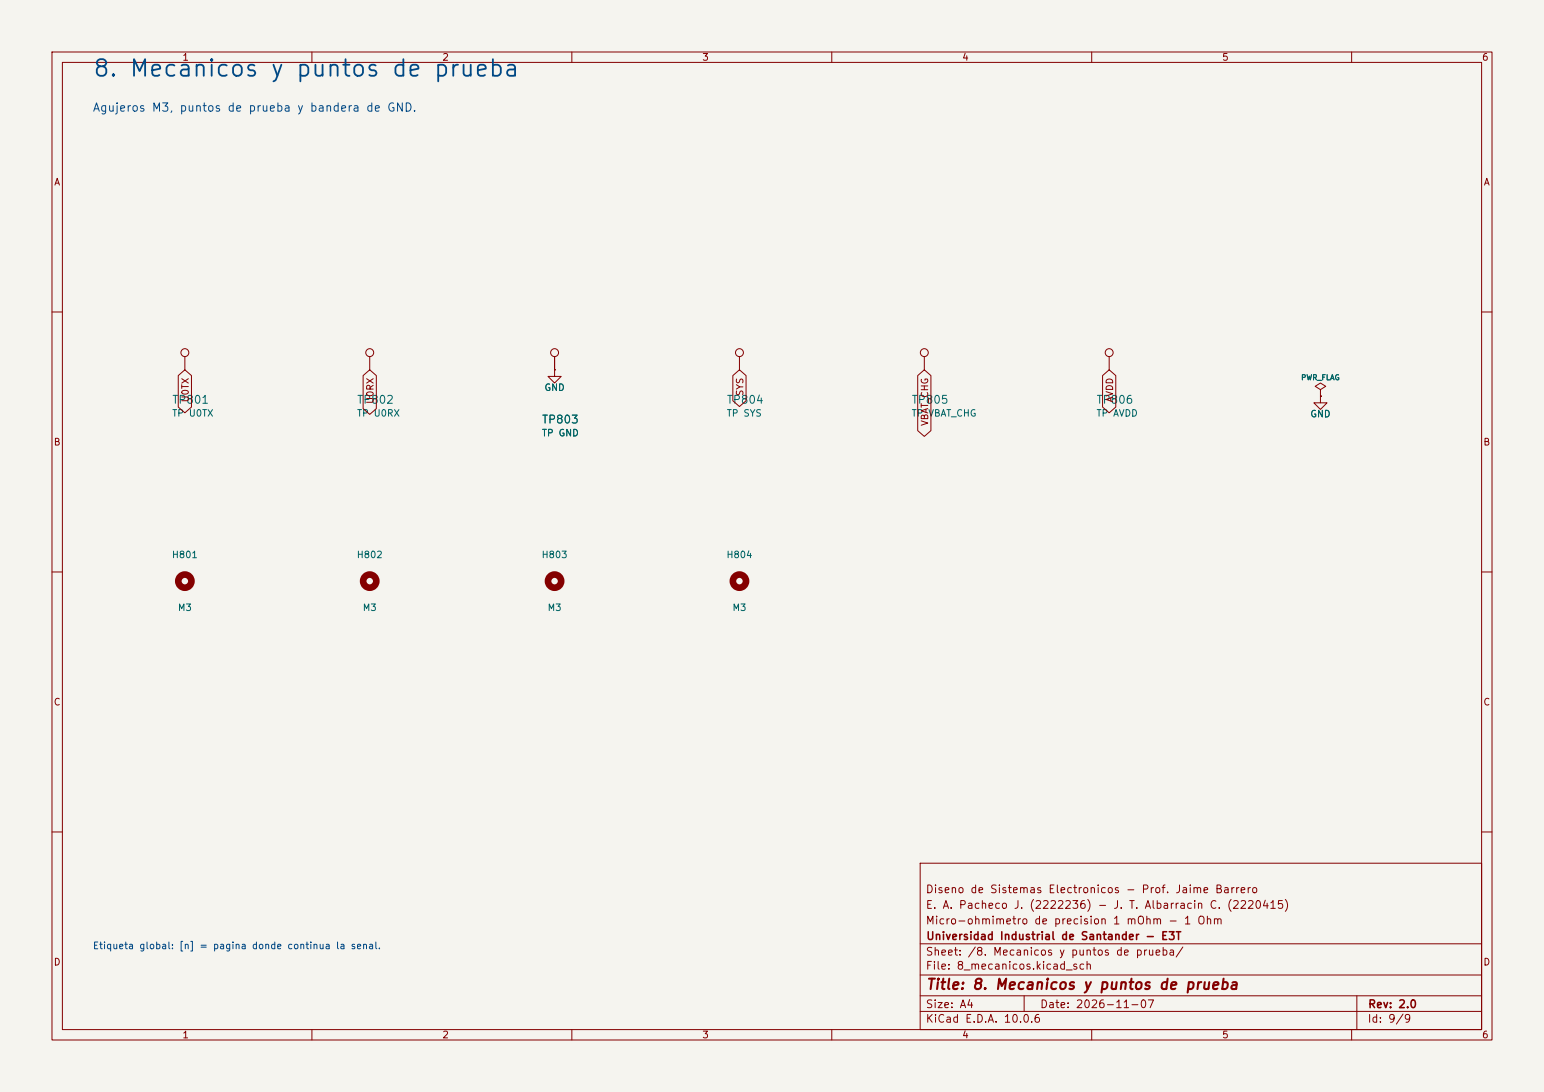
[picture p57: page 9]

8. Mecanicos y puntos de prueba

Agujeros M3, puntos de prueba y bandera de GND.

Diseno de Sistemas Electronicos - Prof. Jaime Barrero
E. A. Pacheco J. (2222236) - J. T. Albarracin C. (2220415)
Micro-ohmimetro de precision 1 mOhm - 1 Ohm
Universidad Industrial de Santander - E3T
Sheet: /8. Mecanicos y puntos de prueba/
File: 8_mecanicos.kicad_sch
Title: 8. Mecanicos y puntos de prueba

Etiqueta global: [n] = pagina donde continua la senal.
