EDWARDPJ26/microohmetro-uis/imagenes/pcb_capas_cobre.pdf

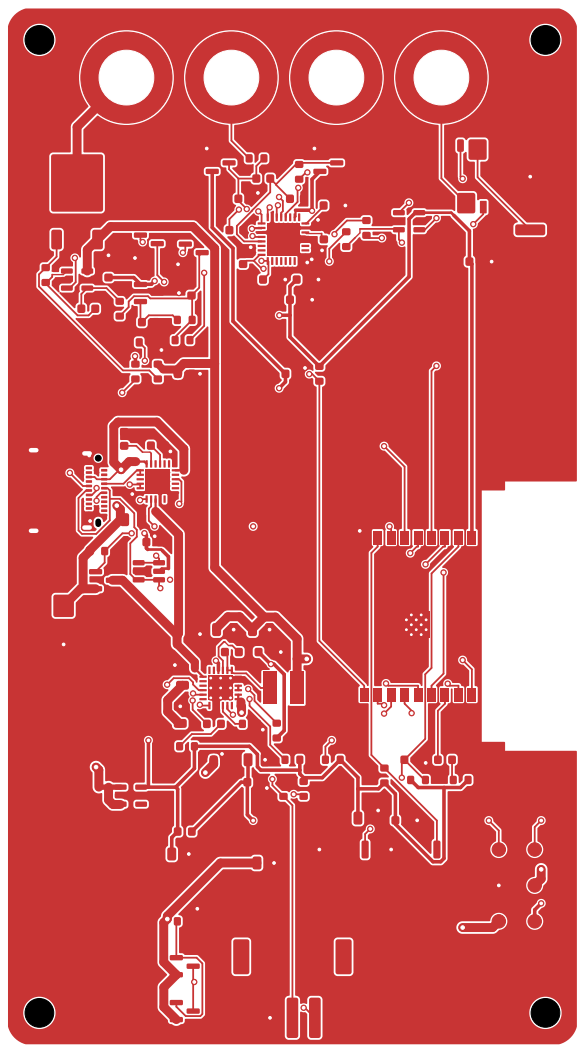
[picture p58: page 1]

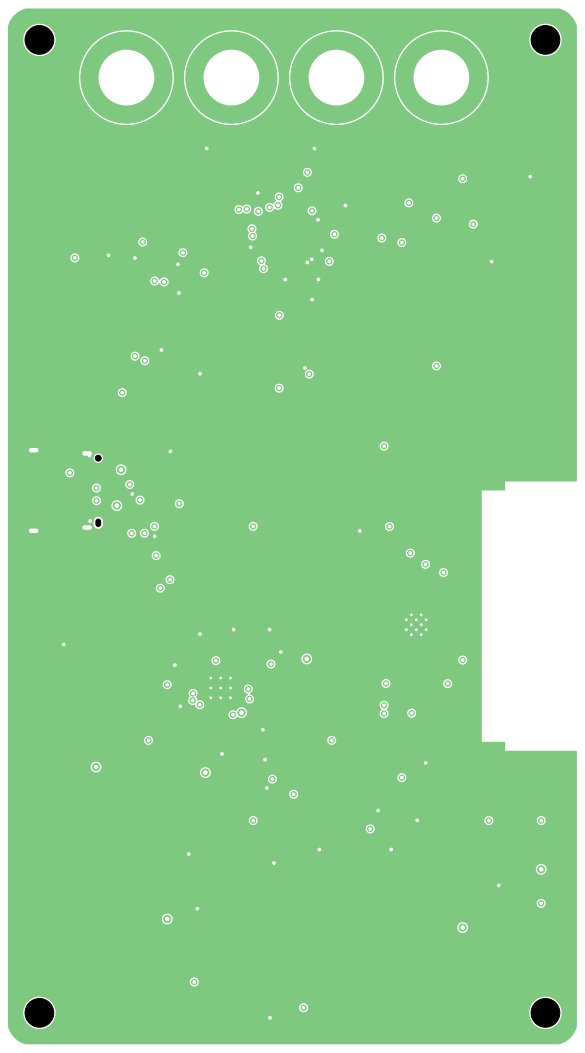
[picture p59: page 2]

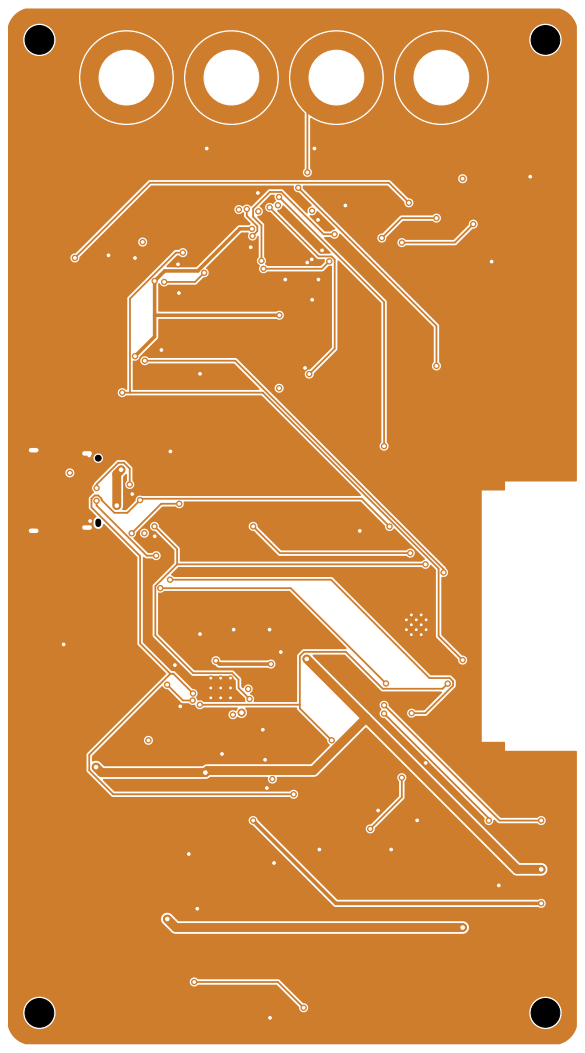
[picture p60: page 3]

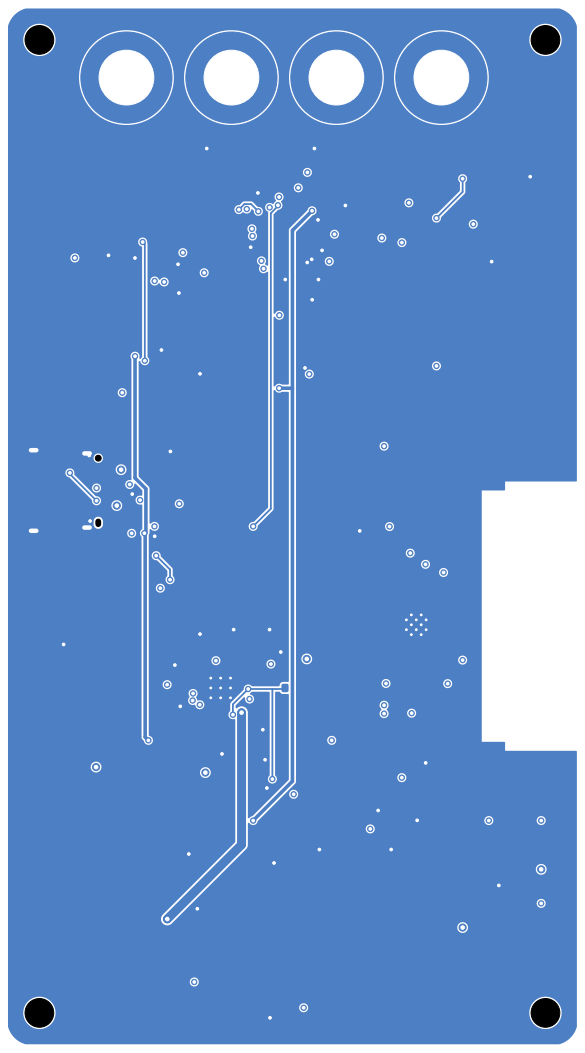
[picture p61: page 4]

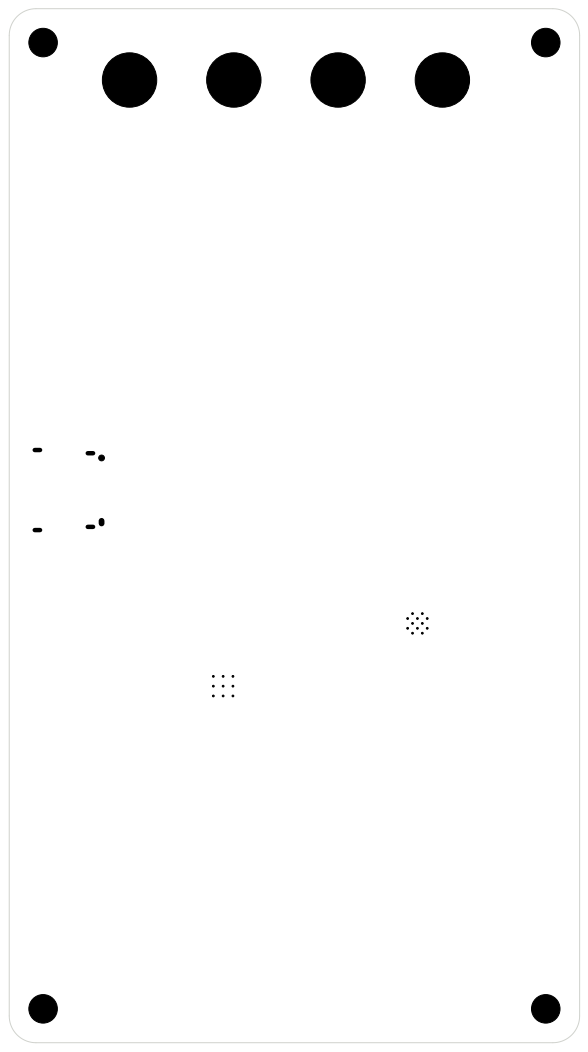
[picture p62: page 5]
