EDWARDPJ26/microohmetro-uis/imagenes/pcb_plano_acotado.pdf

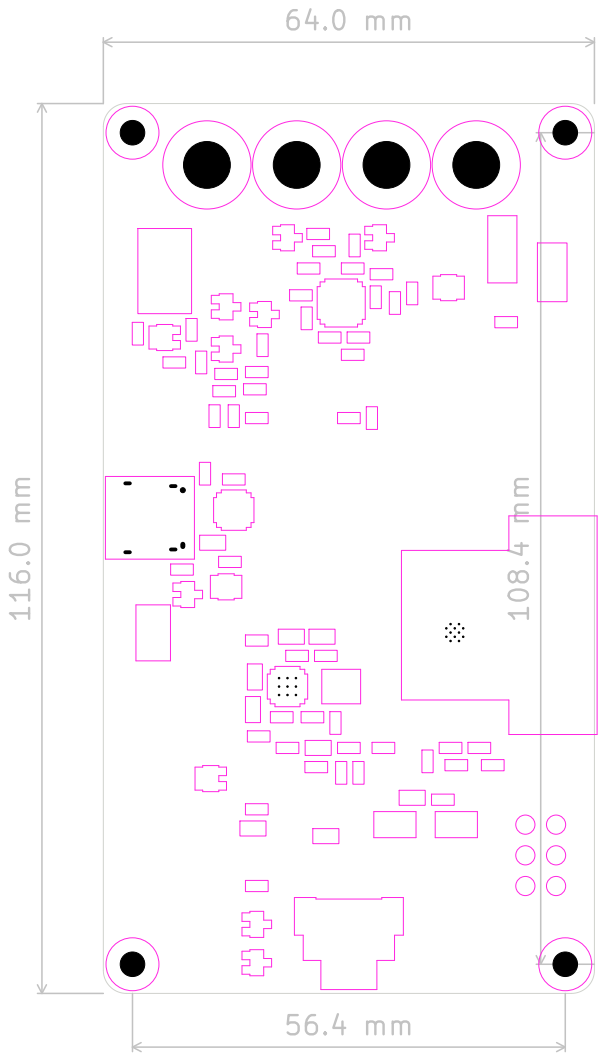
[picture p63: page 1]
