EDWARDPJ26/microohmetro-uis/hardware/kicad/microohmetro_v2.kicad_pcb

## KiCad design hardware/kicad/microohmetro_v2.kicad_pcb (2026-11-08)

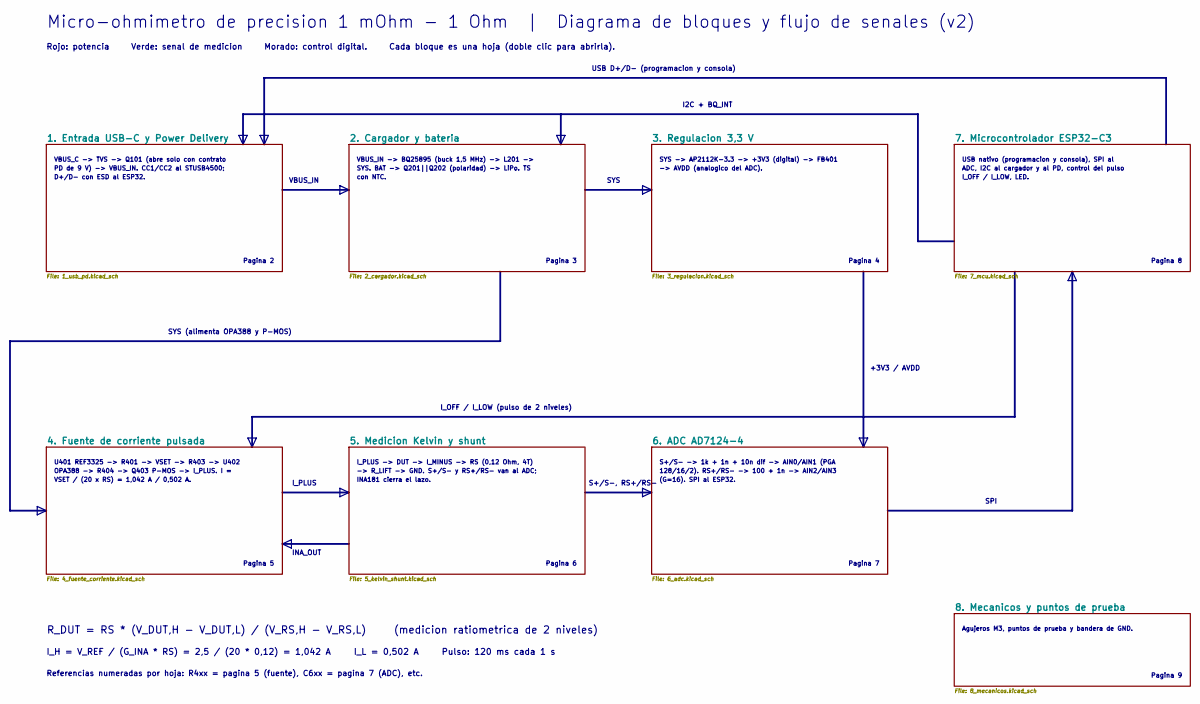
[picture p64: schematic microohmetro_v2.kicad_sch, Micro-ohmimetro v2 - Diagrama general]

Notes on the sheet:
VBUS_C -> TVS -> Q101 (abre solo con contrato
PD de 9 V) -> VBUS_IN. CC1/CC2 al STUSB4500;
D+/D- con ESD al ESP32.
Pagina 2
VBUS_IN -> BQ25895 (buck 1,5 MHz) -> L201 ->
SYS. BAT -> Q201||Q202 (polaridad) -> LiPo. TS
con NTC.
Pagina 3
SYS -> AP2112K-3.3 -> +3V3 (digital) -> FB401
-> AVDD (analogico del ADC).
Pagina 4
U401 REF3325 -> R401 -> VSET -> R403 -> U402
OPA388 -> R404 -> Q403 P-MOS -> I_PLUS. I =
VSET / (20 x RS) = 1,042 A / 0,502 A.
Pagina 5
I_PLUS -> DUT -> I_MINUS -> RS (0,12 Ohm, 4T)
-> R_LIFT -> GND. S+/S- y RS+/RS- van al ADC;
INA181 cierra el lazo.
Pagina 6
S+/S- -> 1k + 1n + 10n dif -> AIN0/AIN1 (PGA
128/16/2). RS+/RS- -> 100 + 1n -> AIN2/AIN3
(G=16). SPI al ESP32.
Pagina 7
USB nativo (programacion y consola), SPI al
ADC, I2C al cargador y al PD, control del pulso
I_OFF / I_LOW, LED.
Pagina 8
Agujeros M3, puntos de prueba y bandera de GND.
Pagina 9
VBUS_IN
SYS
SYS (alimenta OPA388 y P-MOS)
+3V3 / AVDD
I_PLUS
INA_OUT
S+/S-, RS+/RS-
SPI
I_OFF / I_LOW (pulso de 2 niveles)
I2C + BQ_INT
USB D+/D- (programacion y consola)
Micro-ohmimetro de precision 1 mOhm - 1 Ohm | Diagrama de bloques y flujo de senales (v2)
Rojo: potencia Verde: senal de medicion Morado: control digital. Cada bloque es una hoja (doble clic para abrirla).
R_DUT = RS * (V_DUT,H - V_DUT,L) / (V_RS,H - V_RS,L) (medicion ratiometrica de 2 niveles)
I_H = V_REF / (G_INA * RS) = 2,5 / (20 * 0,12) = 1,042 A I_L = 0,502 A Pulso: 120 ms cada 1 s
Referencias numeradas por hoja: R4xx = pagina 5 (fuente), C6xx = pagina 7 (ADC), etc.

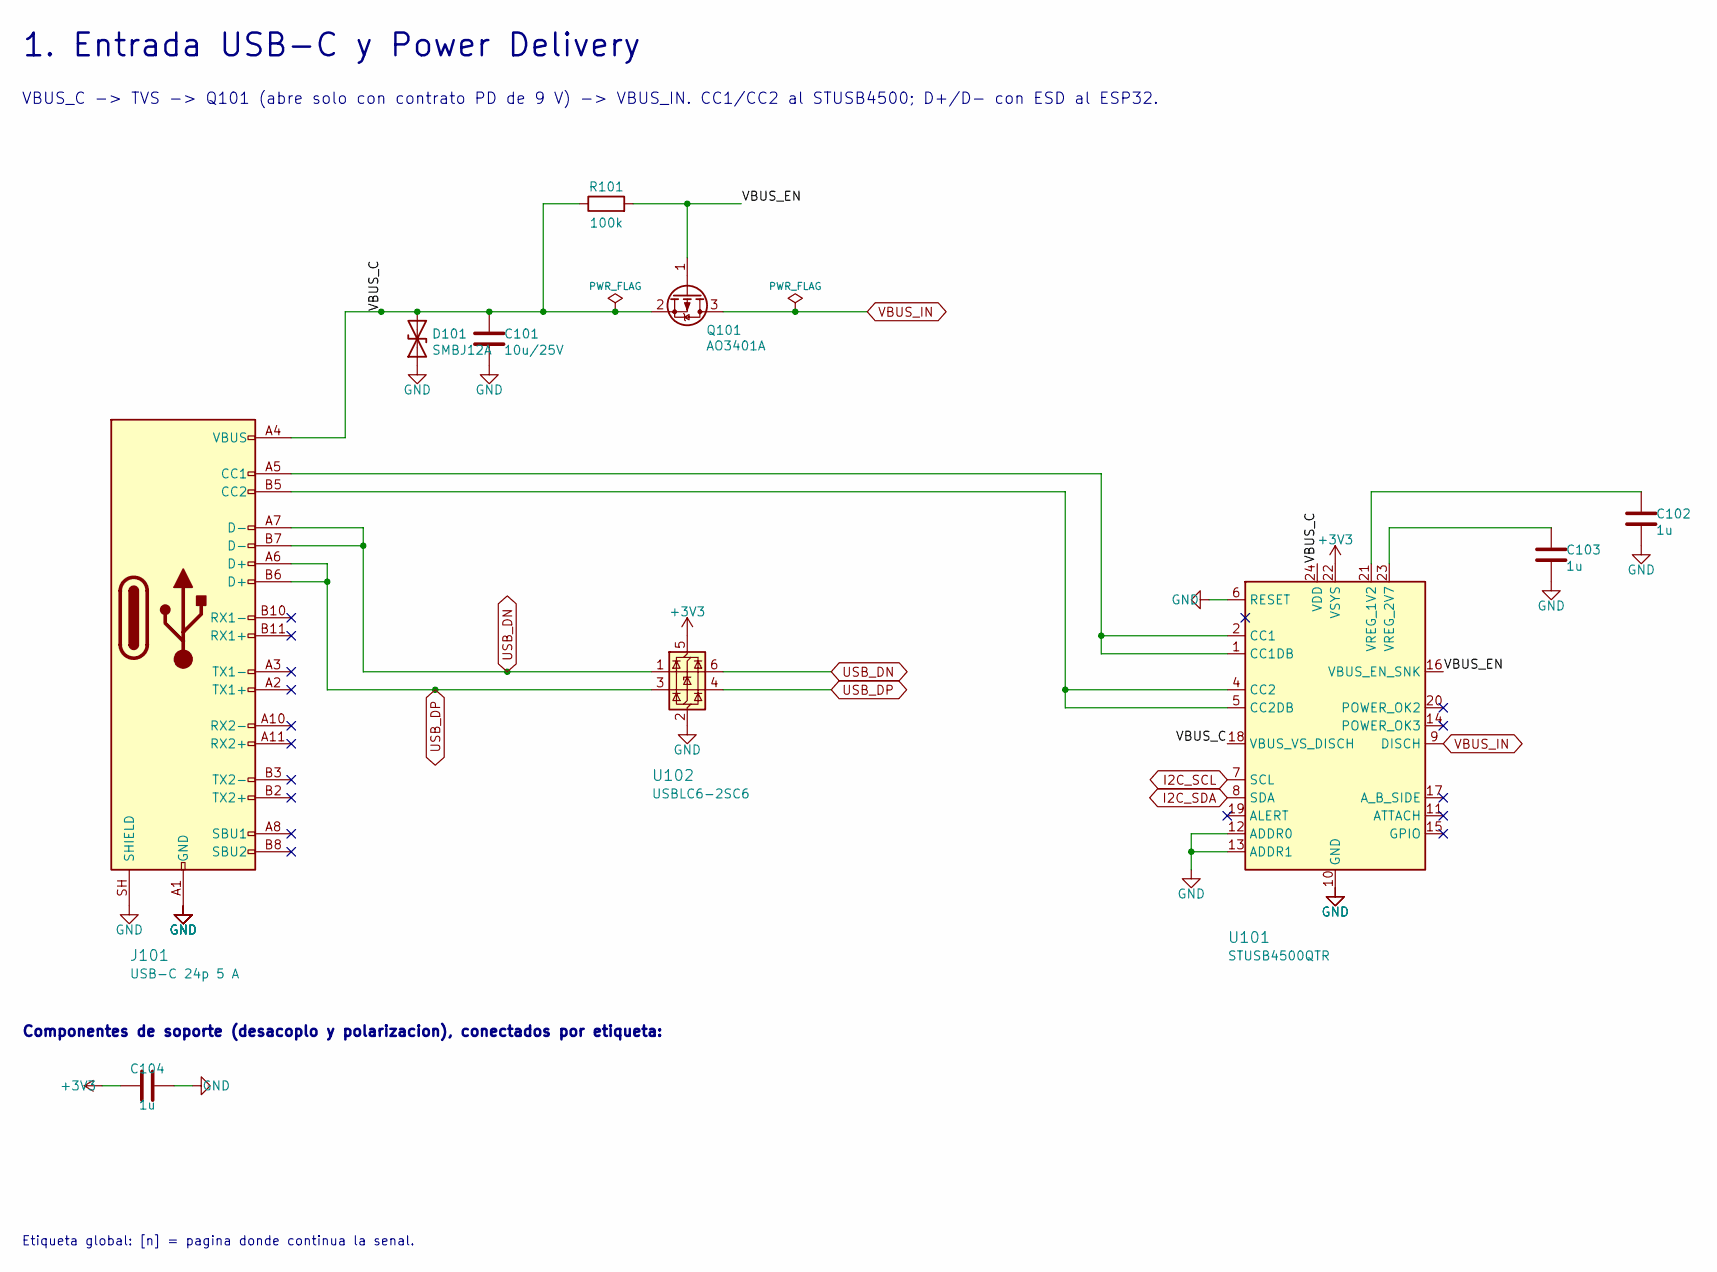
[picture p65: schematic 1_usb_pd.kicad_sch, 1. Entrada USB-C y Power Delivery]

Parts:
C101: 10u/25V; C_0805_2012Metric
C102, C103, C104: 1u; C_0603_1608Metric
D101: SMBJ12A; D_SMB; MPN SMBJ12A
J101: USB-C 24p 5 A; USB_C_Receptacle_Amphenol_12401610E4-2A; MPN Amphenol 12401610E4#2A
Q101: AO3401A; SOT-23; MPN AO3401A
R101: 100k; R_0603_1608Metric
U101: STUSB4500QTR; QFN-24-1EP_4x4mm_P0.5mm_EP2.7x2.7mm; MPN STUSB4500QTR
U102: USBLC6-2SC6; SOT-23-6; MPN USBLC6-2SC6

Connections:
+3V3: C104.1, U101.22 (VSYS), U102.5 (VBUS); also elsewhere on the board
GND: C101.2, C102.2, C103.2, C104.2, D101.1 (A1), J101.A1 (GND), J101.A12 (GND), J101.B1 (GND), J101.B12 (GND), J101.SH (SHIELD), U101.6 (RESET), U101.10 (GND), U101.12 (ADDR0), U101.13 (ADDR1), U101.25 (GND), U102.2 (GND); also elsewhere on the board
I2C_SCL: U101.7 (SCL); also elsewhere on the board
I2C_SDA: U101.8 (SDA); also elsewhere on the board
unnamed: J101.A5 (CC1), U101.1 (CC1DB), U101.2 (CC1)
unnamed: J101.B5 (CC2), U101.4 (CC2), U101.5 (CC2DB)
unnamed: C102.1, U101.21 (VREG_1V2)
unnamed: C103.1, U101.23 (VREG_2V7)
USB_DN: J101.A7 (D-), J101.B7 (D-), U102.1 (I/O1), U102.6 (I/O1); also elsewhere on the board
USB_DP: J101.A6 (D+), J101.B6 (D+), U102.3 (I/O2), U102.4 (I/O2); also elsewhere on the board
VBUS_C: C101.1, D101.2 (A2), J101.A4 (VBUS), J101.A9 (VBUS), J101.B4 (VBUS), J101.B9 (VBUS), Q101.2 (S), R101.1, U101.18 (VBUS_VS_DISCH), U101.24 (VDD)
VBUS_EN: Q101.1 (G), R101.2, U101.16 (VBUS_EN_SNK)
VBUS_IN: Q101.3 (D), U101.9 (DISCH); also elsewhere on the board

Notes on the sheet:
1. Entrada USB-C y Power Delivery
VBUS_C -> TVS -> Q101 (abre solo con contrato PD de 9 V) -> VBUS_IN. CC1/CC2 al STUSB4500; D+/D- con ESD al ESP32.
Componentes de soporte (desacoplo y polarizacion), conectados por etiqueta:
Etiqueta global: [n] = pagina donde continua la senal.

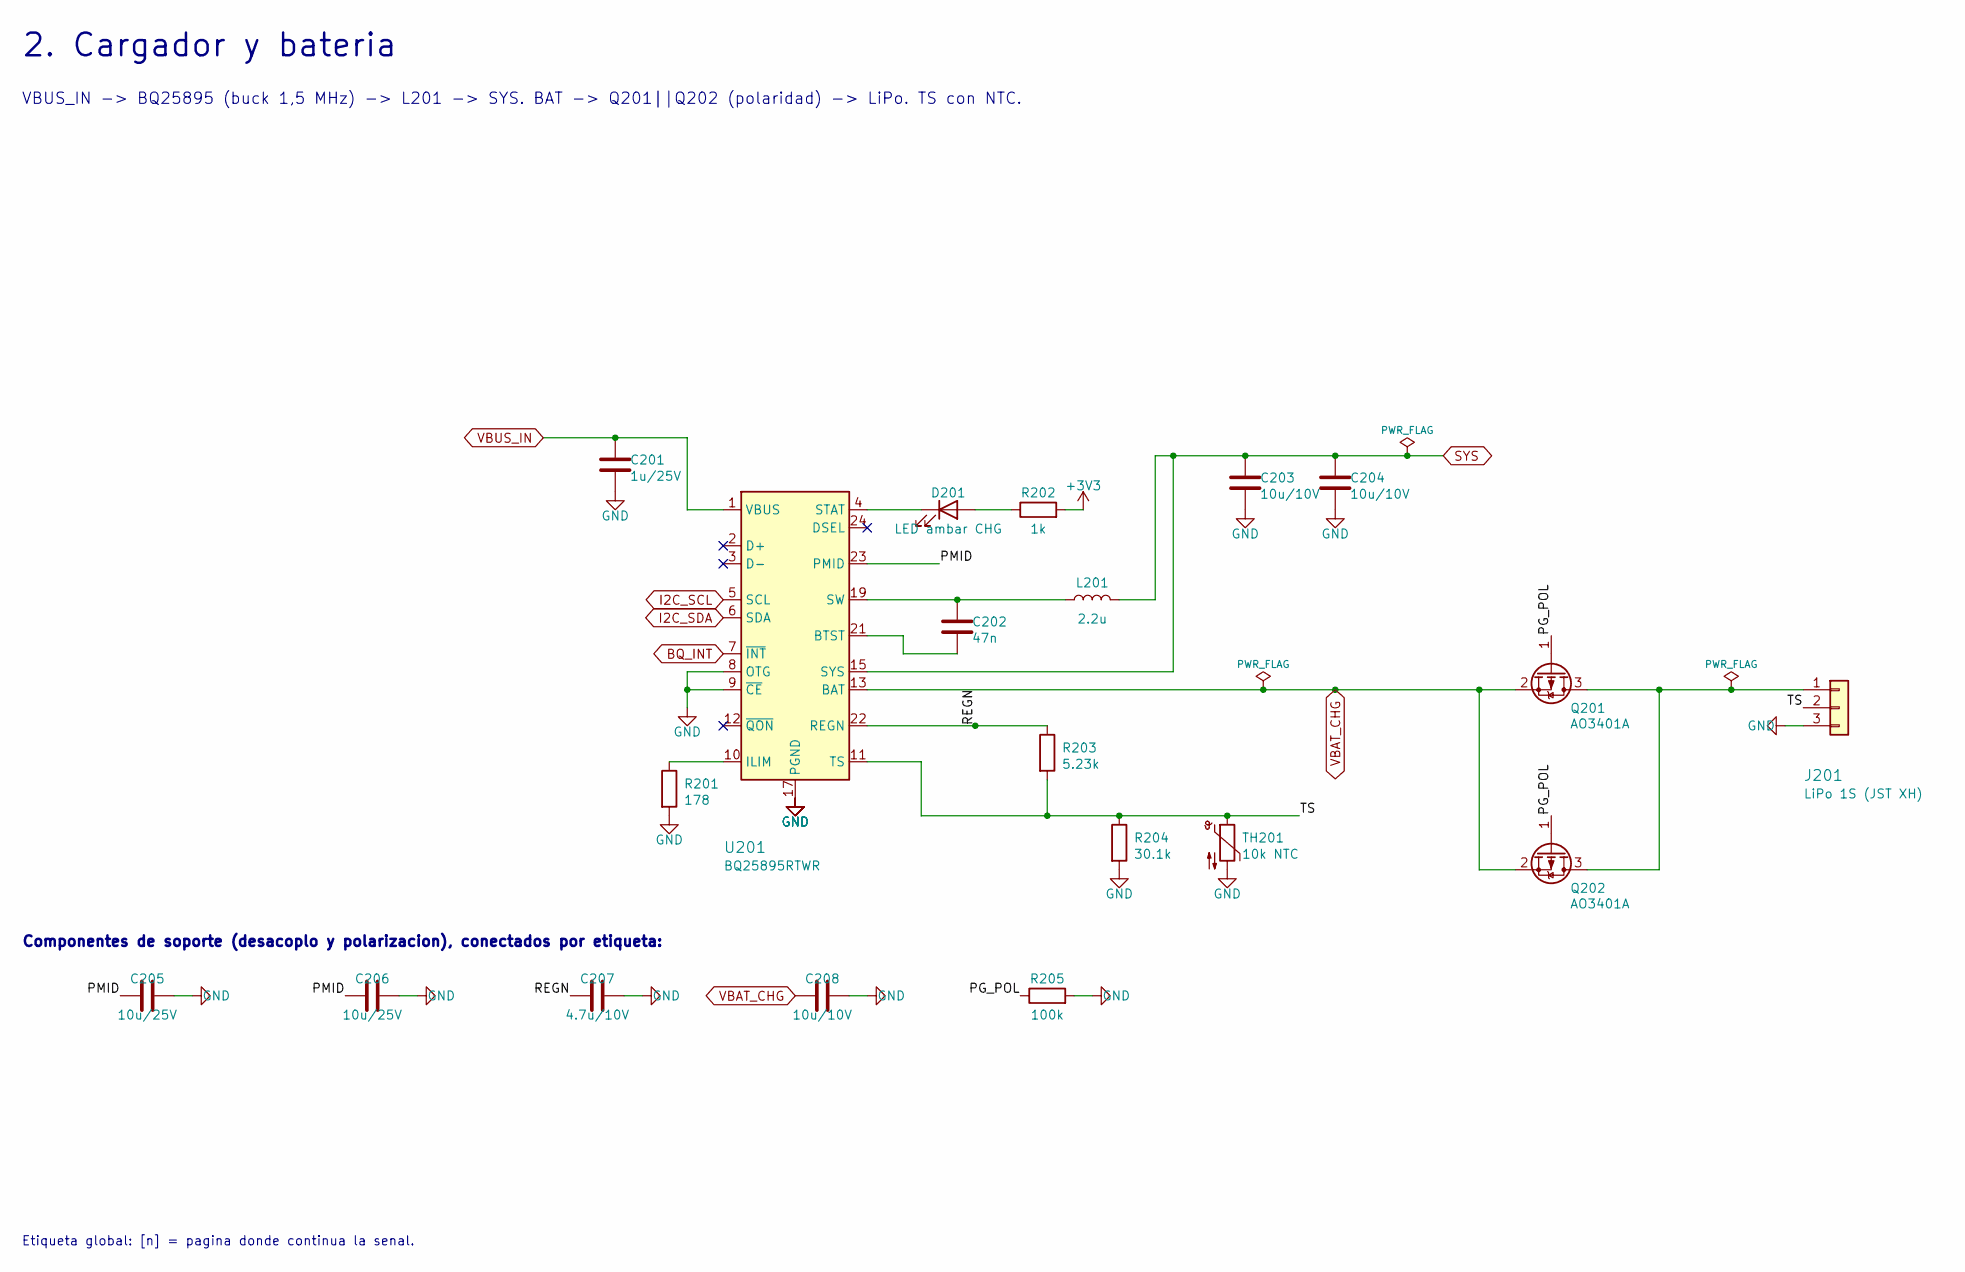
[picture p66: schematic 2_cargador.kicad_sch, 2. Cargador y bateria]

Parts:
C201: 1u/25V; C_0603_1608Metric
C202: 47n; C_0603_1608Metric
C203, C204, C208: 10u/10V; C_0805_2012Metric
C205, C206: 10u/25V; C_0805_2012Metric
C207: 4.7u/10V; C_0603_1608Metric
D201: LED ambar CHG; LED_0603_1608Metric
J201: LiPo 1S (JST XH); JST_XH_S3B-XH-SM4-TB_1x03-1MP_P2.50mm_Horizontal; MPN S3B-XH-SM4-TB
L201: 2.2u; L_Bourns-SRN4018; MPN SRN4018-2R2M
Q201, Q202: AO3401A; SOT-23; MPN AO3401A
R201: 178; R_0603_1608Metric
R202: 1k; R_0603_1608Metric
R203: 5.23k; R_0603_1608Metric
R204: 30.1k; R_0603_1608Metric
R205: 100k; R_0603_1608Metric
TH201: 10k NTC; R_0603_1608Metric; MPN NCP18XH103F03RB
U201: BQ25895RTWR; Texas_RTW_WQFN-24-1EP_4x4mm_P0.5mm_EP2.7x2.7mm_ThermalVias; MPN BQ25895RTWR

Connections:
+3V3: R202.2; also elsewhere on the board
BQ_INT: U201.7 (~INT); also elsewhere on the board
GND: C201.2, C203.2, C204.2, C205.2, C206.2, C207.2, C208.2, J201.3, R201.2, R204.2, R205.2, TH201.2, U201.8 (OTG), U201.9 (~CE), U201.17 (PGND), U201.18 (PGND), U201.25 (PGND); also elsewhere on the board
I2C_SCL: U201.5 (SCL); also elsewhere on the board
I2C_SDA: U201.6 (SDA); also elsewhere on the board
unnamed: C202.1, L201.1, U201.19 (SW), U201.20 (SW)
unnamed: D201.2 (A), R202.1
unnamed: D201.1 (K), U201.4 (STAT)
unnamed: J201.1, Q201.3 (D), Q202.3 (D)
unnamed: C202.2, U201.21 (BTST)
unnamed: R201.1, U201.10 (ILIM)
PG_POL: Q201.1 (G), Q202.1 (G), R205.1
PMID: C205.1, C206.1, U201.23 (PMID)
REGN: C207.1, R203.1, U201.22 (REGN)
SYS: C203.1, C204.1, L201.2, U201.15 (SYS), U201.16 (SYS); also elsewhere on the board
TS: J201.2, R203.2, R204.1, TH201.1, U201.11 (TS)
VBAT_CHG: C208.1, Q201.2 (S), Q202.2 (S), U201.13 (BAT), U201.14 (BAT); also elsewhere on the board
VBUS_IN: C201.1, U201.1 (VBUS); also elsewhere on the board

Notes on the sheet:
2. Cargador y bateria
VBUS_IN -> BQ25895 (buck 1,5 MHz) -> L201 -> SYS. BAT -> Q201||Q202 (polaridad) -> LiPo. TS con NTC.
Componentes de soporte (desacoplo y polarizacion), conectados por etiqueta:
Etiqueta global: [n] = pagina donde continua la senal.

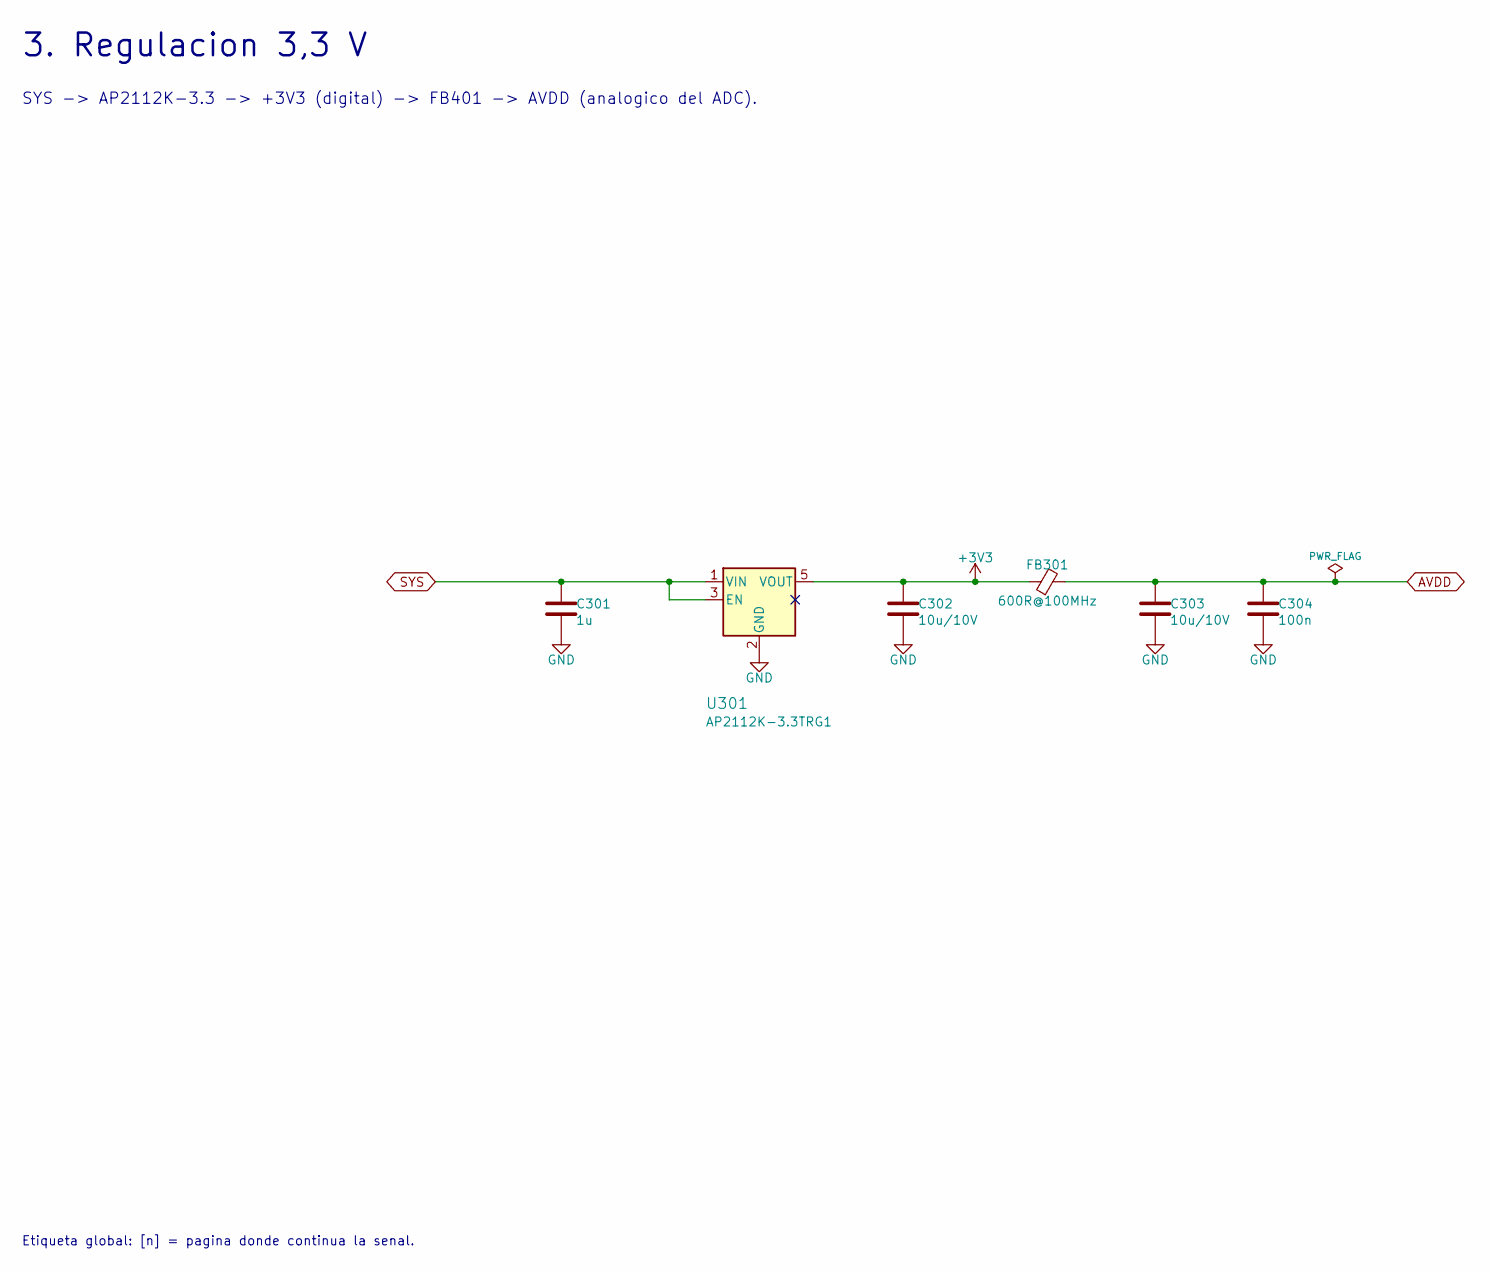
[picture p67: schematic 3_regulacion.kicad_sch, 3. Regulacion 3,3 V]

Parts:
C301: 1u; C_0603_1608Metric
C302, C303: 10u/10V; C_0805_2012Metric
C304: 100n; C_0603_1608Metric
FB301: 600R@100MHz; L_0603_1608Metric; MPN BLM18KG601SN1D
U301: AP2112K-3.3TRG1; SOT-23-5; MPN AP2112K-3.3TRG1

Connections:
+3V3: C302.1, FB301.1, U301.5 (VOUT); also elsewhere on the board
AVDD: C303.1, C304.1, FB301.2; also elsewhere on the board
GND: C301.2, C302.2, C303.2, C304.2, U301.2 (GND); also elsewhere on the board
SYS: C301.1, U301.1 (VIN), U301.3 (EN); also elsewhere on the board

Notes on the sheet:
3. Regulacion 3,3 V
SYS -> AP2112K-3.3 -> +3V3 (digital) -> FB401 -> AVDD (analogico del ADC).
Etiqueta global: [n] = pagina donde continua la senal.

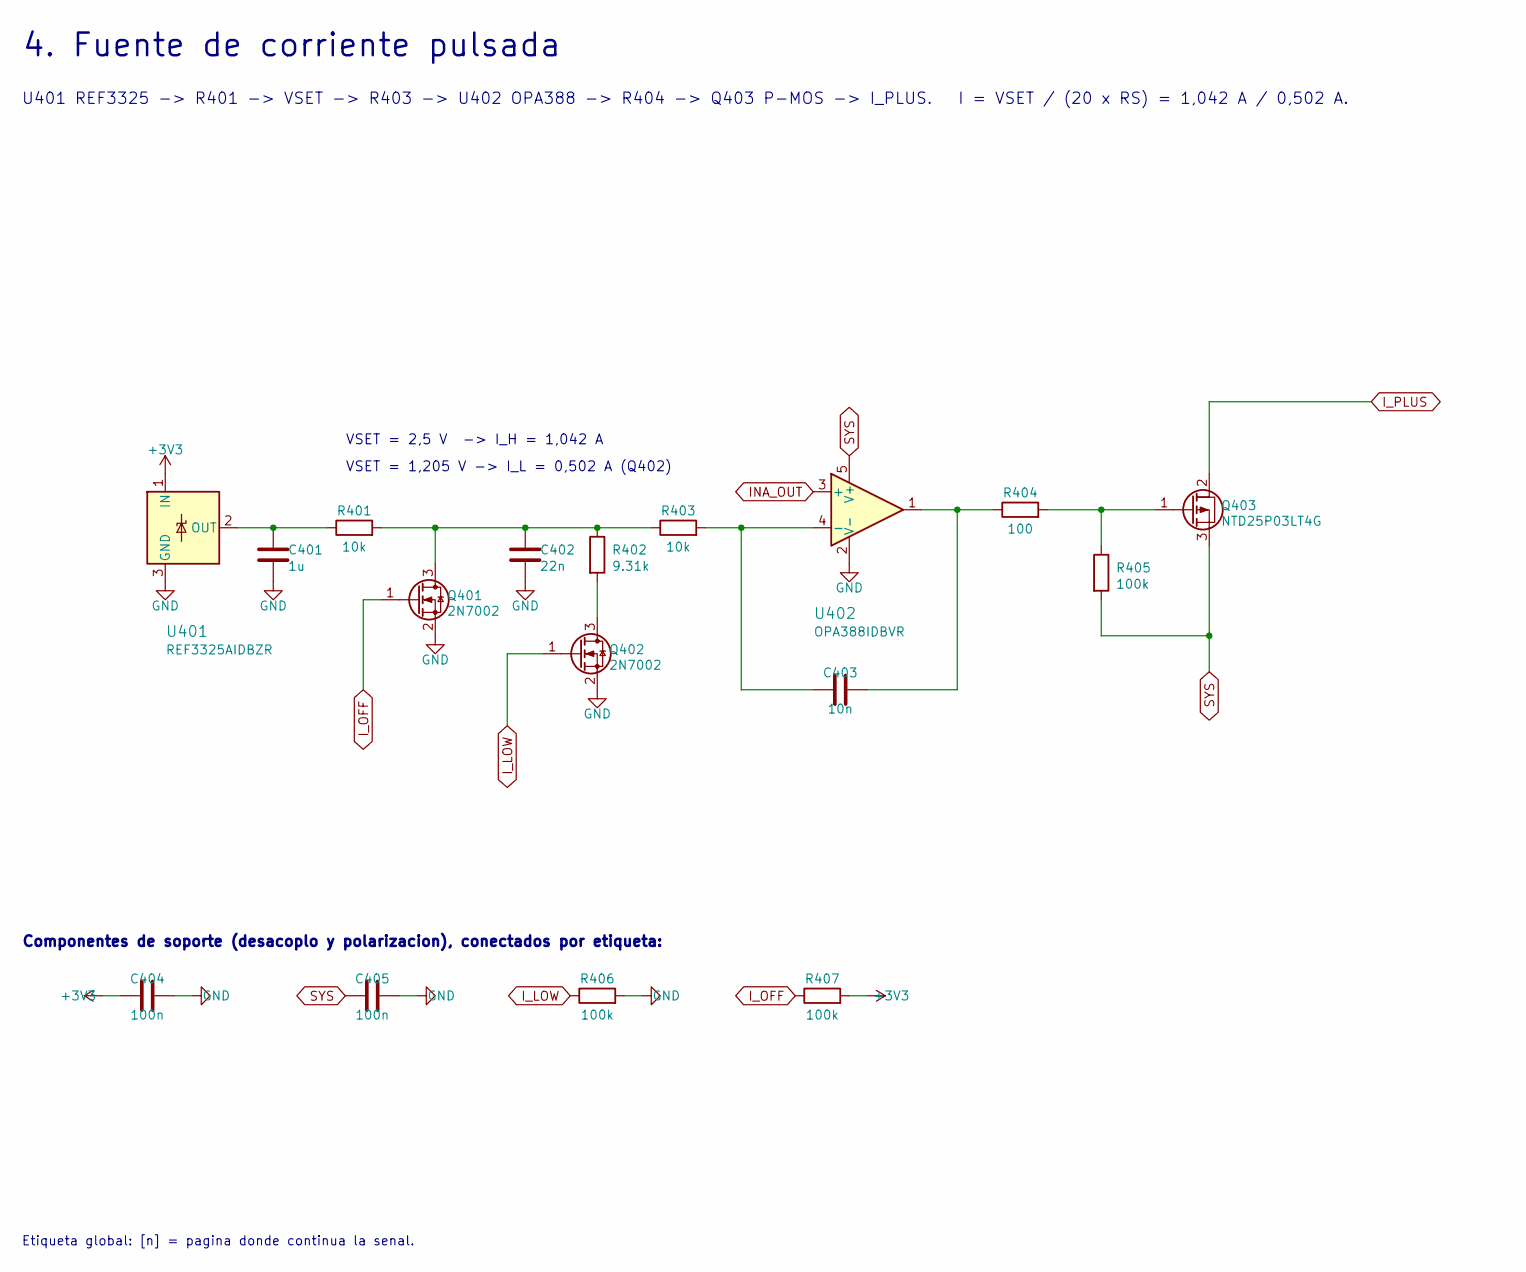
[picture p68: schematic 4_fuente_corriente.kicad_sch, 4. Fuente de corriente pulsada]

Parts:
C401: 1u; C_0603_1608Metric
C402: 22n; C_0603_1608Metric
C403: 10n; C_0603_1608Metric
C404, C405: 100n; C_0603_1608Metric
Q401, Q402: 2N7002; SOT-23; MPN 2N7002
Q403: NTD25P03LT4G; TO-252-2; MPN NTD25P03LT4G
R401, R403: 10k; R_0603_1608Metric
R402: 9.31k; R_0603_1608Metric
R404: 100; R_0603_1608Metric
R405, R406, R407: 100k; R_0603_1608Metric
U401: REF3325AIDBZR; SOT-23; MPN REF3325AIDBZR
U402: OPA388IDBVR; SOT-23-5; MPN OPA388IDBVR

Connections:
+3V3: C404.1, R407.2, U401.1 (IN); also elsewhere on the board
GND: C401.2, C402.2, C404.2, C405.2, Q401.2 (S), Q402.2 (S), R406.2, U401.3 (GND), U402.2 (V-); also elsewhere on the board
INA_OUT: U402.3 (+); also elsewhere on the board
I_LOW: Q402.1 (G), R406.1; also elsewhere on the board
I_OFF: Q401.1 (G), R407.1; also elsewhere on the board
I_PLUS: Q403.2 (D); also elsewhere on the board
unnamed: C403.2, R404.1, U402.1
unnamed: C402.1, Q401.3 (D), R401.2, R402.1, R403.1
unnamed: Q402.3 (D), R402.2
unnamed: Q403.1 (G), R404.2, R405.1
unnamed: C401.1, R401.1, U401.2 (OUT)
unnamed: C403.1, R403.2, U402.4 (-)
SYS: C405.1, Q403.3 (S), R405.2, U402.5 (V+); also elsewhere on the board

Notes on the sheet:
VSET = 2,5 V -> I_H = 1,042 A
VSET = 1,205 V -> I_L = 0,502 A (Q402)
4. Fuente de corriente pulsada
U401 REF3325 -> R401 -> VSET -> R403 -> U402 OPA388 -> R404 -> Q403 P-MOS -> I_PLUS. I = VSET / (20 x RS) = 1,042 A / 0,502 A.
Componentes de soporte (desacoplo y polarizacion), conectados por etiqueta:
Etiqueta global: [n] = pagina donde continua la senal.

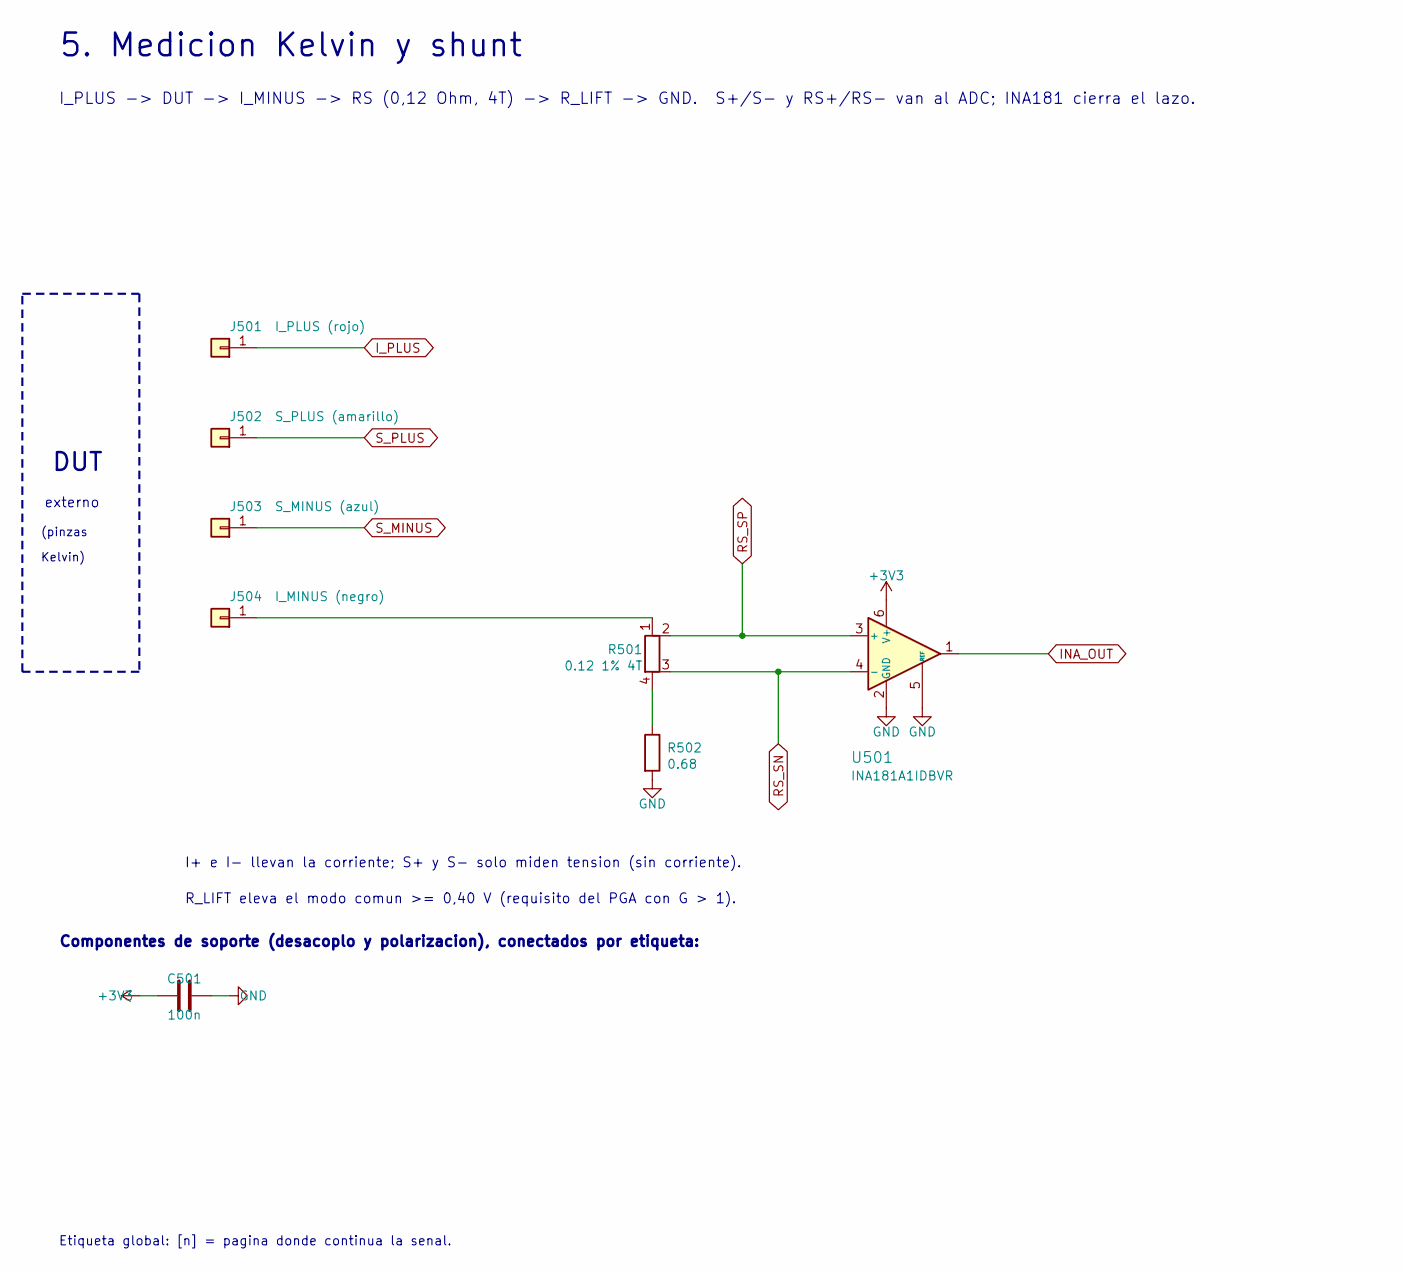
[picture p69: schematic 5_kelvin_shunt.kicad_sch, 5. Medicion Kelvin y shunt]

Parts:
C501: 100n; C_0603_1608Metric
J501: I_PLUS (rojo); Banana_Jack_1Pin; MPN Borne 4 mm de panel rojo (agujero 6 mm)
J502: S_PLUS (amarillo); Banana_Jack_1Pin; MPN Borne 4 mm de panel amarillo (agujero 6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
J503: S_MINUS (azul); Banana_Jack_1Pin; MPN Borne 4 mm de panel azul (agujero 6 mm)
J504: I_MINUS (negro); Banana_Jack_1Pin; MPN Borne 4 mm de panel negro (agujero 6 mm)
R501: 0.12 1% 4T; R_Shunt_Vishay_WSK2512_6332Metric_T1.19mm; MPN WSK2512R1200FEA
R502: 0.68; R_2512_6332Metric
U501: INA181A1IDBVR; SOT-23-6; MPN INA181A1IDBVR

Connections:
+3V3: C501.1, U501.6 (V+); also elsewhere on the board
GND: C501.2, R502.2, U501.2 (GND), U501.5 (REF); also elsewhere on the board
INA_OUT: U501.1; also elsewhere on the board
I_PLUS: J501.1; also elsewhere on the board
unnamed: J504.1, R501.1
unnamed: R501.4, R502.1
RS_SN: R501.3, U501.4 (-); also elsewhere on the board
RS_SP: R501.2, U501.3 (+); also elsewhere on the board
S_MINUS: J503.1; also elsewhere on the board
S_PLUS: J502.1; also elsewhere on the board

Notes on the sheet:
DUT
externo
(pinzas
Kelvin)
I+ e I- llevan la corriente; S+ y S- solo miden tension (sin corriente).
R_LIFT eleva el modo comun >= 0,40 V (requisito del PGA con G > 1).
5. Medicion Kelvin y shunt
I_PLUS -> DUT -> I_MINUS -> RS (0,12 Ohm, 4T) -> R_LIFT -> GND. S+/S- y RS+/RS- van al ADC; INA181 cierra el lazo.
Componentes de soporte (desacoplo y polarizacion), conectados por etiqueta:
Etiqueta global: [n] = pagina donde continua la senal.

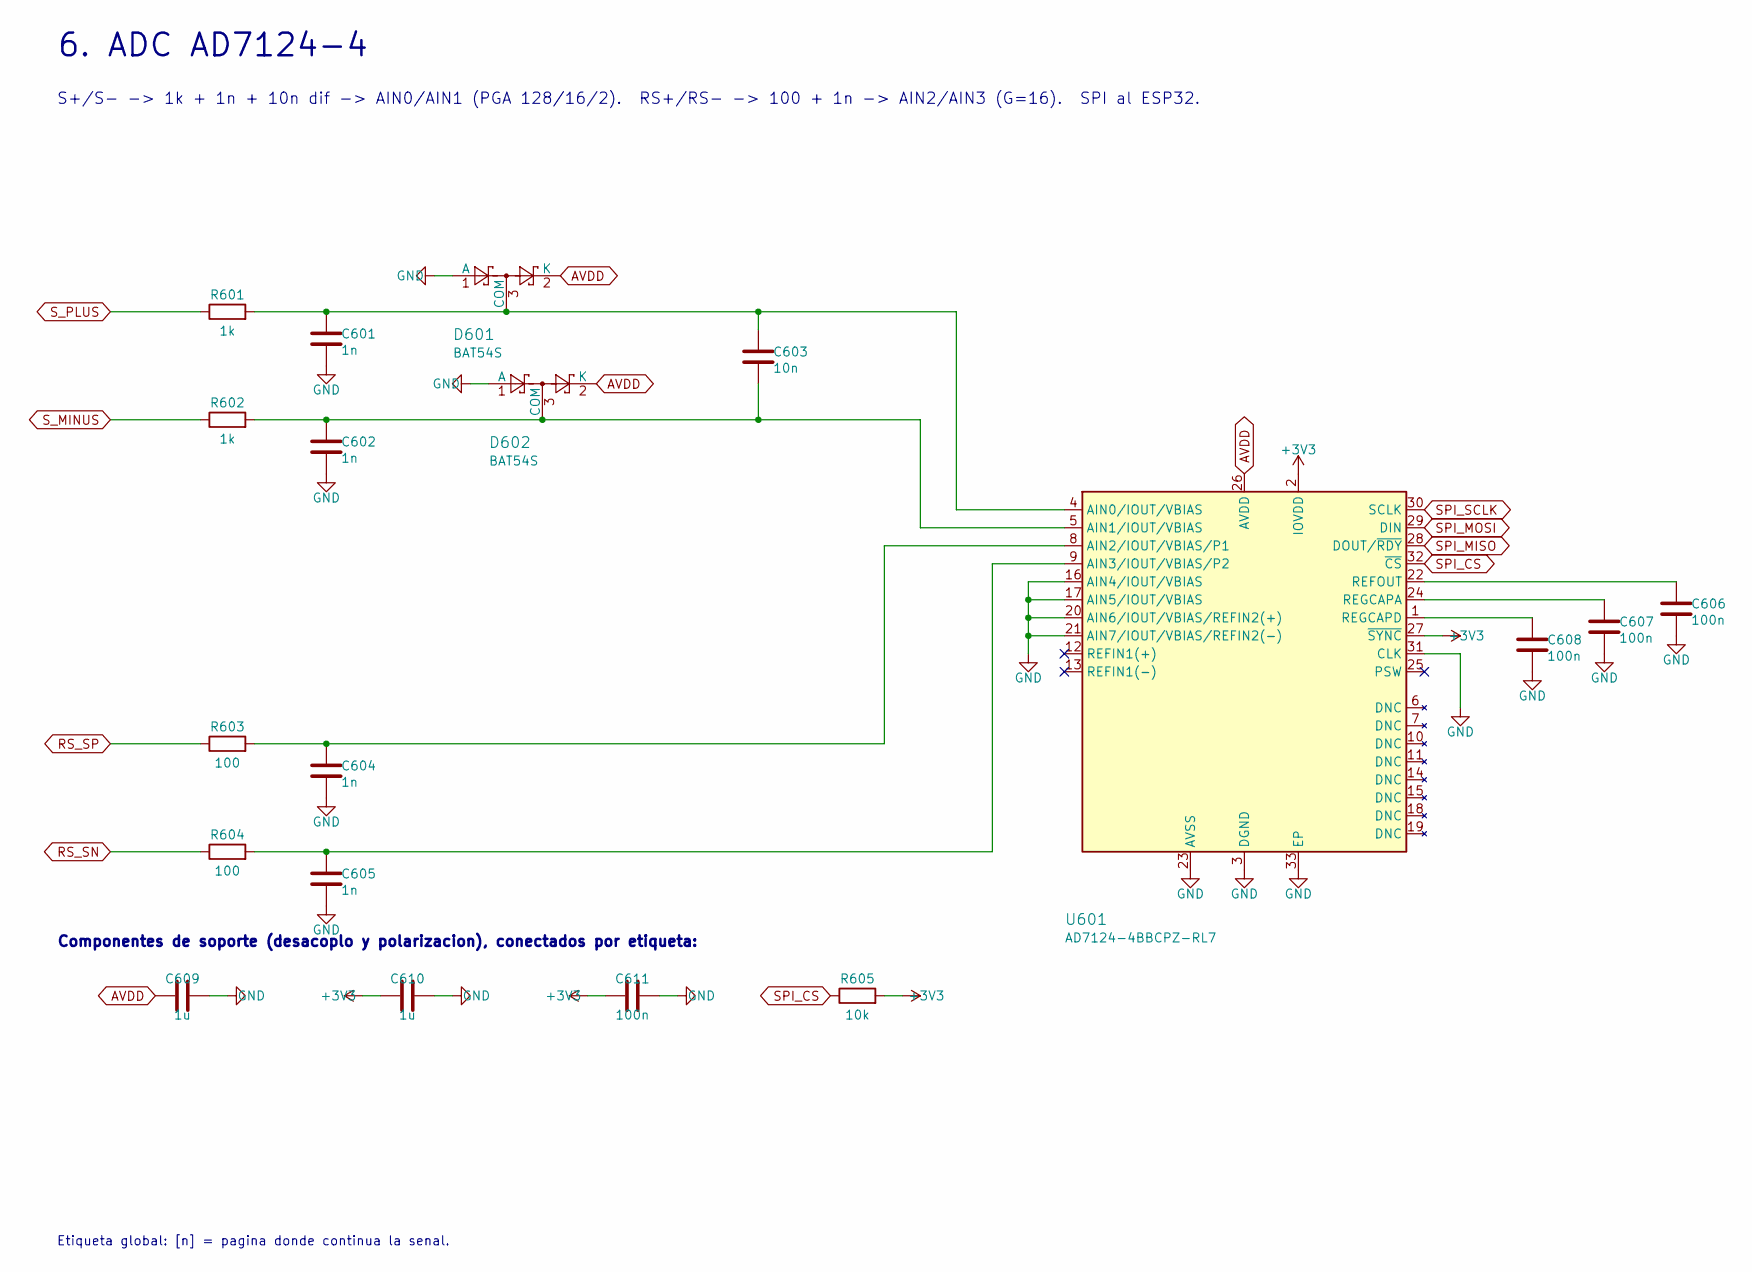
[picture p70: schematic 6_adc.kicad_sch, 6. ADC AD7124-4]

Parts:
C601, C602, C604, C605: 1n; C_0603_1608Metric
C603: 10n; C_0603_1608Metric
C606, C607, C608, C611: 100n; C_0603_1608Metric
C609, C610: 1u; C_0603_1608Metric
D601, D602: BAT54S; SOT-23; MPN BAT54S
R601, R602: 1k; R_0603_1608Metric
R603, R604: 100; R_0603_1608Metric
R605: 10k; R_0603_1608Metric
U601: AD7124-4BBCPZ-RL7; LFCSP-32-1EP_5x5mm_P0.5mm_EP3.6x3.6mm; MPN AD7124-4BBCPZ-RL7

Connections:
+3V3: C610.1, C611.1, R605.2, U601.2 (IOVDD), U601.27 (~SYNC); also elsewhere on the board
AVDD: C609.1, D601.2 (K), D602.2 (K), U601.26 (AVDD); also elsewhere on the board
GND: C601.2, C602.2, C604.2, C605.2, C606.2, C607.2, C608.2, C609.2, C610.2, C611.2, D601.1 (A), D602.1 (A), U601.3 (DGND), U601.16 (AIN4/IOUT/VBIAS), U601.17 (AIN5/IOUT/VBIAS), U601.20 (AIN6/IOUT/VBIAS/REFIN2(+)), U601.21 (AIN7/IOUT/VBIAS/REFIN2(-)), U601.23 (AVSS), U601.31 (CLK), U601.33 (EP); also elsewhere on the board
unnamed: C601.1, C603.1, D601.3 (COM), R601.2, U601.4 (AIN0/IOUT/VBIAS)
unnamed: C602.1, C603.2, D602.3 (COM), R602.2, U601.5 (AIN1/IOUT/VBIAS)
unnamed: C604.1, R603.2, U601.8 (AIN2/IOUT/VBIAS/P1)
unnamed: C605.1, R604.2, U601.9 (AIN3/IOUT/VBIAS/P2)
unnamed: C606.1, U601.22 (REFOUT)
unnamed: C607.1, U601.24 (REGCAPA)
unnamed: C608.1, U601.1 (REGCAPD)
RS_SN: R604.1; also elsewhere on the board
RS_SP: R603.1; also elsewhere on the board
SPI_CS: R605.1, U601.32 (~CS); also elsewhere on the board
SPI_MISO: U601.28 (DOUT/~RDY); also elsewhere on the board
SPI_MOSI: U601.29 (DIN); also elsewhere on the board
SPI_SCLK: U601.30 (SCLK); also elsewhere on the board
S_MINUS: R602.1; also elsewhere on the board
S_PLUS: R601.1; also elsewhere on the board

Notes on the sheet:
6. ADC AD7124-4
S+/S- -> 1k + 1n + 10n dif -> AIN0/AIN1 (PGA 128/16/2). RS+/RS- -> 100 + 1n -> AIN2/AIN3 (G=16). SPI al ESP32.
Componentes de soporte (desacoplo y polarizacion), conectados por etiqueta:
Etiqueta global: [n] = pagina donde continua la senal.

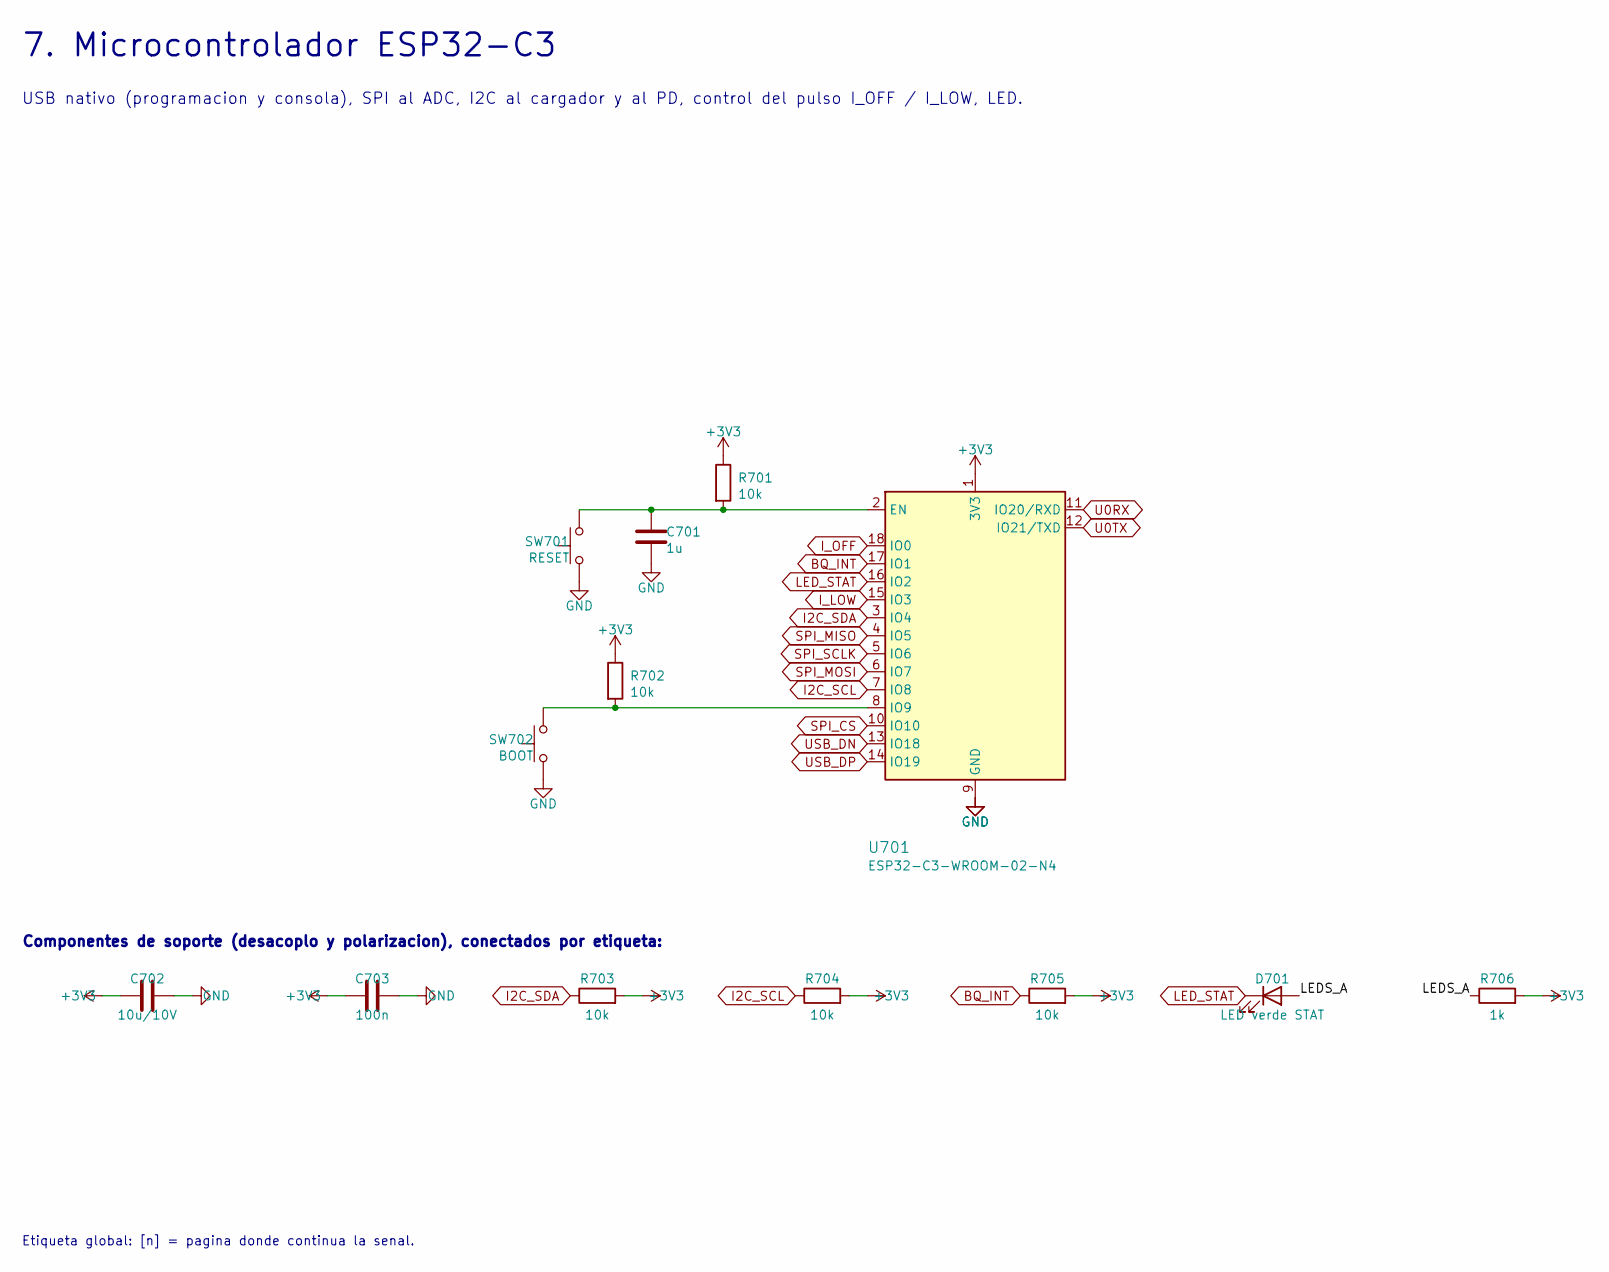
[picture p71: schematic 7_mcu.kicad_sch, 7. Microcontrolador ESP32-C3]

Parts:
C701: 1u; C_0603_1608Metric
C702: 10u/10V; C_0805_2012Metric
C703: 100n; C_0603_1608Metric
D701: LED verde STAT; LED_0603_1608Metric
R701, R702, R703, R704, R705: 10k; R_0603_1608Metric
R706: 1k; R_0603_1608Metric
SW701: RESET; SW_Push_SPST_NO_Alps_SKRK
SW702: BOOT; SW_Push_SPST_NO_Alps_SKRK
U701: ESP32-C3-WROOM-02-N4; ESP32-C3-WROOM-02; MPN ESP32-C3-WROOM-02-N4

Connections:
+3V3: C702.1, C703.1, R701.1, R702.1, R703.2, R704.2, R705.2, R706.2, U701.1 (3V3); also elsewhere on the board
BQ_INT: R705.1, U701.17 (IO1); also elsewhere on the board
GND: C701.2, C702.2, C703.2, SW701.1, SW702.1, U701.9 (GND), U701.19 (GND); also elsewhere on the board
I2C_SCL: R704.1, U701.7 (IO8); also elsewhere on the board
I2C_SDA: R703.1, U701.3 (IO4); also elsewhere on the board
I_LOW: U701.15 (IO3); also elsewhere on the board
I_OFF: U701.18 (IO0); also elsewhere on the board
LEDS_A: D701.2 (A), R706.1
LED_STAT: D701.1 (K), U701.16 (IO2)
unnamed: C701.1, R701.2, SW701.2, U701.2 (EN)
unnamed: R702.2, SW702.2, U701.8 (IO9)
SPI_CS: U701.10 (IO10); also elsewhere on the board
SPI_MISO: U701.4 (IO5); also elsewhere on the board
SPI_MOSI: U701.6 (IO7); also elsewhere on the board
SPI_SCLK: U701.5 (IO6); also elsewhere on the board
U0RX: U701.11 (IO20/RXD); also elsewhere on the board
U0TX: U701.12 (IO21/TXD); also elsewhere on the board
USB_DN: U701.13 (IO18); also elsewhere on the board
USB_DP: U701.14 (IO19); also elsewhere on the board

Notes on the sheet:
7. Microcontrolador ESP32-C3
USB nativo (programacion y consola), SPI al ADC, I2C al cargador y al PD, control del pulso I_OFF / I_LOW, LED.
Componentes de soporte (desacoplo y polarizacion), conectados por etiqueta:
Etiqueta global: [n] = pagina donde continua la senal.
