EDWARDPJ26/microohmetro-uis/hardware/kicad/microohmetro_v2.kicad_pcb

## KiCad design hardware/kicad/microohmetro_v2.kicad_pcb (continued)

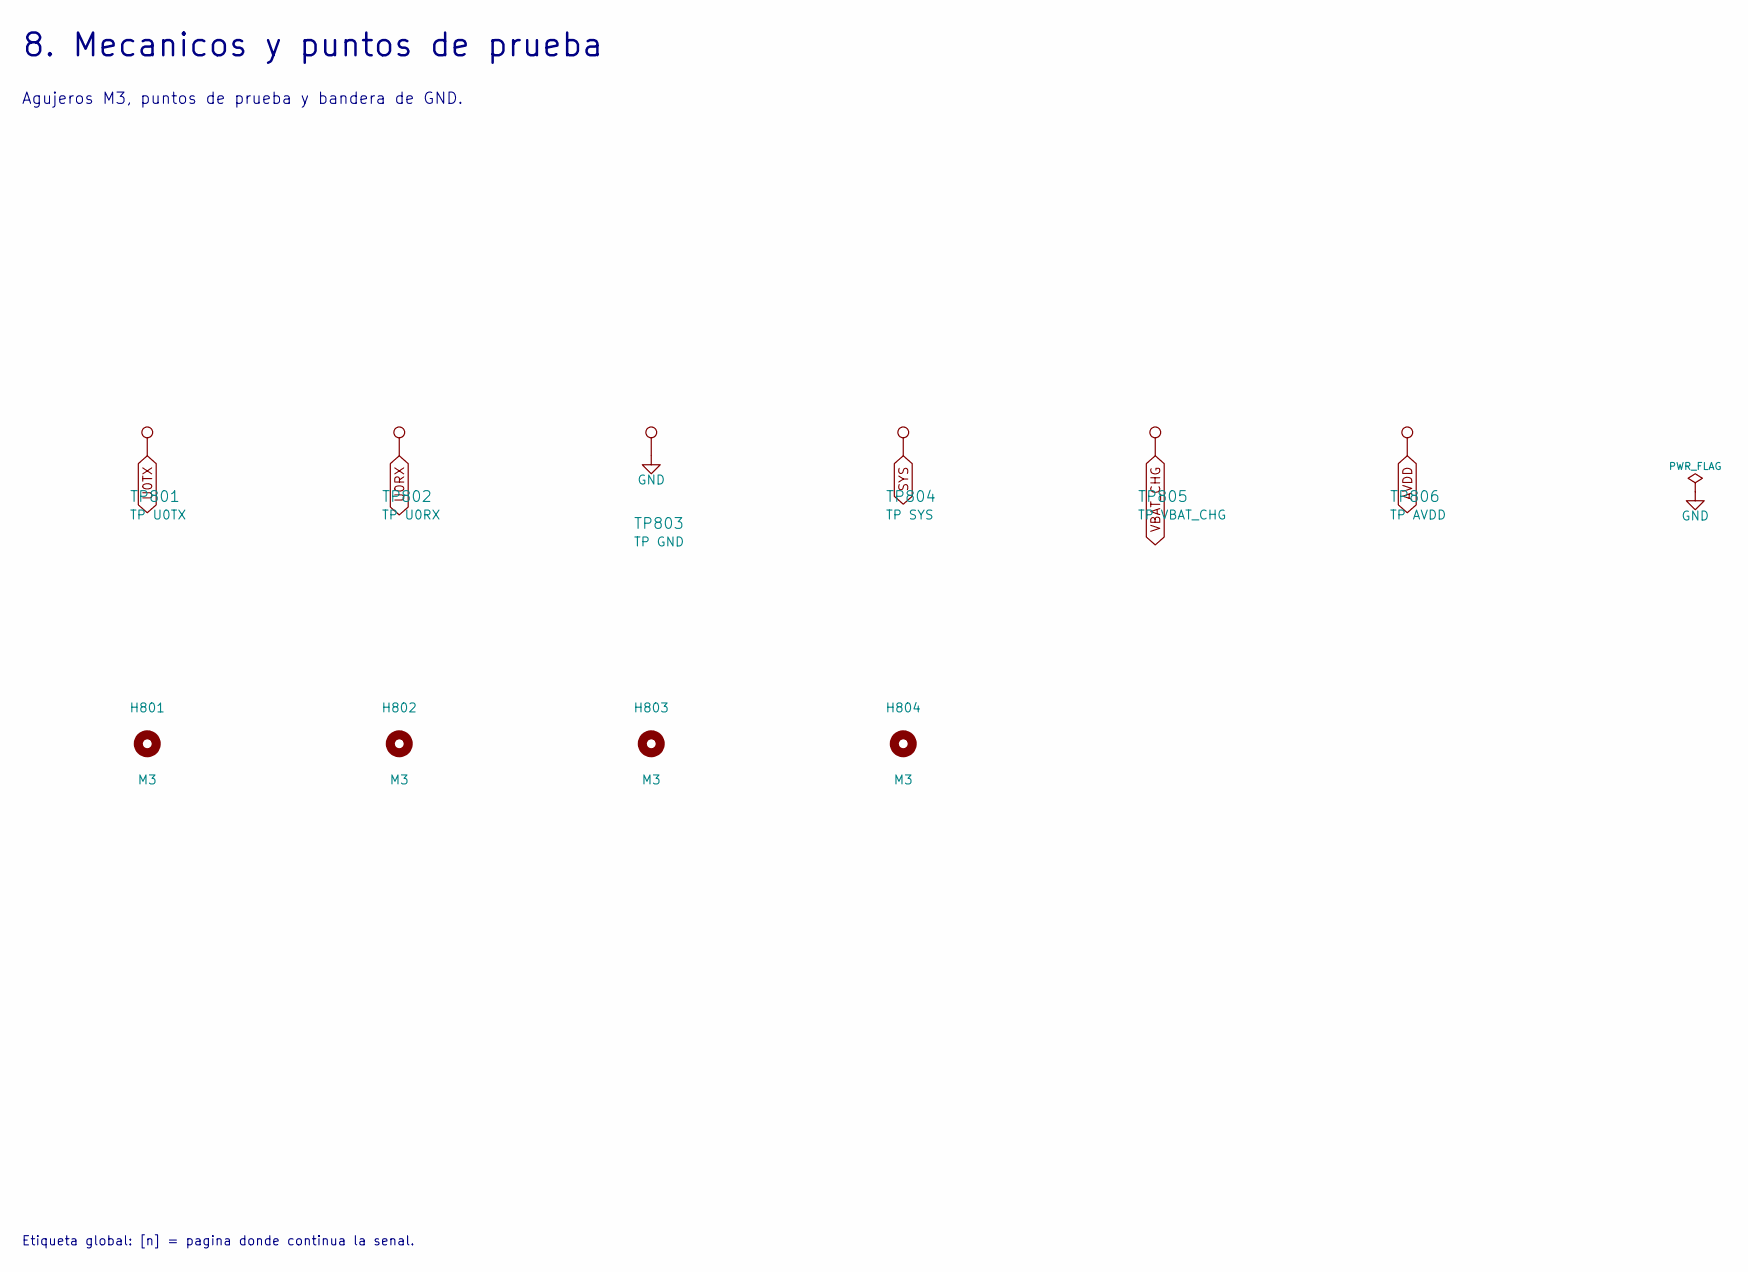
[picture p72: schematic 8_mecanicos.kicad_sch, 8. Mecanicos y puntos de prueba]

Parts:
H801, H802, H803, H804: M3; MountingHole_3.2mm_M3
TP801: TP U0TX; TestPoint_Pad_D1.5mm
TP802: TP U0RX; TestPoint_Pad_D1.5mm
TP803: TP GND; TestPoint_Pad_D1.5mm
TP804: TP SYS; TestPoint_Pad_D1.5mm
TP805: TP VBAT_CHG; TestPoint_Pad_D1.5mm
TP806: TP AVDD; TestPoint_Pad_D1.5mm

Connections:
AVDD: TP806.1; also elsewhere on the board
GND: TP803.1; also elsewhere on the board
SYS: TP804.1; also elsewhere on the board
U0RX: TP802.1; also elsewhere on the board
U0TX: TP801.1; also elsewhere on the board
VBAT_CHG: TP805.1; also elsewhere on the board

Notes on the sheet:
8. Mecanicos y puntos de prueba
Agujeros M3, puntos de prueba y bandera de GND.
Etiqueta global: [n] = pagina donde continua la senal.

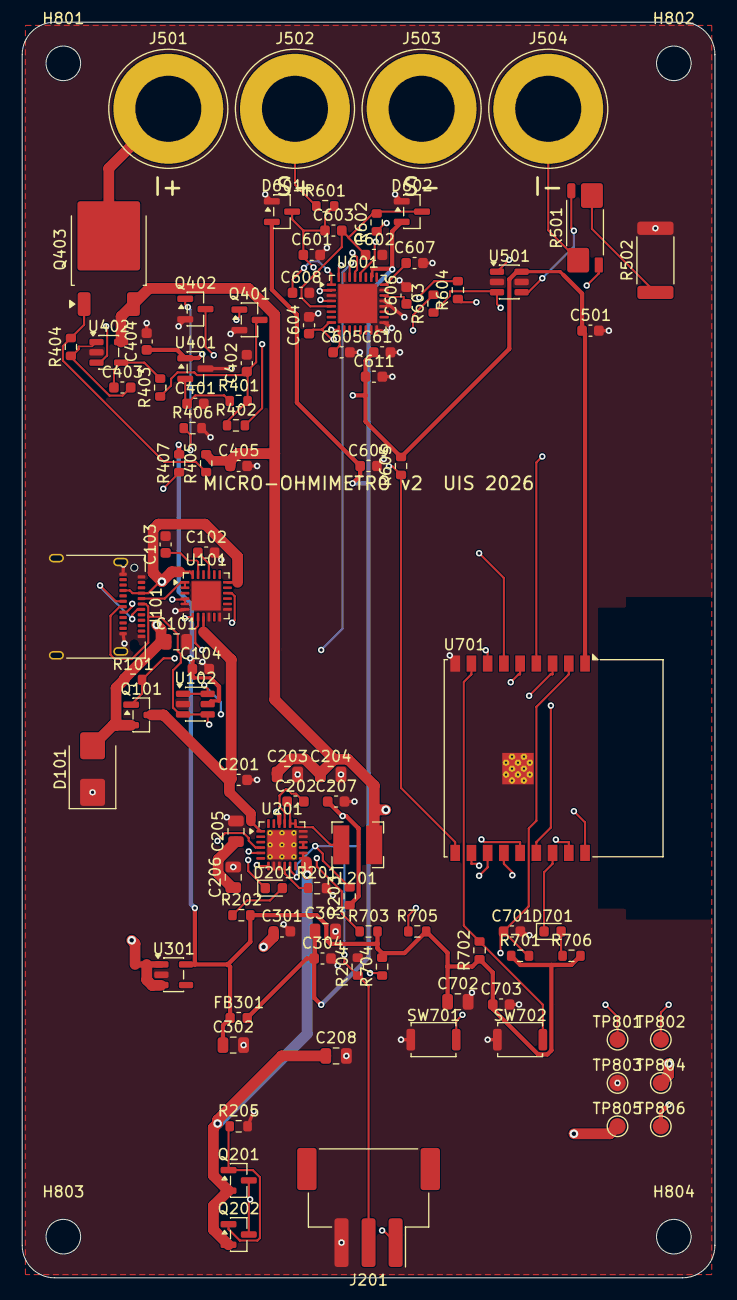
[picture p73: board microohmetro_v2.kicad_pcb from above]

Board: 4 copper layers, 64.0 x 116.0 mm, 103 parts (1 on the bottom side), 60 nets.
